jerrychen15487/-.-/fpga/docs/KEY2单一位流现场演示-2026-10-17.md

# KEY2 单一位流现场演示（2026-10-17）

> 此文保留首次已上板验证的“KEY2 短按四音测试”基线。新增长按回声的候选版
> 请参见 [KEY2 长按回声候选](KEY2长按回声候选-2026-10-17.md)；新候选
> 尚未上板，不能用本页的已验证结论代替其验收。

## 操作

- 上电／KEY0 复位后默认是正常演奏：电钢琴→ESP32→FPGA→音箱，KEY1 保持原来的画面切换与钢琴块暂停功能；SD 曲库、BLE 网站通信仍在工作。
- 短按 NEO Dock 板上的 KEY2 一次，进入四音频谱测试。无需弹琴，FPGA 内部约每 0.503 秒触发 G3、D4、A4、E5 四个音，沿用四声部 DDS、混音、FFT 和 HDMI 波形／频谱。即使此前停留在钢琴块页，测试时也强制显示频谱页。
- 再短按 KEY2 一次，返回正常演奏。切换时清除旧声部，避免演示和实琴残音叠加；正在按住的琴键要松开重按，才会重新发 Note On。
- KEY0 仍是复位，KEY1 原功能不变。摇杆三个按键目前接在 ESP32 一侧，本版不依赖它们，亦不要求改动 ESP32 固件或接线。

KEY2 是低有效的 Y12、1.5 V Bank 9 输入，约 10 ms 去抖；按住不会反复切换。SD 曲库控制器并不随模式切换复位，测试模式只切换音源及画面；测试时来自 ESP32 的 MIDI 仍可到达接收器，但不会进入音频声部分配器。曲库 UART 和 SD 访问仍继续。请不要在测试音播放时用钢琴弹奏判断 MIDI 是否正常，需先按 KEY2 返回演奏模式。

## 候选文件和验证范围

唯一合并候选位流：

`impl/pnr/midi_basic_synth_KEY2_INTEGRATED_CANDIDATE_2026-10-17.fs`

SHA-256：`00FD8D12518F0F753D42601936DCAAF342728666FEBC3F6AB9C898B4C1D00956`

隔离构建：`exp_timing/run_place2_key2_integrated_fix_20261017`，Gowin `gw_sh build.tcl` 退出码 0。50 MHz `sys_clk` 约束下 Fmax **54.310 MHz**，setup／hold 违例 **0／0**，CLS **24,168／29,952（81%）**；约束报告确认 KEY2 位于 **Y12/9、LVCMOS15、上拉**。按键去抖仿真通过。第一次合并构建出现 `timbre_select` 逻辑环路警告，已经将其改为固定异步上电复位、模式切换时同步设置；最终构建无该警告。

这是**静态时序和仿真通过、尚待实机验证的候选版**。先下载到 FPGA SRAM：确认上电可弹琴、KEY1 和网站仍正常；按 KEY2 自动响四音并看到多个分开的频谱峰；再按 KEY2 后重新弹琴正常。验证无误后，才考虑把同一位流写入 FPGA Flash 作为赛场上电版本。不要烧录旧的独立测试位流，也不要误选默认文件 `impl/pnr/midi_basic_synth.fs`。SD 卡不需清理或格式化。

已验证的回退位流为 `impl/pnr/midi_basic_synth_P2_SD_MOUNT_PREFETCH_52M_CANDIDATE_2026-10-17.fs`，SHA-256 `5730006B499B16DAFB9543A6A083903823B98C5666B3F99B16A9AB1B942EB75B`。
