jerrychen15487/-.-/fpga/docs/PCM5102A-I2S-接线与验收-2026-10-22.md

# PCM5102A 标准 I²S 链路：接线与验收

## 2026-10-24 实机状态

用户反馈：当前电钢琴输入下，PCM5102A 经 3.5 mm LINE OUT 接有源音箱已能**稳定发声**，原 PT8211 声路也正常。此前“只有向右掰音频插头才出声”的故障现象已消失；原因未通过拆检或通断测量单独确认，不能据此声称插座或焊点已被定位和修复。用户此前确认烧录的是 2026-10-22 19:41 的 `impl/pnr/midi_basic_synth.fs`；同内容副本封存为 `impl/pnr/midi_basic_synth_20261022_1941_PCM5102_USER_VERIFIED.fs`，SHA-256 `8479F2EDF73ECB4C0DDF4F70C60168FD5C2534DA671C8F4F285C80270A318534`。对应时序报告也同名前缀封存；报告显示系统域 Fmax 51.716 MHz、像素域 29.585 MHz、setup/hold 违例端点 0/0。这些是构建报告和用户实机反馈的组合，不是独立仪器测得的 I²S 波形。

当前 `src/top.v`、`src/pcm5102_i2s_tx.v`、`src/midi_basic_synth.cst` 的 SHA-256 分别为 `5D305ED6E8BA5A711EBAFFF07B18E54E436D2B3CCF998AC5E4E0AC74BE73136C`、`B3A379B4CA89F01CAD818B9F0D3DDC8315EBEF682045BB0C3BC609602A40AED7`、`8EB71322EA3CD0820E9834564D209BCA57A2E529738B128A4097FB30796688BB`；这些文件时间早于上述位流，但完整工程源清单未在此逐项封存。

因此“标准 I²S→外置 DAC→有源音箱发声”已有实机观察；**完整琴键输入→DAC 模拟输出 ≤10 ms** 及扩展 ≤5 ms/抖动仍未实测，不能由 FPGA 内部 GAO、ESP32 日志或本次听音推出。下一步优先保留接线照片、听音视频及同一版本的报告，具备合适仪器后再测完整链路延迟。

本改动保留 ESP32-S3、板载 PT8211 和扬声器原链路。FPGA 另外在 J8/PMOD1 输出标准 I²S，向外置 PCM5102A 提供与板载 DAC 相同的单声道样本（复制到 L/R）。不要将 PCM5102A 的 OUTL/OUTR 直接接到无源扬声器；它是线路电平输出，先接有源音箱或合适的耳机放大器，初次通电先调低音量。

## 实物接线

依据 `Tang_Mega_NEO_Dock-60K_31004_Schematics.pdf` 的 J8 与 PMOD1 管脚，结合用户模块照片上的丝印：

| FPGA NEO Dock J8 | FPGA 封装脚 | PCM5102A 模块 | 信号 |
|---|---|---|---|
| pin 11 | Y21 | BCK | 位时钟 3.125 MHz |
| pin 9 | AB21 | LCK（也称 LRCK/WS） | 左右声道时钟 48.828125 kHz |
| pin 7 | AA20 | DIN | 串行音频数据 |
| pin 3 或 4 | — | GND | 公共地 |

模块的 **VIN 接 5 V 电源**（照片所附模块资料标注 5 V），**不要接 J8 的 3.3 V 电源 pin 1/2**；同样绝不可把 5 V 接到 FPGA 的 BCK/LCK/DIN。用万用表确认供电极性与共地后再通电。若使用独立 5 V USB 电源，仍须把该电源地与 J8 GND 相连。ESP32 现有线路保持原样，J8 不与 ESP32 的 J9/PMOD0 线混接。

SCK 是 DAC 主时钟输入，本设计采用 PCM5102A 数据手册的 **BCK 内部 PLL 三线模式**，不从 FPGA 输出 SCK。该模式要求 SCK 保持在地电平。先断电用万用表核对模块 SCK 与 GND 是否已由板上电阻下拉；如果没有，需把模块 **SCK 接 GND**，不可让其悬空。若模块有 FMT/XSMT 引脚且未被板上电路固定，需使 FMT=低（标准 I²S）、XSMT=高（取消静音，必须是模块的 3.3 V 逻辑电源而非 5 V）。不要盲接照片中未焊出的配置焊盘，先检查模块实际电路与电压。

针对用户实际购买的 VIN/A3V3、H1L～H4L 版本，[芯路城模块资料](https://www.xinlucity.com/?s=resourcedetail/index/id/387.html)明确要求**四组焊桥各选一侧与中间焊盘短接**；未焊通可能无声或有杂音。以背面丝印正向观察，排障配置为：H1L（FLT）右＋中＝正常延迟、H2L（DEMP）右＋中＝关闭去加重、H3L（XSMT）左＋中＝取消静音、H4L（FMT）右＋中＝标准 I²S。每组不得把左、中、右三端全短接。网页所附简化原理图不是该模块原厂原理图，不能凭商品图认定实物焊桥已经导通；先断电目视检查，必要时用万用表测通断，不要盲目补焊。该版本的 A3V3 被厂家标为 3.3 V 输出，不接外部 5 V。详细来源与未确认事项见 [芯路城 387 资料核对](PCM5102A-芯路城387资料核对-2026-10-23.md)。

## 时序与软件配置

- 50 MHz 系统时钟，每 16 个系统时钟为一个 BCK 周期；64 个 BCK 为一个立体声帧。因此 BCK=3.125 MHz、LRCK=48.828125 kHz，与现有 1024 时钟/样本的合成速率一致，无需改 DDS 频率表。
- 每声道 32 位槽，前 16 位为有符号二补码样本，后 16 位为 0；LRCK 翻转后延迟 1 个 BCK 才发送 MSB，数据在 BCK 下降沿改变、上升沿被 DAC 采样。
- 数据手册规定 FMT 低选标准 I²S，XSMT 高为取消静音；三线模式需要 SCK 为低。`src/pcm5102_i2s_tx.v` 只负责数字串行化，模块引脚配置由硬件保证。
- `src/top.v` 同时驱动 `HP_*` 和 `PCM_*`；ESP32 固件、MIDI 消息和画面无需改变。

## 验收顺序

1. 未接 PCM5102A 时，先运行 `iverilog -g2012 -s tb_pcm5102_i2s_tx -o sim/tb_pcm5102_i2s_tx.vvp sim/tb_pcm5102_i2s_tx.v src/pcm5102_i2s_tx.v`，再运行 `vvp sim/tb_pcm5102_i2s_tx.vvp`。仿真应显示 `PASS`。
2. 在 Gowin GUI 中用当前工程重新综合、布局布线。只有 **系统域 Fmax ≥ 50 MHz、setup/hold 违例均为 0、无 unrouted nets** 时才烧录新位流；不能沿用旧 `.fs` 证明新接口已实现。构建前保留原已验证 `.fs` 的独立副本和 SHA-256。布局布线由用户在 GUI 执行。
3. 先只接地和 5 V，量模块 VIN 与 GND 电压。断电后接 BCK/LCK/DIN。不要热插拔排针。
4. 用逻辑分析仪在 J8 测 BCK、LCK、DIN：BCK 约 3.125 MHz、LCK 约 48.828 kHz；每个 LCK 半周 32 个 BCK；LCK 变化后一个 BCK 为 I²S 延迟位。先不接模拟输出也可以核对数字时序。
5. 把 OUTL/OUTR/GND 接有源音箱或线路输入，用电钢琴发 MIDI 60 持续音：应同时能从板载扬声器与外置 DAC 听到相同音高/音色；注意可能有不同的音量和 DAC 固有延迟。确认静音、音符释放、四复音、P/O/A 模式和效果器均未退化。
6. 留存 Gowin 时序报告、逻辑分析仪 I²S 波形、模块供电和接线照片、外置 DAC 实际发声视频。只有步骤 2–5 完成后才能把“标准 I²S→DAC 实机闭环”标为完成。完整“琴键至模拟输出 ≤10 ms”还需单独测量，不能由本仿真推出。
