jerrychen15487/-.-/fpga/docs/PCM5102A-芯路城387资料核对-2026-10-23.md

# PCM5102A 模块：芯路城 387 资料核对（2026-10-23）

范围：仅核对用户指定的[芯路城 PCM5102A 客户资料页](https://www.xinlucity.com/?s=resourcedetail/index/id/387.html)及其所附[TI PCM510xA 规格书](https://testxinlu.oss-cn-beijing.aliyuncs.com/static/upload/file/warehouse/2026/05/28/1779939874559971.pdf)。不把商品图当作用户实物焊接状态的证据，也不据此认定现有无声的根因。

## 经资料确认

| 项目 | 结论与本项目所需状态 | 来源 |
| --- | --- | --- |
| 模块电源 | 该客户资料所述模块供电为 **5 V**，`VIN` 是输入；`A3V3` 被标为模块 **3.3 V 输出**，不可当作 5 V 输入。`GND` 为数字公共地，`AGND` 为模拟输出参考地。 | [芯路城参数及引脚表](https://www.xinlucity.com/?s=resourcedetail/index/id/387.html) |
| 三线 I²S | 数字音频线为 `BCK`、`LRCK`、`DIN`，主控与 DAC 必须共地。TI 规格书第 9.3.5.3 节说明：无外部主时钟时，`SCK` 在 BCK/LRCK 正确运行期间保持接地，连续 16 个 LRCK 周期后内部 BCK PLL 才启动。因此本项目未提供 SCK 时，应**接 GND，而不是悬空**。 | [芯路城 FAQ](https://www.xinlucity.com/?s=resourcedetail/index/id/387.html)；[TI 规格书 §9.3.5.3](https://testxinlu.oss-cn-beijing.aliyuncs.com/static/upload/file/warehouse/2026/05/28/1779939874559971.pdf) |
| H1L～H4L 通则 | 此模块厂商资料明确说 **四组焊桥均须选一侧短接**，未短接可造成无声、杂音。资料定义为“左＋中＝高；右＋中＝低”。这里的左右应以背面丝印正向观察；每组三焊盘**不得全桥接**。 | [芯路城焊桥说明及 FAQ](https://www.xinlucity.com/?s=resourcedetail/index/id/387.html) |
| H1L = FLT | 左＋中：高、低延迟滤波；右＋中：低、正常延迟滤波。排障首选右＋中（正常），两者都不应悬空。 | [芯路城焊桥说明](https://www.xinlucity.com/?s=resourcedetail/index/id/387.html)；[TI 引脚定义](https://testxinlu.oss-cn-beijing.aliyuncs.com/static/upload/file/warehouse/2026/05/28/1779939874559971.pdf) |
| H2L = DEMP | 左＋中：高、44.1 kHz 去加重开启；右＋中：低、关闭。排障首选右＋中（关闭），两者都不应悬空。 | [芯路城焊桥说明](https://www.xinlucity.com/?s=resourcedetail/index/id/387.html)；[TI 引脚定义](https://testxinlu.oss-cn-beijing.aliyuncs.com/static/upload/file/warehouse/2026/05/28/1779939874559971.pdf) |
| H3L = XSMT | 左＋中：高、取消软静音；右＋中：低、软静音。**本项目须左＋中。** | [芯路城焊桥说明](https://www.xinlucity.com/?s=resourcedetail/index/id/387.html)；[TI 规格书 §9.3.3](https://testxinlu.oss-cn-beijing.aliyuncs.com/static/upload/file/warehouse/2026/05/28/1779939874559971.pdf) |
| H4L = FMT | 左＋中：高、左对齐；右＋中：低、标准 I²S。**本项目须右＋中。** | [芯路城焊桥说明](https://www.xinlucity.com/?s=resourcedetail/index/id/387.html)；[TI 规格书 §9.3.2.2](https://testxinlu.oss-cn-beijing.aliyuncs.com/static/upload/file/warehouse/2026/05/28/1779939874559971.pdf) |
| 模拟输出 | 板载 3.5 mm 插座为左右声道和模拟地，另引出 `LROUT` / `ROUT` / `AGND`。板卡资料声称额定输出约 2 VRMS。 | [芯路城参数与输出端说明](https://www.xinlucity.com/?s=resourcedetail/index/id/387.html) |

**对先前排障建议的修正：**此前“只核对 H3L/H4L，H1L/H2L 先不要动”不够完整。针对这份厂商资料，应在**断电状态**下检查 H1L、H2L 是否也各自可靠地选通一侧；若未焊通，它们是新增的可疑点。但不能凭网页断言用户手上四组焊桥已虚焊，是否导通需要实物近照或万用表通断测量。此次核对不要求盲目重焊。

## 仍未由资料确认

- 网页明确注明“**无厂家原厂原理图，图示仅为原理参考，和实物存在出入**”。因此不能把其简化原理图用于推断这块实物的每条 PCB 走线、3.5 mm 插座焊脚接触状态，或 H1L～H4L 的实际导通情况。[来源](https://www.xinlucity.com/?s=resourcedetail/index/id/387.html)
- 厂商所附 ESP32-S3 Arduino“小星星”例程只是可选的**独立模块隔离测试**：其 GPIO4/5/6 是例程自己的 I²S 引脚，**不是当前 FPGA→DAC 的接线定义**，也不证明目前 FPGA 排针有时钟输出。[来源](https://www.xinlucity.com/?s=resourcedetail/index/id/387.html)
- 厂商 FAQ 将“按压板才发声”归因于未共地，但用户当前已称共地、线缆正常。它是常见原因，不是对这块实物的诊断结果。[来源](https://www.xinlucity.com/?s=resourcedetail/index/id/387.html)
- 用户此前 H3L 左、H4L 右的描述与目标方向一致；**H1L/H2L 当前焊接状态、供电实际电压、SCK 电平、BCK/LRCK/DIN 实际波形、3.5 mm 插座连续性均未实测**。PT8211 正常仅说明原音频主链路工作，不能替代这些验证。

## 下一步无损检查顺序

1. 全部断电，目视核对 H1L～H4L 每组都有**仅一侧**与中心连接；目标可设为 H1L 右、H2L 右、H3L 左、H4L 右。先记录现状，切勿凭模糊照片改焊。
2. 检查 `VIN→5 V`、`GND→共地`、`SCK→GND`、`BCK/LRCK/DIN` 没有对调；不向 `A3V3` 输入电源。所有拔插均在断电下完成。
3. 若有万用表，断电测四组焊桥通断，上电测 VIN、XSMT、FMT、SCK 的直流电平；这些测量才能把“焊接方向正确”和“实际导通”区分开。
4. 若四组控制与供电均可靠仍无声，再查数字时钟与 3.5 mm 模拟支路；不因网页资料而修改已工作的 ESP32/PT8211 链路或重烧位流。
