jerrychen15487/-.-/fpga/docs/赛题二与团队联调要求原文核对-2026-10-17.md

# 赛题二与团队联调要求原文核对

核对日期：2026-10-17。本文只整理要求和出处，不根据文件存在推断功能已经通过实机验收。官方赛题、个人讲解 PPT、团队项目约定是三个不同层级。

## 资料优先级

1. 官方《全国大学生嵌入式芯片与系统设计竞赛'2026-高云半导体.pdf》，PDF 文件第 15–16 页（文内印刷页 13–14）：选题二原文；其中印刷页 14 还规定振荡器统计和现场验证。
2. `FPGA2026_pre2.pptx` 及同名 PDF，第 9–14 页：讲解者对选题二的转述、例子和建议，不是新的官方条款。第 14 页关于演奏维度的整理明确属于个人理解。若与官方原文冲突，按前者。
3. `团队资料/项目目标效果与实现方法(1).md`、`团队资料/FPGA开发与联调计划(1).md`、`esp32_local/PROTOCOL.md`：团队确定的产品目标、阶段验收和传输协议；不是官方评分细则。团队计划标注更新日 2026-10-11，部分目标已被后续资源取舍调整，应用当前工程与实测证据复核。

## 官方设计要求与基础指标

以下均来自官方 PDF 文件第 15 页（印刷页 13）；PPT PDF 第 9–11 页转述了这些内容。

| 编号 | 官方要求的可检验意思 | 需要注意的边界 |
|---|---|---|
| 设计总则 | FPGA 是核心并行计算平台，在 HDL 中逐样本、逐声部实时合成；允许波表采样、加法、FM、物理建模等算法；最终通过 **I²S 接口至 DAC** 发声 | 选用哪种算法不被固定，但音频生成不能搬到 ESP32/软核；I²S 是设计总则的明确输出路径，不应因其未列为基础条目的编号而忽略 |
| 基础 1 | 自主设计演奏交互形态，基于传感器精准采集动作，至少 **2 个独立可控维度**，逻辑稳定、适于演奏 | 原文举电容触摸、光电、压力、无接触手势等；未明确“现成 USB 电钢琴 + 自研摇杆”能否完全满足“自研交互”口径，需实物演示并向主办方确认，不能仅凭 PPT 的钢琴例子断言合规 |
| 基础 2 | FPGA HDL 完成完整音频生成通路，逐样本运算，控制信号到音频输出总延迟 **≤10 ms** | 必须测整条实际链路；仅 SPI 发送耗时或 FPGA 内部理论时延不等于总延迟 |
| 基础 3 | 基础复音 **≥4**，四路及以上独立声部同时发声；逐音逐样本生成，支持单音实时变调、ADSR、多声部混音 | 禁止直接播放预录 PCM、预置推流、整段录音触发；证明应包括同时可闻、变调/包络及 RTL 证据 |

“滑音/颤音”没有列在基础 1–3 的文字里，列在拓展 2 的表情效果中。基础 3 的“单音实时变调”仍需独立说明；它不能被误读为必须有专用弯音轮，但应能在音符发声过程中调整频率。

## 官方拓展指标与现场标准

均来自官方 PDF 文件第 15–16 页（印刷页 13–14），PPT PDF 第 12–13 页是转述。

| 编号 | 原文要求 | 验收解释 |
|---|---|---|
| 拓展 1 | **≥32 复音，或单音加法合成分量 ≥32 路，或多条并行物理建模运算单元** | 三种是“或”，不要求同时达成；不得把谐波表项自动都算成独立振荡器 |
| 拓展 2 | **≥3 维**演奏表情，力度动态、滑音、颤音等；**≥2 种乐器音色**自由切换；FPGA 内部实现混响、延迟、合唱等数字效果器 | 需要证明控制、两音色与真实 FPGA 效果处理，不能仅有静态标签；原文未规定每一种列举效果都必须同时实现 |
| 拓展 3 | 演奏延迟 **≤5 ms** 且确定性无抖动；FPGA 实时生成 LED 指引、李萨如、实时频谱、波形等可视化反馈 | 列举的画面是类型举例，不表示一个屏幕必须同时显示四类；≤5 ms 仍需整机实测和抖动数据 |
| 拓展 4 | 脱机演奏 LED 曲目指引；可搭蓝牙/手机 App，支持在线曲谱下载、键位自定义、录音回传等 | “可搭载”部分是可选增强。下载曲谱不等于已完成离线 LED 指引；谱面/钢琴块、练习判分是团队自加的较大产品目标 |
| 核心评分 1 | 完整独立振荡器须包含独立相位累加器、频率调控、包络；波表单次查表不按谐波计数；加法按运算分量、FM 按调制运算器、物理建模按并行弦/模态单元计 | 不能仅依据“4 声部 × 6 泛音 = 24”报官方独立振荡器数；需 RTL 对照具体结构及“同时活跃可闻”证据 |
| 核心评分 2 | 吞吐量按“**同时活跃可闻独立振荡器总数 × 实际音频输出采样率**” | 过采样不叠加加分；应记录实际采样率、实际可闻单元数 |
| 现场验证 | 测试模式输出多路不同频率，频谱显示对应数量独立谱峰，并用 RTL 证明纯硬件实时合成、无预录音频播放 | 单位流按键测试模式有助于此项，但最后仍应保存实测截图/视频和代码对应关系 |

官方 PDF 没有提供选题二逐项分值、100 分评分表或明确“做完基础即可得多少分”。不应凭 PPT 的经验性话语推定得分。

## 团队联调与产品约定，不能混作赛题基础

来源：`团队资料/FPGA开发与联调计划(1).md` 第 1–6 节、`团队资料/项目目标效果与实现方法(1).md` 第 1–2 节、`esp32_local/PROTOCOL.md` 第 2–3 节及附录 A。

| 阶段 | 团队验收目标 | 与赛题的关系 |
|---|---|---|
| F0 接口 | SPI/UART 接线、电平、存储容量/profile、无引脚冲突 | 工程集成前提 |
| F1 实时接收 | SPI Mode0、一次 CS 收 48 位、FIFO/READY 背压、本地时间戳；模拟/实琴数量和值一致，64 事件突发不丢 | 为 ≥4 复音、低延迟提供输入证据；不是独立官方指标 |
| F2 音源 | ≥4 声部、力度/ADSR/踏板、重复音和释放、混音、I²S/DAC、控制至音频 ≤10 ms | 与官方基础直接重叠；团队额外写明踏板和重复音细节 |
| F3 曲库传输 | UART v2 的 CAPS/STATUS/LIST/CRC/命令；非易失数据/进度、删除、断电续传、坏包不发布 | 拓展 4 和产品可靠性；团队原计划多首并存，后续单曲资源取舍要更新合同，不能以旧计划判当前版已经达到多首 |
| F4 阅读 | 本地选曲、五线谱/简谱 PAGE/BITMAP、HDMI；离线可阅读且弹琴 | 团队产品目标，不是官方基础 |
| F5 练习 | 三模式、BPM、钢琴块、谱面跟随、起音/保持释放/力度/踏板评分、暂停恢复 | 团队产品目标，不是官方评分指标 |
| F6 扩展 | ≥32 复音、≥2 音色、FPGA 音效和实时可视化；外部传感器滑音/颤音 | 对应官方拓展 1–3，但应逐项量化 |
| F7 终验 | 全模式、BLE 并发、长时、掉电/恢复、SPI 与整机时延、演示证据 | 系统性证明，尚须逐项目证据 |

协议另明确：ESP32 USB Host 将 USB-MIDI 变成 6 字节 SPI 事件；ESP32 SPI2 主机 GPIO12/11/10，READY GPIO13 高电平允许启动，双方 3.3 V 共地；曲库 UART1 为 1 Mbaud 全双工、BLE↔UART v2；PSC2 文件按 512 字节块传输。ESP32 只是代理，目录及持久进度应由 FPGA 负责。具体当前接线和固件构建配置仍以实物/工程核对，不用旧文档中的“未联调”历史状态覆盖新证据。

## 尚需澄清的口径

- 赛题设计要求和基础 1 都强调“自研交互”；团队文档把电钢琴输入列为已采用方案，但没有主办方书面确认此组合如何计创新/自研交互。后续摇杆/按键可加强自研部分。
- 官方“延迟 ≤5 ms 且确定性无抖动”未给测量起止点、测试负载、允许抖动绝对值；需记录自己的仪器、输入触发点、DAC/音箱测点、样本数、最大/最小，必要时咨询主办方。
- 官方对多条加法分量的计数口径需要 RTL 结构和同时可闻验证；不同于简单谐波数量。
- 团队 F3 多首/多未完成任务是原计划，而当前可能为单曲容量版。若以单曲版参赛，应更新团队 CAPS/演示预期并标明范围，不声称满足旧 F3 的多首矩阵。
