jerrychen15487/-.-/fpga/docs/四音频谱测试模式-2026-10-17.md

# 四音频谱测试模式（2026-10-17）

> 历史记录：下文描述的是早期“正常／测试两个位流”方案。现已整合为
> KEY2 切换的单一候选位流，赛场操作请以
> [KEY2 单位流演示说明](KEY2单一位流现场演示-2026-10-17.md)为准。

此模式专供赛题现场验证，不替代日常演奏位流。`top.v` 的
`SPECTRUM_TEST_MODE` 默认为 0；独立构建目录
`exp_timing/run_place2_spectrum_test_no_store` 仅把该参数设为 1。

测试模式让 FPGA 内部每约 0.503 秒向原有声部分配器发出四个
Note On：G3、D4、A4、E5（MIDI 55/62/69/76，力度 100）。四声部仍由
`basic_dds_synth` 逐样本实时生成和混音，使用现有风琴音色；并非播放
PCM 文件。频谱模块对音频做 16:1 降采样后的 64 点 FFT，理论频段间隔
约 47.68 Hz。这四个基频分别靠近第 4、6、9、14 号频段。

为了避免测试位流的时序被无关的 SD 曲库回复路径限制，测试模式关闭
曲库模块，SD-CS 保持高电平、时钟停止、网站串口 TX 保持空闲；所以
此模式下不能验证 MIDI 输入、网站 CAPS/LIST、曲谱预览。正常模式保留
上述功能，其构建源文件与主工程一致。

| 构建 | setup/hold 违例 | 50 MHz 系统时钟 Fmax | CLS |
| --- | ---: | ---: | ---: |
| 正常模式 | 0/0 | 52.671 MHz | 24087/29952 (81%) |
| 专用频谱测试模式 | 0/0 | 55.719 MHz | 13340/29952 (45%) |

`tb_spectrum_test_pattern` 检查两轮四音事件序列；
`tb_spectrum_test_audio` 连通真实四个 DDS、混音和 FFT，并在仿真的
第二帧确认 4/6/9/14 号频段均高于左右相邻频段。两项仿真通过。
这不等于已经完成实机屏幕和听感验收。

待实机烧录的唯一测试位流：
`impl/pnr/midi_basic_synth_SPECTRUM_4TONE_TEST_CANDIDATE_2026-10-17.fs`
（SHA-256 `5B8E6A5219FEC0429622FA1337551551C2FBE8D1757AD4F536AA0E932BB6F019`）。
下载到 SRAM 即可，不写 FPGA Flash，不清 SD 卡。预期无需弹琴也会
听到重复四音和弦，波形/频谱页出现四处独立基频峰。测试后烧回用户已
实机验证的正常位流
`impl/pnr/midi_basic_synth_P2_SD_MOUNT_PREFETCH_52M_CANDIDATE_2026-10-17.fs`
（SHA-256 `5730006B499B16DAFB9543A6A083903823B98C5666B3F99B16A9AB1B942EB75B`）。

本轮未修改 ESP32 固件、网站或 SD 卡内容，也未替用户烧录 FPGA。
