jerrychen15487/-.-/fpga/impl/pnr/midi_basic_synth_20261022_1941_PCM5102_USER_VERIFIED_tr_content.html

# Timing Messages

Report Title | Timing Analysis Report
Design File | C:\Users\ASUS\Desktop\FPGA_prpject\midi_basic_synth\impl\gwsynthesis\midi_basic_synth.vg
Physical Constraints File | C:\Users\ASUS\Desktop\FPGA_prpject\midi_basic_synth\src\midi_basic_synth.cst
Timing Constraint File | C:\Users\ASUS\Desktop\FPGA_prpject\midi_basic_synth\src\timing.sdc
Tool Version | V1.9.11.03 Education
Part Number | GW5AT-LV60PG484AC1/I0
Device | GW5AT-60
Device Version | B
Created Time | Thu Oct 22 19:41:09 2026
Legal Announcement | Copyright (C)2014-2025 Gowin Semiconductor Corporation. All rights reserved.

# Timing Summaries

## STA Tool Run Summary:

Setup Delay Model | Slow 0.855V 0C C1/I0
Hold Delay Model | Fast 0.945V 85C C1/I0
Numbers of Paths Analyzed | 82039
Numbers of Endpoints Analyzed | 58371
Numbers of Falling Endpoints | 0
Numbers of Setup Violated Endpoints | 0
Numbers of Hold Violated Endpoints | 0

## Clock Summary:

NO. | Clock Name | Type | Period | Frequency(MHz) | Rise | Fall | Source | Master | Objects
1 | sys_clk | Base | 20.000 | 50.000 | 0.000 | 10.000 | | | sys_clk
2 | pixel_clk | Generated | 40.000 | 25.000 | 0.000 | 20.000 | sys_clk | sys_clk | u_video_pll/u_plla/CLKOUT0
3 | serial_clk | Generated | 8.000 | 125.000 | 0.000 | 4.000 | sys_clk | sys_clk | u_video_pll/u_plla/CLKOUT1

## Max Frequency Summary:

NO. | Clock Name | Constraint | Actual Fmax | Logic Level | Entity
1 | sys_clk | 50.000(MHz) | 51.716(MHz) | 21 | TOP
2 | pixel_clk | 25.000(MHz) | 29.585(MHz) | 18 | TOP

#### No timing paths to get frequency of serial_clk!

## Total Negative Slack Summary:

Clock Name | Analysis Type | Endpoints TNS | Number of Endpoints
sys_clk | Setup | 0.000 | 0
sys_clk | Hold | 0.000 | 0
pixel_clk | Setup | 0.000 | 0
pixel_clk | Hold | 0.000 | 0
serial_clk | Setup | 0.000 | 0
serial_clk | Hold | 0.000 | 0

# Timing Details

## Path Slacks Table:

### Setup Paths Table

#### Report Command:report_timing -setup -max_paths 25 -max_common_paths 1

Path Number | Path Slack | From Node | To Node | From Clock | To Clock | Relation | Clock Skew | Data Delay
1 | 0.664 | u_score_store_sd/controller/page_reader/indexer/bitmap_offset_0_s1/Q | u_score_store_sd/controller/page_reader/sector_index_9_s1/D | sys_clk:[R] | sys_clk:[R] | 20.000 | 0.495 | 18.778
2 | 0.802 | u_score_store_sd/controller/page_reader/indexer/bitmap_offset_0_s1/Q | u_score_store_sd/controller/page_reader/stream_count_8_s1/CE | sys_clk:[R] | sys_clk:[R] | 20.000 | 0.495 | 18.391
3 | 0.802 | u_score_store_sd/controller/page_reader/indexer/bitmap_offset_0_s1/Q | u_score_store_sd/controller/page_reader/stream_count_9_s1/CE | sys_clk:[R] | sys_clk:[R] | 20.000 | 0.495 | 18.391
4 | 0.802 | u_score_store_sd/controller/page_reader/indexer/bitmap_offset_0_s1/Q | u_score_store_sd/controller/page_reader/stream_count_10_s1/CE | sys_clk:[R] | sys_clk:[R] | 20.000 | 0.495 | 18.391
5 | 0.802 | u_score_store_sd/controller/page_reader/indexer/bitmap_offset_0_s1/Q | u_score_store_sd/controller/page_reader/stream_count_13_s1/CE | sys_clk:[R] | sys_clk:[R] | 20.000 | 0.495 | 18.391
6 | 0.802 | u_score_store_sd/controller/page_reader/indexer/bitmap_offset_0_s1/Q | u_score_store_sd/controller/page_reader/stream_count_14_s1/CE | sys_clk:[R] | sys_clk:[R] | 20.000 | 0.495 | 18.391
7 | 0.812 | u_score_store_sd/controller/page_reader/indexer/bitmap_offset_0_s1/Q | u_score_store_sd/controller/page_reader/stream_count_4_s1/CE | sys_clk:[R] | sys_clk:[R] | 20.000 | 0.486 | 18.391
8 | 0.812 | u_score_store_sd/controller/page_reader/indexer/bitmap_offset_0_s1/Q | u_score_store_sd/controller/page_reader/stream_count_5_s1/CE | sys_clk:[R] | sys_clk:[R] | 20.000 | 0.486 | 18.391
9 | 0.812 | u_score_store_sd/controller/page_reader/indexer/bitmap_offset_0_s1/Q | u_score_store_sd/controller/page_reader/stream_count_6_s1/CE | sys_clk:[R] | sys_clk:[R] | 20.000 | 0.486 | 18.391
10 | 0.812 | u_score_store_sd/controller/page_reader/indexer/bitmap_offset_0_s1/Q | u_score_store_sd/controller/page_reader/stream_count_7_s1/CE | sys_clk:[R] | sys_clk:[R] | 20.000 | 0.486 | 18.391
11 | 0.855 | u_score_store_sd/controller/page_reader/indexer/bitmap_offset_0_s1/Q | u_score_store_sd/controller/page_reader/stream_count_1_s1/CE | sys_clk:[R] | sys_clk:[R] | 20.000 | 0.495 | 18.339
12 | 0.855 | u_score_store_sd/controller/page_reader/indexer/bitmap_offset_0_s1/Q | u_score_store_sd/controller/page_reader/stream_count_2_s1/CE | sys_clk:[R] | sys_clk:[R] | 20.000 | 0.495 | 18.339
13 | 0.855 | u_score_store_sd/controller/page_reader/indexer/bitmap_offset_0_s1/Q | u_score_store_sd/controller/page_reader/stream_count_3_s1/CE | sys_clk:[R] | sys_clk:[R] | 20.000 | 0.495 | 18.339
14 | 0.855 | u_score_store_sd/controller/page_reader/indexer/bitmap_offset_0_s1/Q | u_score_store_sd/controller/page_reader/stream_count_11_s1/CE | sys_clk:[R] | sys_clk:[R] | 20.000 | 0.495 | 18.339
15 | 0.855 | u_score_store_sd/controller/page_reader/indexer/bitmap_offset_0_s1/Q | u_score_store_sd/controller/page_reader/stream_count_12_s1/CE | sys_clk:[R] | sys_clk:[R] | 20.000 | 0.495 | 18.339
16 | 0.864 | u_score_store_sd/controller/page_reader/indexer/bitmap_offset_0_s1/Q | u_score_store_sd/controller/page_reader/stream_count_0_s1/CE | sys_clk:[R] | sys_clk:[R] | 20.000 | 0.486 | 18.339
17 | 0.864 | u_score_store_sd/controller/page_reader/indexer/bitmap_offset_0_s1/Q | u_score_store_sd/controller/page_reader/stream_count_15_s1/CE | sys_clk:[R] | sys_clk:[R] | 20.000 | 0.486 | 18.339
18 | 1.076 | u_score_store_sd/controller/page_reader/indexer/bitmap_offset_0_s1/Q | u_score_store_sd/controller/page_reader/sector_index_12_s1/D | sys_clk:[R] | sys_clk:[R] | 20.000 | 0.495 | 18.365
19 | 1.134 | u_score_store_sd/controller/page_reader/indexer/bitmap_offset_0_s1/Q | u_score_store_sd/controller/page_reader/byte_index_7_s1/CE | sys_clk:[R] | sys_clk:[R] | 20.000 | 0.495 | 18.060
20 | 1.134 | u_score_store_sd/controller/page_reader/indexer/bitmap_offset_0_s1/Q | u_score_store_sd/controller/page_reader/byte_index_8_s1/CE | sys_clk:[R] | sys_clk:[R] | 20.000 | 0.495 | 18.060
21 | 1.144 | u_score_store_sd/controller/page_reader/indexer/bitmap_offset_0_s1/Q | u_score_store_sd/controller/page_reader/byte_index_6_s1/CE | sys_clk:[R] | sys_clk:[R] | 20.000 | 0.504 | 18.040
22 | 1.174 | u_score_store_sd/controller/page_reader/indexer/bitmap_offset_0_s1/Q | u_score_store_sd/controller/page_reader/sector_index_3_s1/CE | sys_clk:[R] | sys_clk:[R] | 20.000 | 0.504 | 18.010
23 | 1.174 | u_score_store_sd/controller/page_reader/indexer/bitmap_offset_0_s1/Q | u_score_store_sd/controller/page_reader/sector_index_4_s1/CE | sys_clk:[R] | sys_clk:[R] | 20.000 | 0.504 | 18.010
24 | 1.174 | u_score_store_sd/controller/page_reader/indexer/bitmap_offset_0_s1/Q | u_score_store_sd/controller/page_reader/sector_index_5_s1/CE | sys_clk:[R] | sys_clk:[R] | 20.000 | 0.504 | 18.010
25 | 1.199 | u_score_store_sd/controller/page_reader/indexer/bitmap_offset_0_s1/Q | u_score_store_sd/controller/page_reader/streaming_s1/CE | sys_clk:[R] | sys_clk:[R] | 20.000 | 0.504 | 17.985

### Hold Paths Table

#### Report Command:report_timing -hold -max_paths 25 -max_common_paths 1

Path Number | Path Slack | From Node | To Node | From Clock | To Clock | Relation | Clock Skew | Data Delay
1 | 0.095 | u_score_page_cache/packed_index_9_s1/Q | u_score_page_cache/page_mem_page_mem_2_1_s/ADA[9] | sys_clk:[R] | sys_clk:[R] | 0.000 | -0.205 | 0.337
2 | 0.101 | u_score_page_cache/packed_index_1_s1/Q | u_score_page_cache/page_mem_page_mem_2_1_s/ADA[1] | sys_clk:[R] | sys_clk:[R] | 0.000 | -0.201 | 0.339
3 | 0.101 | u_score_page_cache/packed_index_9_s1/Q | u_score_page_cache/page_mem_page_mem_0_1_s/ADA[9] | sys_clk:[R] | sys_clk:[R] | 0.000 | -0.201 | 0.339
4 | 0.107 | u_score_page_cache/packed_index_1_s1/Q | u_score_page_cache/page_mem_page_mem_0_1_s/ADA[1] | sys_clk:[R] | sys_clk:[R] | 0.000 | -0.197 | 0.341
5 | 0.138 | u_score_page_cache/packed_index_13_s1/Q | u_score_page_cache/page_mem_page_mem_0_1_s/ADA[13] | sys_clk:[R] | sys_clk:[R] | 0.000 | -0.201 | 0.376
6 | 0.147 | u_score_page_cache/packed_index_12_s1/Q | u_score_page_cache/page_mem_page_mem_0_1_s/ADA[12] | sys_clk:[R] | sys_clk:[R] | 0.000 | -0.197 | 0.381
7 | 0.155 | u_score_page_cache/packed_index_5_s1/Q | u_score_page_cache/page_mem_page_mem_0_1_s/ADA[5] | sys_clk:[R] | sys_clk:[R] | 0.000 | -0.201 | 0.393
8 | 0.159 | u_score_page_cache/packed_index_3_s1/Q | u_score_page_cache/page_mem_page_mem_0_1_s/ADA[3] | sys_clk:[R] | sys_clk:[R] | 0.000 | -0.197 | 0.393
9 | 0.169 | u_score_page_cache/packed_index_7_s1/Q | u_score_page_cache/page_mem_page_mem_0_1_s/ADA[7] | sys_clk:[R] | sys_clk:[R] | 0.000 | -0.197 | 0.403
10 | 0.171 | u_score_page_cache/packed_index_11_s1/Q | u_score_page_cache/page_mem_page_mem_2_1_s/ADA[11] | sys_clk:[R] | sys_clk:[R] | 0.000 | -0.205 | 0.413
11 | 0.172 | u_score_page_cache/packed_index_7_s1/Q | u_score_page_cache/page_mem_page_mem_2_1_s/ADA[7] | sys_clk:[R] | sys_clk:[R] | 0.000 | -0.201 | 0.410
12 | 0.173 | u_score_page_cache/packed_index_11_s1/Q | u_score_page_cache/page_mem_page_mem_0_1_s/ADA[11] | sys_clk:[R] | sys_clk:[R] | 0.000 | -0.201 | 0.411
13 | 0.183 | u_score_page_cache/packed_index_2_s1/Q | u_score_page_cache/page_mem_page_mem_2_1_s/ADA[2] | sys_clk:[R] | sys_clk:[R] | 0.000 | -0.201 | 0.421
14 | 0.183 | pitch_bend_4_s0/Q | pitch_bend_q1_0_s10/DI[0] | sys_clk:[R] | sys_clk:[R] | 0.000 | -0.004 | 0.237
15 | 0.187 | pitch_bend_11_s0/Q | pitch_bend_q1_0_s12/DI[3] | sys_clk:[R] | sys_clk:[R] | 0.000 | 0.000 | 0.237
16 | 0.187 | pitch_bend_10_s0/Q | pitch_bend_q1_0_s12/DI[2] | sys_clk:[R] | sys_clk:[R] | 0.000 | 0.000 | 0.237
17 | 0.187 | pitch_bend_9_s0/Q | pitch_bend_q1_0_s12/DI[1] | sys_clk:[R] | sys_clk:[R] | 0.000 | 0.000 | 0.237
18 | 0.187 | pitch_bend_8_s0/Q | pitch_bend_q1_0_s12/DI[0] | sys_clk:[R] | sys_clk:[R] | 0.000 | 0.000 | 0.237
19 | 0.187 | pitch_bend_3_s0/Q | pitch_bend_q1_0_s8/DI[3] | sys_clk:[R] | sys_clk:[R] | 0.000 | 0.000 | 0.237
20 | 0.187 | pitch_bend_2_s0/Q | pitch_bend_q1_0_s8/DI[2] | sys_clk:[R] | sys_clk:[R] | 0.000 | 0.000 | 0.237
21 | 0.191 | pitch_bend_13_s0/Q | pitch_bend_q1_0_s14/DI[1] | sys_clk:[R] | sys_clk:[R] | 0.000 | 0.004 | 0.237
22 | 0.191 | pitch_bend_12_s0/Q | pitch_bend_q1_0_s14/DI[0] | sys_clk:[R] | sys_clk:[R] | 0.000 | 0.004 | 0.237
23 | 0.191 | pitch_bend_5_s0/Q | pitch_bend_q1_0_s10/DI[1] | sys_clk:[R] | sys_clk:[R] | 0.000 | 0.004 | 0.237
24 | 0.191 | pitch_bend_1_s0/Q | pitch_bend_q1_0_s8/DI[1] | sys_clk:[R] | sys_clk:[R] | 0.000 | 0.004 | 0.237
25 | 0.191 | pitch_bend_0_s0/Q | pitch_bend_q1_0_s8/DI[0] | sys_clk:[R] | sys_clk:[R] | 0.000 | 0.004 | 0.237

### Recovery Paths Table

#### Report Command:report_timing -recovery -max_paths 25 -max_common_paths 1

Path Number | Path Slack | From Node | To Node | From Clock | To Clock | Relation | Clock Skew | Data Delay
1 | 11.579 | por_count_5_s0/Q | u_pattern/sample_index_14_s0/CLEAR | sys_clk:[R] | sys_clk:[R] | 20.000 | 0.009 | 8.064
2 | 11.579 | por_count_5_s0/Q | u_pattern/sample_index_10_s0/CLEAR | sys_clk:[R] | sys_clk:[R] | 20.000 | 0.009 | 8.064
3 | 11.579 | por_count_5_s0/Q | u_pattern/sample_index_11_s0/CLEAR | sys_clk:[R] | sys_clk:[R] | 20.000 | 0.009 | 8.064
4 | 11.579 | por_count_5_s0/Q | u_pattern/sample_index_12_s0/CLEAR | sys_clk:[R] | sys_clk:[R] | 20.000 | 0.009 | 8.064
5 | 11.579 | por_count_5_s0/Q | u_pattern/sample_index_13_s0/CLEAR | sys_clk:[R] | sys_clk:[R] | 20.000 | 0.009 | 8.064
6 | 11.716 | por_count_5_s0/Q | u_pattern/sample_index_7_s0/CLEAR | sys_clk:[R] | sys_clk:[R] | 20.000 | 0.019 | 7.918
7 | 11.716 | por_count_5_s0/Q | u_pattern/sample_index_8_s0/CLEAR | sys_clk:[R] | sys_clk:[R] | 20.000 | 0.019 | 7.918
8 | 11.716 | por_count_5_s0/Q | u_pattern/sample_index_9_s0/CLEAR | sys_clk:[R] | sys_clk:[R] | 20.000 | 0.019 | 7.918
9 | 11.788 | por_count_5_s0/Q | u_pattern/sample_index_4_s0/CLEAR | sys_clk:[R] | sys_clk:[R] | 20.000 | 0.019 | 7.846
10 | 11.788 | por_count_5_s0/Q | u_pattern/sample_index_5_s0/CLEAR | sys_clk:[R] | sys_clk:[R] | 20.000 | 0.019 | 7.846
11 | 11.788 | por_count_5_s0/Q | u_pattern/sample_index_6_s0/CLEAR | sys_clk:[R] | sys_clk:[R] | 20.000 | 0.019 | 7.846
12 | 11.984 | por_count_5_s0/Q | u_pattern/sample_index_0_s0/CLEAR | sys_clk:[R] | sys_clk:[R] | 20.000 | 0.009 | 7.659
13 | 11.984 | por_count_5_s0/Q | u_pattern/sample_index_1_s0/CLEAR | sys_clk:[R] | sys_clk:[R] | 20.000 | 0.009 | 7.659
14 | 11.984 | por_count_5_s0/Q | u_pattern/sample_index_2_s0/CLEAR | sys_clk:[R] | sys_clk:[R] | 20.000 | 0.009 | 7.659
15 | 11.984 | por_count_5_s0/Q | u_pattern/sample_index_3_s0/CLEAR | sys_clk:[R] | sys_clk:[R] | 20.000 | 0.009 | 7.659
16 | 12.648 | por_count_5_s0/Q | u_voice0/n1091_s2/RESET[0] | sys_clk:[R] | sys_clk:[R] | 20.000 | 0.019 | 6.772
17 | 12.648 | por_count_5_s0/Q | u_piano32_poly_synth/harmonic_product_33_s1/RESET[0] | sys_clk:[R] | sys_clk:[R] | 20.000 | 0.019 | 6.772
18 | 12.658 | por_count_5_s0/Q | u_fft64_spectrum/mul_rc_39_s1/RESET[0] | sys_clk:[R] | sys_clk:[R] | 20.000 | 0.019 | 6.763
19 | 12.658 | por_count_5_s0/Q | u_voice3/piano_color_blend_product_26_s1/RESET[0] | sys_clk:[R] | sys_clk:[R] | 20.000 | 0.019 | 6.763
20 | 12.658 | por_count_5_s0/Q | u_voice2/n612_s2/RESET[0] | sys_clk:[R] | sys_clk:[R] | 20.000 | 0.019 | 6.763
21 | 12.658 | por_count_5_s0/Q | u_voice2/n338_s2/RESET[0] | sys_clk:[R] | sys_clk:[R] | 20.000 | 0.019 | 6.763
22 | 12.658 | por_count_5_s0/Q | u_voice1/n612_s2/RESET[0] | sys_clk:[R] | sys_clk:[R] | 20.000 | 0.019 | 6.763
23 | 12.658 | por_count_5_s0/Q | u_voice1/n338_s2/RESET[0] | sys_clk:[R] | sys_clk:[R] | 20.000 | 0.019 | 6.763
24 | 12.658 | por_count_5_s0/Q | u_voice0/velocity_product_24_s0/RESET[0] | sys_clk:[R] | sys_clk:[R] | 20.000 | 0.019 | 6.763
25 | 12.658 | por_count_5_s0/Q | u_piano32_poly_synth/step_product_53_s1/RESET[0] | sys_clk:[R] | sys_clk:[R] | 20.000 | 0.009 | 6.772

### Removal Paths Table

#### Report Command:report_timing -removal -max_paths 25 -max_common_paths 1

Path Number | Path Slack | From Node | To Node | From Clock | To Clock | Relation | Clock Skew | Data Delay
1 | 1.060 | u_spectrum_mode_key/test_mode_s0/Q | u_pattern/sample_index_0_s0/CLEAR | sys_clk:[R] | sys_clk:[R] | 0.000 | 0.004 | 1.003
2 | 1.060 | u_spectrum_mode_key/test_mode_s0/Q | u_pattern/sample_index_1_s0/CLEAR | sys_clk:[R] | sys_clk:[R] | 0.000 | 0.004 | 1.003
3 | 1.060 | u_spectrum_mode_key/test_mode_s0/Q | u_pattern/sample_index_2_s0/CLEAR | sys_clk:[R] | sys_clk:[R] | 0.000 | 0.004 | 1.003
4 | 1.060 | u_spectrum_mode_key/test_mode_s0/Q | u_pattern/sample_index_3_s0/CLEAR | sys_clk:[R] | sys_clk:[R] | 0.000 | 0.004 | 1.003
5 | 1.159 | u_spectrum_mode_key/test_mode_s0/Q | u_pattern/sample_index_4_s0/CLEAR | sys_clk:[R] | sys_clk:[R] | 0.000 | 0.008 | 1.098
6 | 1.159 | u_spectrum_mode_key/test_mode_s0/Q | u_pattern/sample_index_5_s0/CLEAR | sys_clk:[R] | sys_clk:[R] | 0.000 | 0.008 | 1.098
7 | 1.159 | u_spectrum_mode_key/test_mode_s0/Q | u_pattern/sample_index_6_s0/CLEAR | sys_clk:[R] | sys_clk:[R] | 0.000 | 0.008 | 1.098
8 | 1.177 | u_spectrum_mode_key/test_mode_s0/Q | u_pattern/sample_index_7_s0/CLEAR | sys_clk:[R] | sys_clk:[R] | 0.000 | 0.008 | 1.116
9 | 1.177 | u_spectrum_mode_key/test_mode_s0/Q | u_pattern/sample_index_8_s0/CLEAR | sys_clk:[R] | sys_clk:[R] | 0.000 | 0.008 | 1.116
10 | 1.177 | u_spectrum_mode_key/test_mode_s0/Q | u_pattern/sample_index_9_s0/CLEAR | sys_clk:[R] | sys_clk:[R] | 0.000 | 0.008 | 1.116
11 | 1.265 | u_spectrum_mode_key/test_mode_s0/Q | u_pattern/sample_index_14_s0/CLEAR | sys_clk:[R] | sys_clk:[R] | 0.000 | 0.004 | 1.208
12 | 1.265 | u_spectrum_mode_key/test_mode_s0/Q | u_pattern/sample_index_10_s0/CLEAR | sys_clk:[R] | sys_clk:[R] | 0.000 | 0.004 | 1.208
13 | 1.265 | u_spectrum_mode_key/test_mode_s0/Q | u_pattern/sample_index_11_s0/CLEAR | sys_clk:[R] | sys_clk:[R] | 0.000 | 0.004 | 1.208
14 | 1.265 | u_spectrum_mode_key/test_mode_s0/Q | u_pattern/sample_index_12_s0/CLEAR | sys_clk:[R] | sys_clk:[R] | 0.000 | 0.004 | 1.208
15 | 1.265 | u_spectrum_mode_key/test_mode_s0/Q | u_pattern/sample_index_13_s0/CLEAR | sys_clk:[R] | sys_clk:[R] | 0.000 | 0.004 | 1.208
16 | 1.652 | spectrum_test_previous_s0/Q | u_piano32_poly_synth/phase_h_q_0_s0/CLEAR | sys_clk:[R] | sys_clk:[R] | 0.000 | -0.193 | 1.792
17 | 1.652 | spectrum_test_previous_s0/Q | u_piano32_poly_synth/phase_h_q_18_s0/CLEAR | sys_clk:[R] | sys_clk:[R] | 0.000 | -0.197 | 1.796
18 | 1.652 | spectrum_test_previous_s0/Q | u_piano32_poly_synth/phase_h_q_30_s0/CLEAR | sys_clk:[R] | sys_clk:[R] | 0.000 | -0.193 | 1.792
19 | 1.652 | spectrum_test_previous_s0/Q | u_piano32_poly_synth/partial_limit_0_s0/CLEAR | sys_clk:[R] | sys_clk:[R] | 0.000 | -0.197 | 1.796
20 | 1.657 | spectrum_test_previous_s0/Q | u_piano32_poly_synth/phase_h_q_11_s0/CLEAR | sys_clk:[R] | sys_clk:[R] | 0.000 | -0.197 | 1.801
21 | 1.657 | spectrum_test_previous_s0/Q | u_piano32_poly_synth/phase_h_q_21_s0/CLEAR | sys_clk:[R] | sys_clk:[R] | 0.000 | -0.197 | 1.801
22 | 1.657 | spectrum_test_previous_s0/Q | u_piano32_poly_synth/phase_h_q_6_s0/CLEAR | sys_clk:[R] | sys_clk:[R] | 0.000 | -0.193 | 1.797
23 | 1.657 | spectrum_test_previous_s0/Q | u_piano32_poly_synth/phase_h_q_16_s0/CLEAR | sys_clk:[R] | sys_clk:[R] | 0.000 | -0.193 | 1.797
24 | 1.657 | spectrum_test_previous_s0/Q | u_piano32_poly_synth/phase_h_q_31_s0/CLEAR | sys_clk:[R] | sys_clk:[R] | 0.000 | -0.193 | 1.797
25 | 1.658 | spectrum_test_previous_s0/Q | u_piano32_poly_synth/partial_limit_1_s0/CLEAR | sys_clk:[R] | sys_clk:[R] | 0.000 | -0.201 | 1.805

## Minimum Pulse Width Table:

Number | Slack | Actual Width | Required Width | Type | Clock | Objects

#### Report Command:report_min_pulse_width -nworst 10 -detail

1 | 6.914 | 7.914 | 1.000 | Low Pulse Width | sys_clk | u_score_page_cache/page_mem_page_mem_0_5_s
2 | 6.914 | 7.914 | 1.000 | Low Pulse Width | sys_clk | u_score_page_cache/page_mem_page_mem_2_1_s
3 | 6.914 | 7.914 | 1.000 | Low Pulse Width | sys_clk | u_score_page_cache/page_mem_page_mem_2_3_s
4 | 6.914 | 7.914 | 1.000 | Low Pulse Width | sys_clk | u_score_page_cache/page_mem_page_mem_2_7_s
5 | 6.919 | 7.919 | 1.000 | Low Pulse Width | sys_clk | u_piano32_poly_synth/gowin_add_SDPB_phase_mem_phase_mem_0_0_s
6 | 6.919 | 7.919 | 1.000 | Low Pulse Width | sys_clk | u_piano32_poly_synth/phase_mem_phase_mem_0_0_s
7 | 6.919 | 7.919 | 1.000 | Low Pulse Width | sys_clk | u_score_page_cache/page_mem_page_mem_0_1_s
8 | 6.919 | 7.919 | 1.000 | Low Pulse Width | sys_clk | u_score_page_cache/page_mem_page_mem_0_7_s
9 | 6.919 | 7.919 | 1.000 | Low Pulse Width | sys_clk | u_score_page_cache/page_mem_page_mem_1_1_s
10 | 6.919 | 7.919 | 1.000 | Low Pulse Width | sys_clk | u_score_page_cache/page_mem_page_mem_1_3_s

## Timing Report By Analysis Type:

### Setup Analysis Report

#### Report Command:report_timing -setup -max_paths 25 -max_common_paths 1

### Path1

Path Summary:

Slack | 0.664
Data Arrival Time | 23.126
Data Required Time | 23.789
From | u_score_store_sd/controller/page_reader/indexer/bitmap_offset_0_s1
To | u_score_store_sd/controller/page_reader/sector_index_9_s1
Launch Clk | sys_clk:[R]
Latch Clk | sys_clk:[R]

Data Arrival Path:

AT | DELAY | TYPE | RF | FANOUT | LOC | NODE
0.000 | 0.000 | | | | | active clock edge time
0.000 | 0.000 | | | | | sys_clk
0.000 | 0.000 | tCL | RR | 1 | IOB117[B] | sys_clk_ibuf/I
0.683 | 0.683 | tINS | RR | 13930 | IOB117[B] | sys_clk_ibuf/O
4.348 | 3.666 | tNET | RR | 1 | R35C55[0][A] | u_score_store_sd/controller/page_reader/indexer/bitmap_offset_0_s1/CLK
4.731 | 0.382 | tC2Q | RR | 4 | R35C55[0][A] | u_score_store_sd/controller/page_reader/indexer/bitmap_offset_0_s1/Q
8.989 | 4.259 | tNET | RR | 2 | R51C54[0][A] | u_score_store_sd/controller/page_reader/n552_s64/CIN
9.039 | 0.050 | tINS | RR | 1 | R51C54[0][A] | u_score_store_sd/controller/page_reader/n552_s64/COUT
9.039 | 0.000 | tNET | RR | 2 | R51C54[0][B] | u_score_store_sd/controller/page_reader/n552_s65/CIN
9.089 | 0.050 | tINS | RR | 1 | R51C54[0][B] | u_score_store_sd/controller/page_reader/n552_s65/COUT
9.089 | 0.000 | tNET | RR | 2 | R51C54[1][A] | u_score_store_sd/controller/page_reader/n552_s66/CIN
9.139 | 0.050 | tINS | RR | 1 | R51C54[1][A] | u_score_store_sd/controller/page_reader/n552_s66/COUT
9.139 | 0.000 | tNET | RR | 2 | R51C54[1][B] | u_score_store_sd/controller/page_reader/n552_s67/CIN
9.189 | 0.050 | tINS | RR | 1 | R51C54[1][B] | u_score_store_sd/controller/page_reader/n552_s67/COUT
9.189 | 0.000 | tNET | RR | 2 | R51C54[2][A] | u_score_store_sd/controller/page_reader/n552_s68/CIN
9.239 | 0.050 | tINS | RR | 1 | R51C54[2][A] | u_score_store_sd/controller/page_reader/n552_s68/COUT
9.239 | 0.000 | tNET | RR | 2 | R51C54[2][B] | u_score_store_sd/controller/page_reader/n552_s69/CIN
9.289 | 0.050 | tINS | RR | 1 | R51C54[2][B] | u_score_store_sd/controller/page_reader/n552_s69/COUT
9.289 | 0.000 | tNET | RR | 2 | R51C55[0][A] | u_score_store_sd/controller/page_reader/n552_s70/CIN
9.339 | 0.050 | tINS | RR | 1 | R51C55[0][A] | u_score_store_sd/controller/page_reader/n552_s70/COUT
9.339 | 0.000 | tNET | RR | 2 | R51C55[0][B] | u_score_store_sd/controller/page_reader/n552_s71/CIN
9.389 | 0.050 | tINS | RR | 1 | R51C55[0][B] | u_score_store_sd/controller/page_reader/n552_s71/COUT
9.826 | 0.436 | tNET | RR | 1 | R49C55[2][A] | u_score_store_sd/controller/page_reader/n1468_s121/I1
10.287 | 0.461 | tINS | RR | 1 | R49C55[2][A] | u_score_store_sd/controller/page_reader/n1468_s121/F
10.444 | 0.157 | tNET | RR | 1 | R48C55[3][B] | u_score_store_sd/controller/page_reader/n1468_s119/I1
10.942 | 0.498 | tINS | RR | 1 | R48C55[3][B] | u_score_store_sd/controller/page_reader/n1468_s119/F
10.944 | 0.003 | tNET | RR | 1 | R48C55[1][B] | u_score_store_sd/controller/page_reader/n1468_s115/I0
11.471 | 0.526 | tINS | RR | 1 | R48C55[1][B] | u_score_store_sd/controller/page_reader/n1468_s115/F
11.774 | 0.304 | tNET | RR | 1 | R46C55[3][A] | u_score_store_sd/controller/page_reader/n1468_s104/I1
12.296 | 0.521 | tINS | RR | 6 | R46C55[3][A] | u_score_store_sd/controller/page_reader/n1468_s104/F
12.952 | 0.656 | tNET | RR | 1 | R50C55[0][B] | u_score_store_sd/controller/page_reader/n1468_s95/I1
13.478 | 0.526 | tINS | RR | 1 | R50C55[0][B] | u_score_store_sd/controller/page_reader/n1468_s95/F
13.481 | 0.003 | tNET | RR | 1 | R50C55[2][A] | u_score_store_sd/controller/page_reader/n1468_s85/I2
13.997 | 0.516 | tINS | RR | 3 | R50C55[2][A] | u_score_store_sd/controller/page_reader/n1468_s85/F
14.484 | 0.487 | tNET | RR | 1 | R49C54[1][B] | u_score_store_sd/controller/page_reader/n1468_s81/I0
15.001 | 0.516 | tINS | RR | 1 | R49C54[1][B] | u_score_store_sd/controller/page_reader/n1468_s81/F
15.158 | 0.157 | tNET | RR | 1 | R50C54[1][A] | u_score_store_sd/controller/page_reader/n1468_s79/I0
15.674 | 0.516 | tINS | RR | 1 | R50C54[1][A] | u_score_store_sd/controller/page_reader/n1468_s79/F
15.677 | 0.003 | tNET | RR | 1 | R50C54[1][B] | u_score_store_sd/controller/page_reader/n1468_s74/I1
15.939 | 0.262 | tINS | RR | 2 | R50C54[1][B] | u_score_store_sd/controller/page_reader/n1468_s74/F
16.099 | 0.160 | tNET | RR | 1 | R49C54[2][B] | u_score_store_sd/controller/page_reader/n1468_s72/I2
16.626 | 0.526 | tINS | RR | 1 | R49C54[2][B] | u_score_store_sd/controller/page_reader/n1468_s72/F
16.628 | 0.003 | tNET | RR | 1 | R49C54[3][A] | u_score_store_sd/controller/page_reader/n1468_s64/I2
17.126 | 0.498 | tINS | RR | 2 | R49C54[3][A] | u_score_store_sd/controller/page_reader/n1468_s64/F
17.666 | 0.540 | tNET | RR | 1 | R52C54[1][A] | u_score_store_sd/controller/page_reader/n1468_s51/I1
17.928 | 0.262 | tINS | RR | 3 | R52C54[1][A] | u_score_store_sd/controller/page_reader/n1468_s51/F
18.416 | 0.487 | tNET | RR | 1 | R50C53[3][B] | u_score_store_sd/controller/page_reader/n1468_s42/I0
18.913 | 0.498 | tINS | RR | 1 | R50C53[3][B] | u_score_store_sd/controller/page_reader/n1468_s42/F
19.071 | 0.157 | tNET | RR | 1 | R50C52[3][B] | u_score_store_sd/controller/page_reader/n1468_s36/I0
19.592 | 0.521 | tINS | RR | 3 | R50C52[3][B] | u_score_store_sd/controller/page_reader/n1468_s36/F
19.944 | 0.352 | tNET | RR | 1 | R48C52[2][B] | u_score_store_sd/controller/page_reader/n1482_s38/I0
20.471 | 0.526 | tINS | RR | 11 | R48C52[2][B] | u_score_store_sd/controller/page_reader/n1482_s38/F
21.713 | 1.243 | tNET | RR | 1 | R51C55[2][B] | u_score_store_sd/controller/page_reader/n1485_s29/I1
22.239 | 0.526 | tINS | RR | 1 | R51C55[2][B] | u_score_store_sd/controller/page_reader/n1485_s29/F
22.604 | 0.365 | tNET | RR | 1 | R51C57[3][A] | u_score_store_sd/controller/page_reader/n1485_s27/I1
23.126 | 0.521 | tINS | RR | 1 | R51C57[3][A] | u_score_store_sd/controller/page_reader/n1485_s27/F
23.126 | 0.000 | tNET | RR | 1 | R51C57[3][A] | u_score_store_sd/controller/page_reader/sector_index_9_s1/D

Data Required Path:

AT | DELAY | TYPE | RF | FANOUT | LOC | NODE
20.000 | 20.000 | | | | | active clock edge time
20.000 | 0.000 | | | | | sys_clk
20.000 | 0.000 | tCL | RR | 1 | IOB117[B] | sys_clk_ibuf/I
20.683 | 0.683 | tINS | RR | 13930 | IOB117[B] | sys_clk_ibuf/O
23.853 | 3.171 | tNET | RR | 1 | R51C57[3][A] | u_score_store_sd/controller/page_reader/sector_index_9_s1/CLK
23.789 | -0.064 | tSu | | 1 | R51C57[3][A] | u_score_store_sd/controller/page_reader/sector_index_9_s1

Path Statistics:

Clock Skew | -0.495
Setup Relationship | 20.000
Logic Level | 21
Arrival Clock Path Delay | cell: 0.683, 15.696%; route: 3.666, 84.304%
Arrival Data Path Delay | cell: 8.622, 45.919%; route: 9.773, 52.044%; tC2Q: 0.382, 2.037%
Required Clock Path Delay | cell: 0.683, 17.713%; route: 3.171, 82.287%

### Path2

Path Summary:

Slack | 0.802
Data Arrival Time | 22.739
Data Required Time | 23.542
From | u_score_store_sd/controller/page_reader/indexer/bitmap_offset_0_s1
To | u_score_store_sd/controller/page_reader/stream_count_8_s1
Launch Clk | sys_clk:[R]
Latch Clk | sys_clk:[R]

Data Arrival Path:

AT | DELAY | TYPE | RF | FANOUT | LOC | NODE
0.000 | 0.000 | | | | | active clock edge time
0.000 | 0.000 | | | | | sys_clk
0.000 | 0.000 | tCL | RR | 1 | IOB117[B] | sys_clk_ibuf/I
0.683 | 0.683 | tINS | RR | 13930 | IOB117[B] | sys_clk_ibuf/O
4.348 | 3.666 | tNET | RR | 1 | R35C55[0][A] | u_score_store_sd/controller/page_reader/indexer/bitmap_offset_0_s1/CLK
4.731 | 0.382 | tC2Q | RR | 4 | R35C55[0][A] | u_score_store_sd/controller/page_reader/indexer/bitmap_offset_0_s1/Q
8.989 | 4.259 | tNET | RR | 2 | R51C54[0][A] | u_score_store_sd/controller/page_reader/n552_s64/CIN
9.039 | 0.050 | tINS | RR | 1 | R51C54[0][A] | u_score_store_sd/controller/page_reader/n552_s64/COUT
9.039 | 0.000 | tNET | RR | 2 | R51C54[0][B] | u_score_store_sd/controller/page_reader/n552_s65/CIN
9.089 | 0.050 | tINS | RR | 1 | R51C54[0][B] | u_score_store_sd/controller/page_reader/n552_s65/COUT
9.089 | 0.000 | tNET | RR | 2 | R51C54[1][A] | u_score_store_sd/controller/page_reader/n552_s66/CIN
9.139 | 0.050 | tINS | RR | 1 | R51C54[1][A] | u_score_store_sd/controller/page_reader/n552_s66/COUT
9.139 | 0.000 | tNET | RR | 2 | R51C54[1][B] | u_score_store_sd/controller/page_reader/n552_s67/CIN
9.189 | 0.050 | tINS | RR | 1 | R51C54[1][B] | u_score_store_sd/controller/page_reader/n552_s67/COUT
9.189 | 0.000 | tNET | RR | 2 | R51C54[2][A] | u_score_store_sd/controller/page_reader/n552_s68/CIN
9.239 | 0.050 | tINS | RR | 1 | R51C54[2][A] | u_score_store_sd/controller/page_reader/n552_s68/COUT
9.239 | 0.000 | tNET | RR | 2 | R51C54[2][B] | u_score_store_sd/controller/page_reader/n552_s69/CIN
9.289 | 0.050 | tINS | RR | 1 | R51C54[2][B] | u_score_store_sd/controller/page_reader/n552_s69/COUT
9.289 | 0.000 | tNET | RR | 2 | R51C55[0][A] | u_score_store_sd/controller/page_reader/n552_s70/CIN
9.339 | 0.050 | tINS | RR | 1 | R51C55[0][A] | u_score_store_sd/controller/page_reader/n552_s70/COUT
9.339 | 0.000 | tNET | RR | 2 | R51C55[0][B] | u_score_store_sd/controller/page_reader/n552_s71/CIN
9.389 | 0.050 | tINS | RR | 1 | R51C55[0][B] | u_score_store_sd/controller/page_reader/n552_s71/COUT
9.826 | 0.436 | tNET | RR | 1 | R49C55[2][A] | u_score_store_sd/controller/page_reader/n1468_s121/I1
10.287 | 0.461 | tINS | RR | 1 | R49C55[2][A] | u_score_store_sd/controller/page_reader/n1468_s121/F
10.444 | 0.157 | tNET | RR | 1 | R48C55[3][B] | u_score_store_sd/controller/page_reader/n1468_s119/I1
10.942 | 0.498 | tINS | RR | 1 | R48C55[3][B] | u_score_store_sd/controller/page_reader/n1468_s119/F
10.944 | 0.003 | tNET | RR | 1 | R48C55[1][B] | u_score_store_sd/controller/page_reader/n1468_s115/I0
11.471 | 0.526 | tINS | RR | 1 | R48C55[1][B] | u_score_store_sd/controller/page_reader/n1468_s115/F
11.774 | 0.304 | tNET | RR | 1 | R46C55[3][A] | u_score_store_sd/controller/page_reader/n1468_s104/I1
12.296 | 0.521 | tINS | RR | 6 | R46C55[3][A] | u_score_store_sd/controller/page_reader/n1468_s104/F
12.952 | 0.656 | tNET | RR | 1 | R50C55[0][B] | u_score_store_sd/controller/page_reader/n1468_s95/I1
13.478 | 0.526 | tINS | RR | 1 | R50C55[0][B] | u_score_store_sd/controller/page_reader/n1468_s95/F
13.481 | 0.003 | tNET | RR | 1 | R50C55[2][A] | u_score_store_sd/controller/page_reader/n1468_s85/I2
13.997 | 0.516 | tINS | RR | 3 | R50C55[2][A] | u_score_store_sd/controller/page_reader/n1468_s85/F
14.484 | 0.487 | tNET | RR | 1 | R49C54[1][B] | u_score_store_sd/controller/page_reader/n1468_s81/I0
15.001 | 0.516 | tINS | RR | 1 | R49C54[1][B] | u_score_store_sd/controller/page_reader/n1468_s81/F
15.158 | 0.157 | tNET | RR | 1 | R50C54[1][A] | u_score_store_sd/controller/page_reader/n1468_s79/I0
15.674 | 0.516 | tINS | RR | 1 | R50C54[1][A] | u_score_store_sd/controller/page_reader/n1468_s79/F
15.677 | 0.003 | tNET | RR | 1 | R50C54[1][B] | u_score_store_sd/controller/page_reader/n1468_s74/I1
15.939 | 0.262 | tINS | RR | 2 | R50C54[1][B] | u_score_store_sd/controller/page_reader/n1468_s74/F
16.099 | 0.160 | tNET | RR | 1 | R49C54[2][B] | u_score_store_sd/controller/page_reader/n1468_s72/I2
16.626 | 0.526 | tINS | RR | 1 | R49C54[2][B] | u_score_store_sd/controller/page_reader/n1468_s72/F
16.628 | 0.003 | tNET | RR | 1 | R49C54[3][A] | u_score_store_sd/controller/page_reader/n1468_s64/I2
17.126 | 0.498 | tINS | RR | 2 | R49C54[3][A] | u_score_store_sd/controller/page_reader/n1468_s64/F
17.666 | 0.540 | tNET | RR | 1 | R52C54[1][A] | u_score_store_sd/controller/page_reader/n1468_s51/I1
17.928 | 0.262 | tINS | RR | 3 | R52C54[1][A] | u_score_store_sd/controller/page_reader/n1468_s51/F
18.416 | 0.487 | tNET | RR | 1 | R50C53[3][B] | u_score_store_sd/controller/page_reader/n1468_s42/I0
18.913 | 0.498 | tINS | RR | 1 | R50C53[3][B] | u_score_store_sd/controller/page_reader/n1468_s42/F
19.071 | 0.157 | tNET | RR | 1 | R50C52[3][B] | u_score_store_sd/controller/page_reader/n1468_s36/I0
19.592 | 0.521 | tINS | RR | 3 | R50C52[3][B] | u_score_store_sd/controller/page_reader/n1468_s36/F
19.944 | 0.352 | tNET | RR | 1 | R48C52[3][B] | u_score_store_sd/controller/page_reader/n1468_s33/I0
20.442 | 0.498 | tINS | RR | 23 | R48C52[3][B] | u_score_store_sd/controller/page_reader/n1468_s33/F
21.382 | 0.940 | tNET | RR | 1 | R51C51[3][A] | u_score_store_sd/controller/page_reader/stream_count_15_s3/I1
21.879 | 0.498 | tINS | RR | 16 | R51C51[3][A] | u_score_store_sd/controller/page_reader/stream_count_15_s3/F
22.739 | 0.860 | tNET | RR | 1 | R52C59[2][B] | u_score_store_sd/controller/page_reader/stream_count_8_s1/CE

Data Required Path:

AT | DELAY | TYPE | RF | FANOUT | LOC | NODE
20.000 | 20.000 | | | | | active clock edge time
20.000 | 0.000 | | | | | sys_clk
20.000 | 0.000 | tCL | RR | 1 | IOB117[B] | sys_clk_ibuf/I
20.683 | 0.683 | tINS | RR | 13930 | IOB117[B] | sys_clk_ibuf/O
23.853 | 3.171 | tNET | RR | 1 | R52C59[2][B] | u_score_store_sd/controller/page_reader/stream_count_8_s1/CLK
23.542 | -0.311 | tSu | | 1 | R52C59[2][B] | u_score_store_sd/controller/page_reader/stream_count_8_s1

Path Statistics:

Clock Skew | -0.495
Setup Relationship | 20.000
Logic Level | 20
Arrival Clock Path Delay | cell: 0.683, 15.696%; route: 3.666, 84.304%
Arrival Data Path Delay | cell: 8.044, 43.737%; route: 9.965, 54.183%; tC2Q: 0.382, 2.080%
Required Clock Path Delay | cell: 0.683, 17.713%; route: 3.171, 82.287%

### Path3

Path Summary:

Slack | 0.802
Data Arrival Time | 22.739
Data Required Time | 23.542
From | u_score_store_sd/controller/page_reader/indexer/bitmap_offset_0_s1
To | u_score_store_sd/controller/page_reader/stream_count_9_s1
Launch Clk | sys_clk:[R]
Latch Clk | sys_clk:[R]

Data Arrival Path:

AT | DELAY | TYPE | RF | FANOUT | LOC | NODE
0.000 | 0.000 | | | | | active clock edge time
0.000 | 0.000 | | | | | sys_clk
0.000 | 0.000 | tCL | RR | 1 | IOB117[B] | sys_clk_ibuf/I
0.683 | 0.683 | tINS | RR | 13930 | IOB117[B] | sys_clk_ibuf/O
4.348 | 3.666 | tNET | RR | 1 | R35C55[0][A] | u_score_store_sd/controller/page_reader/indexer/bitmap_offset_0_s1/CLK
4.731 | 0.382 | tC2Q | RR | 4 | R35C55[0][A] | u_score_store_sd/controller/page_reader/indexer/bitmap_offset_0_s1/Q
8.989 | 4.259 | tNET | RR | 2 | R51C54[0][A] | u_score_store_sd/controller/page_reader/n552_s64/CIN
9.039 | 0.050 | tINS | RR | 1 | R51C54[0][A] | u_score_store_sd/controller/page_reader/n552_s64/COUT
9.039 | 0.000 | tNET | RR | 2 | R51C54[0][B] | u_score_store_sd/controller/page_reader/n552_s65/CIN
9.089 | 0.050 | tINS | RR | 1 | R51C54[0][B] | u_score_store_sd/controller/page_reader/n552_s65/COUT
9.089 | 0.000 | tNET | RR | 2 | R51C54[1][A] | u_score_store_sd/controller/page_reader/n552_s66/CIN
9.139 | 0.050 | tINS | RR | 1 | R51C54[1][A] | u_score_store_sd/controller/page_reader/n552_s66/COUT
9.139 | 0.000 | tNET | RR | 2 | R51C54[1][B] | u_score_store_sd/controller/page_reader/n552_s67/CIN
9.189 | 0.050 | tINS | RR | 1 | R51C54[1][B] | u_score_store_sd/controller/page_reader/n552_s67/COUT
9.189 | 0.000 | tNET | RR | 2 | R51C54[2][A] | u_score_store_sd/controller/page_reader/n552_s68/CIN
9.239 | 0.050 | tINS | RR | 1 | R51C54[2][A] | u_score_store_sd/controller/page_reader/n552_s68/COUT
9.239 | 0.000 | tNET | RR | 2 | R51C54[2][B] | u_score_store_sd/controller/page_reader/n552_s69/CIN
9.289 | 0.050 | tINS | RR | 1 | R51C54[2][B] | u_score_store_sd/controller/page_reader/n552_s69/COUT
9.289 | 0.000 | tNET | RR | 2 | R51C55[0][A] | u_score_store_sd/controller/page_reader/n552_s70/CIN
9.339 | 0.050 | tINS | RR | 1 | R51C55[0][A] | u_score_store_sd/controller/page_reader/n552_s70/COUT
9.339 | 0.000 | tNET | RR | 2 | R51C55[0][B] | u_score_store_sd/controller/page_reader/n552_s71/CIN
9.389 | 0.050 | tINS | RR | 1 | R51C55[0][B] | u_score_store_sd/controller/page_reader/n552_s71/COUT
9.826 | 0.436 | tNET | RR | 1 | R49C55[2][A] | u_score_store_sd/controller/page_reader/n1468_s121/I1
10.287 | 0.461 | tINS | RR | 1 | R49C55[2][A] | u_score_store_sd/controller/page_reader/n1468_s121/F
10.444 | 0.157 | tNET | RR | 1 | R48C55[3][B] | u_score_store_sd/controller/page_reader/n1468_s119/I1
10.942 | 0.498 | tINS | RR | 1 | R48C55[3][B] | u_score_store_sd/controller/page_reader/n1468_s119/F
10.944 | 0.003 | tNET | RR | 1 | R48C55[1][B] | u_score_store_sd/controller/page_reader/n1468_s115/I0
11.471 | 0.526 | tINS | RR | 1 | R48C55[1][B] | u_score_store_sd/controller/page_reader/n1468_s115/F
11.774 | 0.304 | tNET | RR | 1 | R46C55[3][A] | u_score_store_sd/controller/page_reader/n1468_s104/I1
12.296 | 0.521 | tINS | RR | 6 | R46C55[3][A] | u_score_store_sd/controller/page_reader/n1468_s104/F
12.952 | 0.656 | tNET | RR | 1 | R50C55[0][B] | u_score_store_sd/controller/page_reader/n1468_s95/I1
13.478 | 0.526 | tINS | RR | 1 | R50C55[0][B] | u_score_store_sd/controller/page_reader/n1468_s95/F
13.481 | 0.003 | tNET | RR | 1 | R50C55[2][A] | u_score_store_sd/controller/page_reader/n1468_s85/I2
13.997 | 0.516 | tINS | RR | 3 | R50C55[2][A] | u_score_store_sd/controller/page_reader/n1468_s85/F
14.484 | 0.487 | tNET | RR | 1 | R49C54[1][B] | u_score_store_sd/controller/page_reader/n1468_s81/I0
15.001 | 0.516 | tINS | RR | 1 | R49C54[1][B] | u_score_store_sd/controller/page_reader/n1468_s81/F
15.158 | 0.157 | tNET | RR | 1 | R50C54[1][A] | u_score_store_sd/controller/page_reader/n1468_s79/I0
15.674 | 0.516 | tINS | RR | 1 | R50C54[1][A] | u_score_store_sd/controller/page_reader/n1468_s79/F
15.677 | 0.003 | tNET | RR | 1 | R50C54[1][B] | u_score_store_sd/controller/page_reader/n1468_s74/I1
15.939 | 0.262 | tINS | RR | 2 | R50C54[1][B] | u_score_store_sd/controller/page_reader/n1468_s74/F
16.099 | 0.160 | tNET | RR | 1 | R49C54[2][B] | u_score_store_sd/controller/page_reader/n1468_s72/I2
16.626 | 0.526 | tINS | RR | 1 | R49C54[2][B] | u_score_store_sd/controller/page_reader/n1468_s72/F
16.628 | 0.003 | tNET | RR | 1 | R49C54[3][A] | u_score_store_sd/controller/page_reader/n1468_s64/I2
17.126 | 0.498 | tINS | RR | 2 | R49C54[3][A] | u_score_store_sd/controller/page_reader/n1468_s64/F
17.666 | 0.540 | tNET | RR | 1 | R52C54[1][A] | u_score_store_sd/controller/page_reader/n1468_s51/I1
17.928 | 0.262 | tINS | RR | 3 | R52C54[1][A] | u_score_store_sd/controller/page_reader/n1468_s51/F
18.416 | 0.487 | tNET | RR | 1 | R50C53[3][B] | u_score_store_sd/controller/page_reader/n1468_s42/I0
18.913 | 0.498 | tINS | RR | 1 | R50C53[3][B] | u_score_store_sd/controller/page_reader/n1468_s42/F
19.071 | 0.157 | tNET | RR | 1 | R50C52[3][B] | u_score_store_sd/controller/page_reader/n1468_s36/I0
19.592 | 0.521 | tINS | RR | 3 | R50C52[3][B] | u_score_store_sd/controller/page_reader/n1468_s36/F
19.944 | 0.352 | tNET | RR | 1 | R48C52[3][B] | u_score_store_sd/controller/page_reader/n1468_s33/I0
20.442 | 0.498 | tINS | RR | 23 | R48C52[3][B] | u_score_store_sd/controller/page_reader/n1468_s33/F
21.382 | 0.940 | tNET | RR | 1 | R51C51[3][A] | u_score_store_sd/controller/page_reader/stream_count_15_s3/I1
21.879 | 0.498 | tINS | RR | 16 | R51C51[3][A] | u_score_store_sd/controller/page_reader/stream_count_15_s3/F
22.739 | 0.860 | tNET | RR | 1 | R52C59[0][A] | u_score_store_sd/controller/page_reader/stream_count_9_s1/CE

Data Required Path:

AT | DELAY | TYPE | RF | FANOUT | LOC | NODE
20.000 | 20.000 | | | | | active clock edge time
20.000 | 0.000 | | | | | sys_clk
20.000 | 0.000 | tCL | RR | 1 | IOB117[B] | sys_clk_ibuf/I
20.683 | 0.683 | tINS | RR | 13930 | IOB117[B] | sys_clk_ibuf/O
23.853 | 3.171 | tNET | RR | 1 | R52C59[0][A] | u_score_store_sd/controller/page_reader/stream_count_9_s1/CLK
23.542 | -0.311 | tSu | | 1 | R52C59[0][A] | u_score_store_sd/controller/page_reader/stream_count_9_s1

Path Statistics:

Clock Skew | -0.495
Setup Relationship | 20.000
Logic Level | 20
Arrival Clock Path Delay | cell: 0.683, 15.696%; route: 3.666, 84.304%
Arrival Data Path Delay | cell: 8.044, 43.737%; route: 9.965, 54.183%; tC2Q: 0.382, 2.080%
Required Clock Path Delay | cell: 0.683, 17.713%; route: 3.171, 82.287%

### Path4

Path Summary:

Slack | 0.802
Data Arrival Time | 22.739
Data Required Time | 23.542
From | u_score_store_sd/controller/page_reader/indexer/bitmap_offset_0_s1
To | u_score_store_sd/controller/page_reader/stream_count_10_s1
Launch Clk | sys_clk:[R]
Latch Clk | sys_clk:[R]

Data Arrival Path:

AT | DELAY | TYPE | RF | FANOUT | LOC | NODE
0.000 | 0.000 | | | | | active clock edge time
0.000 | 0.000 | | | | | sys_clk
0.000 | 0.000 | tCL | RR | 1 | IOB117[B] | sys_clk_ibuf/I
0.683 | 0.683 | tINS | RR | 13930 | IOB117[B] | sys_clk_ibuf/O
4.348 | 3.666 | tNET | RR | 1 | R35C55[0][A] | u_score_store_sd/controller/page_reader/indexer/bitmap_offset_0_s1/CLK
4.731 | 0.382 | tC2Q | RR | 4 | R35C55[0][A] | u_score_store_sd/controller/page_reader/indexer/bitmap_offset_0_s1/Q
8.989 | 4.259 | tNET | RR | 2 | R51C54[0][A] | u_score_store_sd/controller/page_reader/n552_s64/CIN
9.039 | 0.050 | tINS | RR | 1 | R51C54[0][A] | u_score_store_sd/controller/page_reader/n552_s64/COUT
9.039 | 0.000 | tNET | RR | 2 | R51C54[0][B] | u_score_store_sd/controller/page_reader/n552_s65/CIN
9.089 | 0.050 | tINS | RR | 1 | R51C54[0][B] | u_score_store_sd/controller/page_reader/n552_s65/COUT
9.089 | 0.000 | tNET | RR | 2 | R51C54[1][A] | u_score_store_sd/controller/page_reader/n552_s66/CIN
9.139 | 0.050 | tINS | RR | 1 | R51C54[1][A] | u_score_store_sd/controller/page_reader/n552_s66/COUT
9.139 | 0.000 | tNET | RR | 2 | R51C54[1][B] | u_score_store_sd/controller/page_reader/n552_s67/CIN
9.189 | 0.050 | tINS | RR | 1 | R51C54[1][B] | u_score_store_sd/controller/page_reader/n552_s67/COUT
9.189 | 0.000 | tNET | RR | 2 | R51C54[2][A] | u_score_store_sd/controller/page_reader/n552_s68/CIN
9.239 | 0.050 | tINS | RR | 1 | R51C54[2][A] | u_score_store_sd/controller/page_reader/n552_s68/COUT
9.239 | 0.000 | tNET | RR | 2 | R51C54[2][B] | u_score_store_sd/controller/page_reader/n552_s69/CIN
9.289 | 0.050 | tINS | RR | 1 | R51C54[2][B] | u_score_store_sd/controller/page_reader/n552_s69/COUT
9.289 | 0.000 | tNET | RR | 2 | R51C55[0][A] | u_score_store_sd/controller/page_reader/n552_s70/CIN
9.339 | 0.050 | tINS | RR | 1 | R51C55[0][A] | u_score_store_sd/controller/page_reader/n552_s70/COUT
9.339 | 0.000 | tNET | RR | 2 | R51C55[0][B] | u_score_store_sd/controller/page_reader/n552_s71/CIN
9.389 | 0.050 | tINS | RR | 1 | R51C55[0][B] | u_score_store_sd/controller/page_reader/n552_s71/COUT
9.826 | 0.436 | tNET | RR | 1 | R49C55[2][A] | u_score_store_sd/controller/page_reader/n1468_s121/I1
10.287 | 0.461 | tINS | RR | 1 | R49C55[2][A] | u_score_store_sd/controller/page_reader/n1468_s121/F
10.444 | 0.157 | tNET | RR | 1 | R48C55[3][B] | u_score_store_sd/controller/page_reader/n1468_s119/I1
10.942 | 0.498 | tINS | RR | 1 | R48C55[3][B] | u_score_store_sd/controller/page_reader/n1468_s119/F
10.944 | 0.003 | tNET | RR | 1 | R48C55[1][B] | u_score_store_sd/controller/page_reader/n1468_s115/I0
11.471 | 0.526 | tINS | RR | 1 | R48C55[1][B] | u_score_store_sd/controller/page_reader/n1468_s115/F
11.774 | 0.304 | tNET | RR | 1 | R46C55[3][A] | u_score_store_sd/controller/page_reader/n1468_s104/I1
12.296 | 0.521 | tINS | RR | 6 | R46C55[3][A] | u_score_store_sd/controller/page_reader/n1468_s104/F
12.952 | 0.656 | tNET | RR | 1 | R50C55[0][B] | u_score_store_sd/controller/page_reader/n1468_s95/I1
13.478 | 0.526 | tINS | RR | 1 | R50C55[0][B] | u_score_store_sd/controller/page_reader/n1468_s95/F
13.481 | 0.003 | tNET | RR | 1 | R50C55[2][A] | u_score_store_sd/controller/page_reader/n1468_s85/I2
13.997 | 0.516 | tINS | RR | 3 | R50C55[2][A] | u_score_store_sd/controller/page_reader/n1468_s85/F
14.484 | 0.487 | tNET | RR | 1 | R49C54[1][B] | u_score_store_sd/controller/page_reader/n1468_s81/I0
15.001 | 0.516 | tINS | RR | 1 | R49C54[1][B] | u_score_store_sd/controller/page_reader/n1468_s81/F
15.158 | 0.157 | tNET | RR | 1 | R50C54[1][A] | u_score_store_sd/controller/page_reader/n1468_s79/I0
15.674 | 0.516 | tINS | RR | 1 | R50C54[1][A] | u_score_store_sd/controller/page_reader/n1468_s79/F
15.677 | 0.003 | tNET | RR | 1 | R50C54[1][B] | u_score_store_sd/controller/page_reader/n1468_s74/I1
15.939 | 0.262 | tINS | RR | 2 | R50C54[1][B] | u_score_store_sd/controller/page_reader/n1468_s74/F
16.099 | 0.160 | tNET | RR | 1 | R49C54[2][B] | u_score_store_sd/controller/page_reader/n1468_s72/I2
16.626 | 0.526 | tINS | RR | 1 | R49C54[2][B] | u_score_store_sd/controller/page_reader/n1468_s72/F
16.628 | 0.003 | tNET | RR | 1 | R49C54[3][A] | u_score_store_sd/controller/page_reader/n1468_s64/I2
17.126 | 0.498 | tINS | RR | 2 | R49C54[3][A] | u_score_store_sd/controller/page_reader/n1468_s64/F
17.666 | 0.540 | tNET | RR | 1 | R52C54[1][A] | u_score_store_sd/controller/page_reader/n1468_s51/I1
17.928 | 0.262 | tINS | RR | 3 | R52C54[1][A] | u_score_store_sd/controller/page_reader/n1468_s51/F
18.416 | 0.487 | tNET | RR | 1 | R50C53[3][B] | u_score_store_sd/controller/page_reader/n1468_s42/I0
18.913 | 0.498 | tINS | RR | 1 | R50C53[3][B] | u_score_store_sd/controller/page_reader/n1468_s42/F
19.071 | 0.157 | tNET | RR | 1 | R50C52[3][B] | u_score_store_sd/controller/page_reader/n1468_s36/I0
19.592 | 0.521 | tINS | RR | 3 | R50C52[3][B] | u_score_store_sd/controller/page_reader/n1468_s36/F
19.944 | 0.352 | tNET | RR | 1 | R48C52[3][B] | u_score_store_sd/controller/page_reader/n1468_s33/I0
20.442 | 0.498 | tINS | RR | 23 | R48C52[3][B] | u_score_store_sd/controller/page_reader/n1468_s33/F
21.382 | 0.940 | tNET | RR | 1 | R51C51[3][A] | u_score_store_sd/controller/page_reader/stream_count_15_s3/I1
21.879 | 0.498 | tINS | RR | 16 | R51C51[3][A] | u_score_store_sd/controller/page_reader/stream_count_15_s3/F
22.739 | 0.860 | tNET | RR | 1 | R52C59[2][A] | u_score_store_sd/controller/page_reader/stream_count_10_s1/CE

Data Required Path:

AT | DELAY | TYPE | RF | FANOUT | LOC | NODE
20.000 | 20.000 | | | | | active clock edge time
20.000 | 0.000 | | | | | sys_clk
20.000 | 0.000 | tCL | RR | 1 | IOB117[B] | sys_clk_ibuf/I
20.683 | 0.683 | tINS | RR | 13930 | IOB117[B] | sys_clk_ibuf/O
23.853 | 3.171 | tNET | RR | 1 | R52C59[2][A] | u_score_store_sd/controller/page_reader/stream_count_10_s1/CLK
23.542 | -0.311 | tSu | | 1 | R52C59[2][A] | u_score_store_sd/controller/page_reader/stream_count_10_s1

Path Statistics:

Clock Skew | -0.495
Setup Relationship | 20.000
Logic Level | 20
Arrival Clock Path Delay | cell: 0.683, 15.696%; route: 3.666, 84.304%
Arrival Data Path Delay | cell: 8.044, 43.737%; route: 9.965, 54.183%; tC2Q: 0.382, 2.080%
Required Clock Path Delay | cell: 0.683, 17.713%; route: 3.171, 82.287%

### Path5

Path Summary:

Slack | 0.802
Data Arrival Time | 22.739
Data Required Time | 23.542
From | u_score_store_sd/controller/page_reader/indexer/bitmap_offset_0_s1
To | u_score_store_sd/controller/page_reader/stream_count_13_s1
Launch Clk | sys_clk:[R]
Latch Clk | sys_clk:[R]

Data Arrival Path:

AT | DELAY | TYPE | RF | FANOUT | LOC | NODE
0.000 | 0.000 | | | | | active clock edge time
0.000 | 0.000 | | | | | sys_clk
0.000 | 0.000 | tCL | RR | 1 | IOB117[B] | sys_clk_ibuf/I
0.683 | 0.683 | tINS | RR | 13930 | IOB117[B] | sys_clk_ibuf/O
4.348 | 3.666 | tNET | RR | 1 | R35C55[0][A] | u_score_store_sd/controller/page_reader/indexer/bitmap_offset_0_s1/CLK
4.731 | 0.382 | tC2Q | RR | 4 | R35C55[0][A] | u_score_store_sd/controller/page_reader/indexer/bitmap_offset_0_s1/Q
8.989 | 4.259 | tNET | RR | 2 | R51C54[0][A] | u_score_store_sd/controller/page_reader/n552_s64/CIN
9.039 | 0.050 | tINS | RR | 1 | R51C54[0][A] | u_score_store_sd/controller/page_reader/n552_s64/COUT
9.039 | 0.000 | tNET | RR | 2 | R51C54[0][B] | u_score_store_sd/controller/page_reader/n552_s65/CIN
9.089 | 0.050 | tINS | RR | 1 | R51C54[0][B] | u_score_store_sd/controller/page_reader/n552_s65/COUT
9.089 | 0.000 | tNET | RR | 2 | R51C54[1][A] | u_score_store_sd/controller/page_reader/n552_s66/CIN
9.139 | 0.050 | tINS | RR | 1 | R51C54[1][A] | u_score_store_sd/controller/page_reader/n552_s66/COUT
9.139 | 0.000 | tNET | RR | 2 | R51C54[1][B] | u_score_store_sd/controller/page_reader/n552_s67/CIN
9.189 | 0.050 | tINS | RR | 1 | R51C54[1][B] | u_score_store_sd/controller/page_reader/n552_s67/COUT
9.189 | 0.000 | tNET | RR | 2 | R51C54[2][A] | u_score_store_sd/controller/page_reader/n552_s68/CIN
9.239 | 0.050 | tINS | RR | 1 | R51C54[2][A] | u_score_store_sd/controller/page_reader/n552_s68/COUT
9.239 | 0.000 | tNET | RR | 2 | R51C54[2][B] | u_score_store_sd/controller/page_reader/n552_s69/CIN
9.289 | 0.050 | tINS | RR | 1 | R51C54[2][B] | u_score_store_sd/controller/page_reader/n552_s69/COUT
9.289 | 0.000 | tNET | RR | 2 | R51C55[0][A] | u_score_store_sd/controller/page_reader/n552_s70/CIN
9.339 | 0.050 | tINS | RR | 1 | R51C55[0][A] | u_score_store_sd/controller/page_reader/n552_s70/COUT
9.339 | 0.000 | tNET | RR | 2 | R51C55[0][B] | u_score_store_sd/controller/page_reader/n552_s71/CIN
9.389 | 0.050 | tINS | RR | 1 | R51C55[0][B] | u_score_store_sd/controller/page_reader/n552_s71/COUT
9.826 | 0.436 | tNET | RR | 1 | R49C55[2][A] | u_score_store_sd/controller/page_reader/n1468_s121/I1
10.287 | 0.461 | tINS | RR | 1 | R49C55[2][A] | u_score_store_sd/controller/page_reader/n1468_s121/F
10.444 | 0.157 | tNET | RR | 1 | R48C55[3][B] | u_score_store_sd/controller/page_reader/n1468_s119/I1
10.942 | 0.498 | tINS | RR | 1 | R48C55[3][B] | u_score_store_sd/controller/page_reader/n1468_s119/F
10.944 | 0.003 | tNET | RR | 1 | R48C55[1][B] | u_score_store_sd/controller/page_reader/n1468_s115/I0
11.471 | 0.526 | tINS | RR | 1 | R48C55[1][B] | u_score_store_sd/controller/page_reader/n1468_s115/F
11.774 | 0.304 | tNET | RR | 1 | R46C55[3][A] | u_score_store_sd/controller/page_reader/n1468_s104/I1
12.296 | 0.521 | tINS | RR | 6 | R46C55[3][A] | u_score_store_sd/controller/page_reader/n1468_s104/F
12.952 | 0.656 | tNET | RR | 1 | R50C55[0][B] | u_score_store_sd/controller/page_reader/n1468_s95/I1
13.478 | 0.526 | tINS | RR | 1 | R50C55[0][B] | u_score_store_sd/controller/page_reader/n1468_s95/F
13.481 | 0.003 | tNET | RR | 1 | R50C55[2][A] | u_score_store_sd/controller/page_reader/n1468_s85/I2
13.997 | 0.516 | tINS | RR | 3 | R50C55[2][A] | u_score_store_sd/controller/page_reader/n1468_s85/F
14.484 | 0.487 | tNET | RR | 1 | R49C54[1][B] | u_score_store_sd/controller/page_reader/n1468_s81/I0
15.001 | 0.516 | tINS | RR | 1 | R49C54[1][B] | u_score_store_sd/controller/page_reader/n1468_s81/F
15.158 | 0.157 | tNET | RR | 1 | R50C54[1][A] | u_score_store_sd/controller/page_reader/n1468_s79/I0
15.674 | 0.516 | tINS | RR | 1 | R50C54[1][A] | u_score_store_sd/controller/page_reader/n1468_s79/F
15.677 | 0.003 | tNET | RR | 1 | R50C54[1][B] | u_score_store_sd/controller/page_reader/n1468_s74/I1
15.939 | 0.262 | tINS | RR | 2 | R50C54[1][B] | u_score_store_sd/controller/page_reader/n1468_s74/F
16.099 | 0.160 | tNET | RR | 1 | R49C54[2][B] | u_score_store_sd/controller/page_reader/n1468_s72/I2
16.626 | 0.526 | tINS | RR | 1 | R49C54[2][B] | u_score_store_sd/controller/page_reader/n1468_s72/F
16.628 | 0.003 | tNET | RR | 1 | R49C54[3][A] | u_score_store_sd/controller/page_reader/n1468_s64/I2
17.126 | 0.498 | tINS | RR | 2 | R49C54[3][A] | u_score_store_sd/controller/page_reader/n1468_s64/F
17.666 | 0.540 | tNET | RR | 1 | R52C54[1][A] | u_score_store_sd/controller/page_reader/n1468_s51/I1
17.928 | 0.262 | tINS | RR | 3 | R52C54[1][A] | u_score_store_sd/controller/page_reader/n1468_s51/F
18.416 | 0.487 | tNET | RR | 1 | R50C53[3][B] | u_score_store_sd/controller/page_reader/n1468_s42/I0
18.913 | 0.498 | tINS | RR | 1 | R50C53[3][B] | u_score_store_sd/controller/page_reader/n1468_s42/F
19.071 | 0.157 | tNET | RR | 1 | R50C52[3][B] | u_score_store_sd/controller/page_reader/n1468_s36/I0
19.592 | 0.521 | tINS | RR | 3 | R50C52[3][B] | u_score_store_sd/controller/page_reader/n1468_s36/F
19.944 | 0.352 | tNET | RR | 1 | R48C52[3][B] | u_score_store_sd/controller/page_reader/n1468_s33/I0
20.442 | 0.498 | tINS | RR | 23 | R48C52[3][B] | u_score_store_sd/controller/page_reader/n1468_s33/F
21.382 | 0.940 | tNET | RR | 1 | R51C51[3][A] | u_score_store_sd/controller/page_reader/stream_count_15_s3/I1
21.879 | 0.498 | tINS | RR | 16 | R51C51[3][A] | u_score_store_sd/controller/page_reader/stream_count_15_s3/F
22.739 | 0.860 | tNET | RR | 1 | R52C59[1][A] | u_score_store_sd/controller/page_reader/stream_count_13_s1/CE

Data Required Path:

AT | DELAY | TYPE | RF | FANOUT | LOC | NODE
20.000 | 20.000 | | | | | active clock edge time
20.000 | 0.000 | | | | | sys_clk
20.000 | 0.000 | tCL | RR | 1 | IOB117[B] | sys_clk_ibuf/I
20.683 | 0.683 | tINS | RR | 13930 | IOB117[B] | sys_clk_ibuf/O
23.853 | 3.171 | tNET | RR | 1 | R52C59[1][A] | u_score_store_sd/controller/page_reader/stream_count_13_s1/CLK
23.542 | -0.311 | tSu | | 1 | R52C59[1][A] | u_score_store_sd/controller/page_reader/stream_count_13_s1

Path Statistics:

Clock Skew | -0.495
Setup Relationship | 20.000
Logic Level | 20
Arrival Clock Path Delay | cell: 0.683, 15.696%; route: 3.666, 84.304%
Arrival Data Path Delay | cell: 8.044, 43.737%; route: 9.965, 54.183%; tC2Q: 0.382, 2.080%
Required Clock Path Delay | cell: 0.683, 17.713%; route: 3.171, 82.287%

### Path6

Path Summary:

Slack | 0.802
Data Arrival Time | 22.739
Data Required Time | 23.542
From | u_score_store_sd/controller/page_reader/indexer/bitmap_offset_0_s1
To | u_score_store_sd/controller/page_reader/stream_count_14_s1
Launch Clk | sys_clk:[R]
Latch Clk | sys_clk:[R]

Data Arrival Path:

AT | DELAY | TYPE | RF | FANOUT | LOC | NODE
0.000 | 0.000 | | | | | active clock edge time
0.000 | 0.000 | | | | | sys_clk
0.000 | 0.000 | tCL | RR | 1 | IOB117[B] | sys_clk_ibuf/I
0.683 | 0.683 | tINS | RR | 13930 | IOB117[B] | sys_clk_ibuf/O
4.348 | 3.666 | tNET | RR | 1 | R35C55[0][A] | u_score_store_sd/controller/page_reader/indexer/bitmap_offset_0_s1/CLK
4.731 | 0.382 | tC2Q | RR | 4 | R35C55[0][A] | u_score_store_sd/controller/page_reader/indexer/bitmap_offset_0_s1/Q
8.989 | 4.259 | tNET | RR | 2 | R51C54[0][A] | u_score_store_sd/controller/page_reader/n552_s64/CIN
9.039 | 0.050 | tINS | RR | 1 | R51C54[0][A] | u_score_store_sd/controller/page_reader/n552_s64/COUT
9.039 | 0.000 | tNET | RR | 2 | R51C54[0][B] | u_score_store_sd/controller/page_reader/n552_s65/CIN
9.089 | 0.050 | tINS | RR | 1 | R51C54[0][B] | u_score_store_sd/controller/page_reader/n552_s65/COUT
9.089 | 0.000 | tNET | RR | 2 | R51C54[1][A] | u_score_store_sd/controller/page_reader/n552_s66/CIN
9.139 | 0.050 | tINS | RR | 1 | R51C54[1][A] | u_score_store_sd/controller/page_reader/n552_s66/COUT
9.139 | 0.000 | tNET | RR | 2 | R51C54[1][B] | u_score_store_sd/controller/page_reader/n552_s67/CIN
9.189 | 0.050 | tINS | RR | 1 | R51C54[1][B] | u_score_store_sd/controller/page_reader/n552_s67/COUT
9.189 | 0.000 | tNET | RR | 2 | R51C54[2][A] | u_score_store_sd/controller/page_reader/n552_s68/CIN
9.239 | 0.050 | tINS | RR | 1 | R51C54[2][A] | u_score_store_sd/controller/page_reader/n552_s68/COUT
9.239 | 0.000 | tNET | RR | 2 | R51C54[2][B] | u_score_store_sd/controller/page_reader/n552_s69/CIN
9.289 | 0.050 | tINS | RR | 1 | R51C54[2][B] | u_score_store_sd/controller/page_reader/n552_s69/COUT
9.289 | 0.000 | tNET | RR | 2 | R51C55[0][A] | u_score_store_sd/controller/page_reader/n552_s70/CIN
9.339 | 0.050 | tINS | RR | 1 | R51C55[0][A] | u_score_store_sd/controller/page_reader/n552_s70/COUT
9.339 | 0.000 | tNET | RR | 2 | R51C55[0][B] | u_score_store_sd/controller/page_reader/n552_s71/CIN
9.389 | 0.050 | tINS | RR | 1 | R51C55[0][B] | u_score_store_sd/controller/page_reader/n552_s71/COUT
9.826 | 0.436 | tNET | RR | 1 | R49C55[2][A] | u_score_store_sd/controller/page_reader/n1468_s121/I1
10.287 | 0.461 | tINS | RR | 1 | R49C55[2][A] | u_score_store_sd/controller/page_reader/n1468_s121/F
10.444 | 0.157 | tNET | RR | 1 | R48C55[3][B] | u_score_store_sd/controller/page_reader/n1468_s119/I1
10.942 | 0.498 | tINS | RR | 1 | R48C55[3][B] | u_score_store_sd/controller/page_reader/n1468_s119/F
10.944 | 0.003 | tNET | RR | 1 | R48C55[1][B] | u_score_store_sd/controller/page_reader/n1468_s115/I0
11.471 | 0.526 | tINS | RR | 1 | R48C55[1][B] | u_score_store_sd/controller/page_reader/n1468_s115/F
11.774 | 0.304 | tNET | RR | 1 | R46C55[3][A] | u_score_store_sd/controller/page_reader/n1468_s104/I1
12.296 | 0.521 | tINS | RR | 6 | R46C55[3][A] | u_score_store_sd/controller/page_reader/n1468_s104/F
12.952 | 0.656 | tNET | RR | 1 | R50C55[0][B] | u_score_store_sd/controller/page_reader/n1468_s95/I1
13.478 | 0.526 | tINS | RR | 1 | R50C55[0][B] | u_score_store_sd/controller/page_reader/n1468_s95/F
13.481 | 0.003 | tNET | RR | 1 | R50C55[2][A] | u_score_store_sd/controller/page_reader/n1468_s85/I2
13.997 | 0.516 | tINS | RR | 3 | R50C55[2][A] | u_score_store_sd/controller/page_reader/n1468_s85/F
14.484 | 0.487 | tNET | RR | 1 | R49C54[1][B] | u_score_store_sd/controller/page_reader/n1468_s81/I0
15.001 | 0.516 | tINS | RR | 1 | R49C54[1][B] | u_score_store_sd/controller/page_reader/n1468_s81/F
15.158 | 0.157 | tNET | RR | 1 | R50C54[1][A] | u_score_store_sd/controller/page_reader/n1468_s79/I0
15.674 | 0.516 | tINS | RR | 1 | R50C54[1][A] | u_score_store_sd/controller/page_reader/n1468_s79/F
15.677 | 0.003 | tNET | RR | 1 | R50C54[1][B] | u_score_store_sd/controller/page_reader/n1468_s74/I1
15.939 | 0.262 | tINS | RR | 2 | R50C54[1][B] | u_score_store_sd/controller/page_reader/n1468_s74/F
16.099 | 0.160 | tNET | RR | 1 | R49C54[2][B] | u_score_store_sd/controller/page_reader/n1468_s72/I2
16.626 | 0.526 | tINS | RR | 1 | R49C54[2][B] | u_score_store_sd/controller/page_reader/n1468_s72/F
16.628 | 0.003 | tNET | RR | 1 | R49C54[3][A] | u_score_store_sd/controller/page_reader/n1468_s64/I2
17.126 | 0.498 | tINS | RR | 2 | R49C54[3][A] | u_score_store_sd/controller/page_reader/n1468_s64/F
17.666 | 0.540 | tNET | RR | 1 | R52C54[1][A] | u_score_store_sd/controller/page_reader/n1468_s51/I1
17.928 | 0.262 | tINS | RR | 3 | R52C54[1][A] | u_score_store_sd/controller/page_reader/n1468_s51/F
18.416 | 0.487 | tNET | RR | 1 | R50C53[3][B] | u_score_store_sd/controller/page_reader/n1468_s42/I0
18.913 | 0.498 | tINS | RR | 1 | R50C53[3][B] | u_score_store_sd/controller/page_reader/n1468_s42/F
19.071 | 0.157 | tNET | RR | 1 | R50C52[3][B] | u_score_store_sd/controller/page_reader/n1468_s36/I0
19.592 | 0.521 | tINS | RR | 3 | R50C52[3][B] | u_score_store_sd/controller/page_reader/n1468_s36/F
19.944 | 0.352 | tNET | RR | 1 | R48C52[3][B] | u_score_store_sd/controller/page_reader/n1468_s33/I0
20.442 | 0.498 | tINS | RR | 23 | R48C52[3][B] | u_score_store_sd/controller/page_reader/n1468_s33/F
21.382 | 0.940 | tNET | RR | 1 | R51C51[3][A] | u_score_store_sd/controller/page_reader/stream_count_15_s3/I1
21.879 | 0.498 | tINS | RR | 16 | R51C51[3][A] | u_score_store_sd/controller/page_reader/stream_count_15_s3/F
22.739 | 0.860 | tNET | RR | 1 | R52C59[3][A] | u_score_store_sd/controller/page_reader/stream_count_14_s1/CE

Data Required Path:

AT | DELAY | TYPE | RF | FANOUT | LOC | NODE
20.000 | 20.000 | | | | | active clock edge time
20.000 | 0.000 | | | | | sys_clk
20.000 | 0.000 | tCL | RR | 1 | IOB117[B] | sys_clk_ibuf/I
20.683 | 0.683 | tINS | RR | 13930 | IOB117[B] | sys_clk_ibuf/O
23.853 | 3.171 | tNET | RR | 1 | R52C59[3][A] | u_score_store_sd/controller/page_reader/stream_count_14_s1/CLK
23.542 | -0.311 | tSu | | 1 | R52C59[3][A] | u_score_store_sd/controller/page_reader/stream_count_14_s1

Path Statistics:

Clock Skew | -0.495
Setup Relationship | 20.000
Logic Level | 20
Arrival Clock Path Delay | cell: 0.683, 15.696%; route: 3.666, 84.304%
Arrival Data Path Delay | cell: 8.044, 43.737%; route: 9.965, 54.183%; tC2Q: 0.382, 2.080%
Required Clock Path Delay | cell: 0.683, 17.713%; route: 3.171, 82.287%

### Path7

Path Summary:

Slack | 0.812
Data Arrival Time | 22.739
Data Required Time | 23.551
From | u_score_store_sd/controller/page_reader/indexer/bitmap_offset_0_s1
To | u_score_store_sd/controller/page_reader/stream_count_4_s1
Launch Clk | sys_clk:[R]
Latch Clk | sys_clk:[R]

Data Arrival Path:

AT | DELAY | TYPE | RF | FANOUT | LOC | NODE
0.000 | 0.000 | | | | | active clock edge time
0.000 | 0.000 | | | | | sys_clk
0.000 | 0.000 | tCL | RR | 1 | IOB117[B] | sys_clk_ibuf/I
0.683 | 0.683 | tINS | RR | 13930 | IOB117[B] | sys_clk_ibuf/O
4.348 | 3.666 | tNET | RR | 1 | R35C55[0][A] | u_score_store_sd/controller/page_reader/indexer/bitmap_offset_0_s1/CLK
4.731 | 0.382 | tC2Q | RR | 4 | R35C55[0][A] | u_score_store_sd/controller/page_reader/indexer/bitmap_offset_0_s1/Q
8.989 | 4.259 | tNET | RR | 2 | R51C54[0][A] | u_score_store_sd/controller/page_reader/n552_s64/CIN
9.039 | 0.050 | tINS | RR | 1 | R51C54[0][A] | u_score_store_sd/controller/page_reader/n552_s64/COUT
9.039 | 0.000 | tNET | RR | 2 | R51C54[0][B] | u_score_store_sd/controller/page_reader/n552_s65/CIN
9.089 | 0.050 | tINS | RR | 1 | R51C54[0][B] | u_score_store_sd/controller/page_reader/n552_s65/COUT
9.089 | 0.000 | tNET | RR | 2 | R51C54[1][A] | u_score_store_sd/controller/page_reader/n552_s66/CIN
9.139 | 0.050 | tINS | RR | 1 | R51C54[1][A] | u_score_store_sd/controller/page_reader/n552_s66/COUT
9.139 | 0.000 | tNET | RR | 2 | R51C54[1][B] | u_score_store_sd/controller/page_reader/n552_s67/CIN
9.189 | 0.050 | tINS | RR | 1 | R51C54[1][B] | u_score_store_sd/controller/page_reader/n552_s67/COUT
9.189 | 0.000 | tNET | RR | 2 | R51C54[2][A] | u_score_store_sd/controller/page_reader/n552_s68/CIN
9.239 | 0.050 | tINS | RR | 1 | R51C54[2][A] | u_score_store_sd/controller/page_reader/n552_s68/COUT
9.239 | 0.000 | tNET | RR | 2 | R51C54[2][B] | u_score_store_sd/controller/page_reader/n552_s69/CIN
9.289 | 0.050 | tINS | RR | 1 | R51C54[2][B] | u_score_store_sd/controller/page_reader/n552_s69/COUT
9.289 | 0.000 | tNET | RR | 2 | R51C55[0][A] | u_score_store_sd/controller/page_reader/n552_s70/CIN
9.339 | 0.050 | tINS | RR | 1 | R51C55[0][A] | u_score_store_sd/controller/page_reader/n552_s70/COUT
9.339 | 0.000 | tNET | RR | 2 | R51C55[0][B] | u_score_store_sd/controller/page_reader/n552_s71/CIN
9.389 | 0.050 | tINS | RR | 1 | R51C55[0][B] | u_score_store_sd/controller/page_reader/n552_s71/COUT
9.826 | 0.436 | tNET | RR | 1 | R49C55[2][A] | u_score_store_sd/controller/page_reader/n1468_s121/I1
10.287 | 0.461 | tINS | RR | 1 | R49C55[2][A] | u_score_store_sd/controller/page_reader/n1468_s121/F
10.444 | 0.157 | tNET | RR | 1 | R48C55[3][B] | u_score_store_sd/controller/page_reader/n1468_s119/I1
10.942 | 0.498 | tINS | RR | 1 | R48C55[3][B] | u_score_store_sd/controller/page_reader/n1468_s119/F
10.944 | 0.003 | tNET | RR | 1 | R48C55[1][B] | u_score_store_sd/controller/page_reader/n1468_s115/I0
11.471 | 0.526 | tINS | RR | 1 | R48C55[1][B] | u_score_store_sd/controller/page_reader/n1468_s115/F
11.774 | 0.304 | tNET | RR | 1 | R46C55[3][A] | u_score_store_sd/controller/page_reader/n1468_s104/I1
12.296 | 0.521 | tINS | RR | 6 | R46C55[3][A] | u_score_store_sd/controller/page_reader/n1468_s104/F
12.952 | 0.656 | tNET | RR | 1 | R50C55[0][B] | u_score_store_sd/controller/page_reader/n1468_s95/I1
13.478 | 0.526 | tINS | RR | 1 | R50C55[0][B] | u_score_store_sd/controller/page_reader/n1468_s95/F
13.481 | 0.003 | tNET | RR | 1 | R50C55[2][A] | u_score_store_sd/controller/page_reader/n1468_s85/I2
13.997 | 0.516 | tINS | RR | 3 | R50C55[2][A] | u_score_store_sd/controller/page_reader/n1468_s85/F
14.484 | 0.487 | tNET | RR | 1 | R49C54[1][B] | u_score_store_sd/controller/page_reader/n1468_s81/I0
15.001 | 0.516 | tINS | RR | 1 | R49C54[1][B] | u_score_store_sd/controller/page_reader/n1468_s81/F
15.158 | 0.157 | tNET | RR | 1 | R50C54[1][A] | u_score_store_sd/controller/page_reader/n1468_s79/I0
15.674 | 0.516 | tINS | RR | 1 | R50C54[1][A] | u_score_store_sd/controller/page_reader/n1468_s79/F
15.677 | 0.003 | tNET | RR | 1 | R50C54[1][B] | u_score_store_sd/controller/page_reader/n1468_s74/I1
15.939 | 0.262 | tINS | RR | 2 | R50C54[1][B] | u_score_store_sd/controller/page_reader/n1468_s74/F
16.099 | 0.160 | tNET | RR | 1 | R49C54[2][B] | u_score_store_sd/controller/page_reader/n1468_s72/I2
16.626 | 0.526 | tINS | RR | 1 | R49C54[2][B] | u_score_store_sd/controller/page_reader/n1468_s72/F
16.628 | 0.003 | tNET | RR | 1 | R49C54[3][A] | u_score_store_sd/controller/page_reader/n1468_s64/I2
17.126 | 0.498 | tINS | RR | 2 | R49C54[3][A] | u_score_store_sd/controller/page_reader/n1468_s64/F
17.666 | 0.540 | tNET | RR | 1 | R52C54[1][A] | u_score_store_sd/controller/page_reader/n1468_s51/I1
17.928 | 0.262 | tINS | RR | 3 | R52C54[1][A] | u_score_store_sd/controller/page_reader/n1468_s51/F
18.416 | 0.487 | tNET | RR | 1 | R50C53[3][B] | u_score_store_sd/controller/page_reader/n1468_s42/I0
18.913 | 0.498 | tINS | RR | 1 | R50C53[3][B] | u_score_store_sd/controller/page_reader/n1468_s42/F
19.071 | 0.157 | tNET | RR | 1 | R50C52[3][B] | u_score_store_sd/controller/page_reader/n1468_s36/I0
19.592 | 0.521 | tINS | RR | 3 | R50C52[3][B] | u_score_store_sd/controller/page_reader/n1468_s36/F
19.944 | 0.352 | tNET | RR | 1 | R48C52[3][B] | u_score_store_sd/controller/page_reader/n1468_s33/I0
20.442 | 0.498 | tINS | RR | 23 | R48C52[3][B] | u_score_store_sd/controller/page_reader/n1468_s33/F
21.382 | 0.940 | tNET | RR | 1 | R51C51[3][A] | u_score_store_sd/controller/page_reader/stream_count_15_s3/I1
21.879 | 0.498 | tINS | RR | 16 | R51C51[3][A] | u_score_store_sd/controller/page_reader/stream_count_15_s3/F
22.739 | 0.860 | tNET | RR | 1 | R52C60[2][B] | u_score_store_sd/controller/page_reader/stream_count_4_s1/CE

Data Required Path:

AT | DELAY | TYPE | RF | FANOUT | LOC | NODE
20.000 | 20.000 | | | | | active clock edge time
20.000 | 0.000 | | | | | sys_clk
20.000 | 0.000 | tCL | RR | 1 | IOB117[B] | sys_clk_ibuf/I
20.683 | 0.683 | tINS | RR | 13930 | IOB117[B] | sys_clk_ibuf/O
23.862 | 3.180 | tNET | RR | 1 | R52C60[2][B] | u_score_store_sd/controller/page_reader/stream_count_4_s1/CLK
23.551 | -0.311 | tSu | | 1 | R52C60[2][B] | u_score_store_sd/controller/page_reader/stream_count_4_s1

Path Statistics:

Clock Skew | -0.486
Setup Relationship | 20.000
Logic Level | 20
Arrival Clock Path Delay | cell: 0.683, 15.696%; route: 3.666, 84.304%
Arrival Data Path Delay | cell: 8.044, 43.737%; route: 9.965, 54.183%; tC2Q: 0.382, 2.080%
Required Clock Path Delay | cell: 0.683, 17.670%; route: 3.180, 82.330%

### Path8

Path Summary:

Slack | 0.812
Data Arrival Time | 22.739
Data Required Time | 23.551
From | u_score_store_sd/controller/page_reader/indexer/bitmap_offset_0_s1
To | u_score_store_sd/controller/page_reader/stream_count_5_s1
Launch Clk | sys_clk:[R]
Latch Clk | sys_clk:[R]

Data Arrival Path:

AT | DELAY | TYPE | RF | FANOUT | LOC | NODE
0.000 | 0.000 | | | | | active clock edge time
0.000 | 0.000 | | | | | sys_clk
0.000 | 0.000 | tCL | RR | 1 | IOB117[B] | sys_clk_ibuf/I
0.683 | 0.683 | tINS | RR | 13930 | IOB117[B] | sys_clk_ibuf/O
4.348 | 3.666 | tNET | RR | 1 | R35C55[0][A] | u_score_store_sd/controller/page_reader/indexer/bitmap_offset_0_s1/CLK
4.731 | 0.382 | tC2Q | RR | 4 | R35C55[0][A] | u_score_store_sd/controller/page_reader/indexer/bitmap_offset_0_s1/Q
8.989 | 4.259 | tNET | RR | 2 | R51C54[0][A] | u_score_store_sd/controller/page_reader/n552_s64/CIN
9.039 | 0.050 | tINS | RR | 1 | R51C54[0][A] | u_score_store_sd/controller/page_reader/n552_s64/COUT
9.039 | 0.000 | tNET | RR | 2 | R51C54[0][B] | u_score_store_sd/controller/page_reader/n552_s65/CIN
9.089 | 0.050 | tINS | RR | 1 | R51C54[0][B] | u_score_store_sd/controller/page_reader/n552_s65/COUT
9.089 | 0.000 | tNET | RR | 2 | R51C54[1][A] | u_score_store_sd/controller/page_reader/n552_s66/CIN
9.139 | 0.050 | tINS | RR | 1 | R51C54[1][A] | u_score_store_sd/controller/page_reader/n552_s66/COUT
9.139 | 0.000 | tNET | RR | 2 | R51C54[1][B] | u_score_store_sd/controller/page_reader/n552_s67/CIN
9.189 | 0.050 | tINS | RR | 1 | R51C54[1][B] | u_score_store_sd/controller/page_reader/n552_s67/COUT
9.189 | 0.000 | tNET | RR | 2 | R51C54[2][A] | u_score_store_sd/controller/page_reader/n552_s68/CIN
9.239 | 0.050 | tINS | RR | 1 | R51C54[2][A] | u_score_store_sd/controller/page_reader/n552_s68/COUT
9.239 | 0.000 | tNET | RR | 2 | R51C54[2][B] | u_score_store_sd/controller/page_reader/n552_s69/CIN
9.289 | 0.050 | tINS | RR | 1 | R51C54[2][B] | u_score_store_sd/controller/page_reader/n552_s69/COUT
9.289 | 0.000 | tNET | RR | 2 | R51C55[0][A] | u_score_store_sd/controller/page_reader/n552_s70/CIN
9.339 | 0.050 | tINS | RR | 1 | R51C55[0][A] | u_score_store_sd/controller/page_reader/n552_s70/COUT
9.339 | 0.000 | tNET | RR | 2 | R51C55[0][B] | u_score_store_sd/controller/page_reader/n552_s71/CIN
9.389 | 0.050 | tINS | RR | 1 | R51C55[0][B] | u_score_store_sd/controller/page_reader/n552_s71/COUT
9.826 | 0.436 | tNET | RR | 1 | R49C55[2][A] | u_score_store_sd/controller/page_reader/n1468_s121/I1
10.287 | 0.461 | tINS | RR | 1 | R49C55[2][A] | u_score_store_sd/controller/page_reader/n1468_s121/F
10.444 | 0.157 | tNET | RR | 1 | R48C55[3][B] | u_score_store_sd/controller/page_reader/n1468_s119/I1
10.942 | 0.498 | tINS | RR | 1 | R48C55[3][B] | u_score_store_sd/controller/page_reader/n1468_s119/F
10.944 | 0.003 | tNET | RR | 1 | R48C55[1][B] | u_score_store_sd/controller/page_reader/n1468_s115/I0
11.471 | 0.526 | tINS | RR | 1 | R48C55[1][B] | u_score_store_sd/controller/page_reader/n1468_s115/F
11.774 | 0.304 | tNET | RR | 1 | R46C55[3][A] | u_score_store_sd/controller/page_reader/n1468_s104/I1
12.296 | 0.521 | tINS | RR | 6 | R46C55[3][A] | u_score_store_sd/controller/page_reader/n1468_s104/F
12.952 | 0.656 | tNET | RR | 1 | R50C55[0][B] | u_score_store_sd/controller/page_reader/n1468_s95/I1
13.478 | 0.526 | tINS | RR | 1 | R50C55[0][B] | u_score_store_sd/controller/page_reader/n1468_s95/F
13.481 | 0.003 | tNET | RR | 1 | R50C55[2][A] | u_score_store_sd/controller/page_reader/n1468_s85/I2
13.997 | 0.516 | tINS | RR | 3 | R50C55[2][A] | u_score_store_sd/controller/page_reader/n1468_s85/F
14.484 | 0.487 | tNET | RR | 1 | R49C54[1][B] | u_score_store_sd/controller/page_reader/n1468_s81/I0
15.001 | 0.516 | tINS | RR | 1 | R49C54[1][B] | u_score_store_sd/controller/page_reader/n1468_s81/F
15.158 | 0.157 | tNET | RR | 1 | R50C54[1][A] | u_score_store_sd/controller/page_reader/n1468_s79/I0
15.674 | 0.516 | tINS | RR | 1 | R50C54[1][A] | u_score_store_sd/controller/page_reader/n1468_s79/F
15.677 | 0.003 | tNET | RR | 1 | R50C54[1][B] | u_score_store_sd/controller/page_reader/n1468_s74/I1
15.939 | 0.262 | tINS | RR | 2 | R50C54[1][B] | u_score_store_sd/controller/page_reader/n1468_s74/F
16.099 | 0.160 | tNET | RR | 1 | R49C54[2][B] | u_score_store_sd/controller/page_reader/n1468_s72/I2
16.626 | 0.526 | tINS | RR | 1 | R49C54[2][B] | u_score_store_sd/controller/page_reader/n1468_s72/F
16.628 | 0.003 | tNET | RR | 1 | R49C54[3][A] | u_score_store_sd/controller/page_reader/n1468_s64/I2
17.126 | 0.498 | tINS | RR | 2 | R49C54[3][A] | u_score_store_sd/controller/page_reader/n1468_s64/F
17.666 | 0.540 | tNET | RR | 1 | R52C54[1][A] | u_score_store_sd/controller/page_reader/n1468_s51/I1
17.928 | 0.262 | tINS | RR | 3 | R52C54[1][A] | u_score_store_sd/controller/page_reader/n1468_s51/F
18.416 | 0.487 | tNET | RR | 1 | R50C53[3][B] | u_score_store_sd/controller/page_reader/n1468_s42/I0
18.913 | 0.498 | tINS | RR | 1 | R50C53[3][B] | u_score_store_sd/controller/page_reader/n1468_s42/F
19.071 | 0.157 | tNET | RR | 1 | R50C52[3][B] | u_score_store_sd/controller/page_reader/n1468_s36/I0
19.592 | 0.521 | tINS | RR | 3 | R50C52[3][B] | u_score_store_sd/controller/page_reader/n1468_s36/F
19.944 | 0.352 | tNET | RR | 1 | R48C52[3][B] | u_score_store_sd/controller/page_reader/n1468_s33/I0
20.442 | 0.498 | tINS | RR | 23 | R48C52[3][B] | u_score_store_sd/controller/page_reader/n1468_s33/F
21.382 | 0.940 | tNET | RR | 1 | R51C51[3][A] | u_score_store_sd/controller/page_reader/stream_count_15_s3/I1
21.879 | 0.498 | tINS | RR | 16 | R51C51[3][A] | u_score_store_sd/controller/page_reader/stream_count_15_s3/F
22.739 | 0.860 | tNET | RR | 1 | R52C60[1][A] | u_score_store_sd/controller/page_reader/stream_count_5_s1/CE

Data Required Path:

AT | DELAY | TYPE | RF | FANOUT | LOC | NODE
20.000 | 20.000 | | | | | active clock edge time
20.000 | 0.000 | | | | | sys_clk
20.000 | 0.000 | tCL | RR | 1 | IOB117[B] | sys_clk_ibuf/I
20.683 | 0.683 | tINS | RR | 13930 | IOB117[B] | sys_clk_ibuf/O
23.862 | 3.180 | tNET | RR | 1 | R52C60[1][A] | u_score_store_sd/controller/page_reader/stream_count_5_s1/CLK
23.551 | -0.311 | tSu | | 1 | R52C60[1][A] | u_score_store_sd/controller/page_reader/stream_count_5_s1

Path Statistics:

Clock Skew | -0.486
Setup Relationship | 20.000
Logic Level | 20
Arrival Clock Path Delay | cell: 0.683, 15.696%; route: 3.666, 84.304%
Arrival Data Path Delay | cell: 8.044, 43.737%; route: 9.965, 54.183%; tC2Q: 0.382, 2.080%
Required Clock Path Delay | cell: 0.683, 17.670%; route: 3.180, 82.330%

### Path9

Path Summary:

Slack | 0.812
Data Arrival Time | 22.739
Data Required Time | 23.551
From | u_score_store_sd/controller/page_reader/indexer/bitmap_offset_0_s1
To | u_score_store_sd/controller/page_reader/stream_count_6_s1
Launch Clk | sys_clk:[R]
Latch Clk | sys_clk:[R]

Data Arrival Path:

AT | DELAY | TYPE | RF | FANOUT | LOC | NODE
0.000 | 0.000 | | | | | active clock edge time
0.000 | 0.000 | | | | | sys_clk
0.000 | 0.000 | tCL | RR | 1 | IOB117[B] | sys_clk_ibuf/I
0.683 | 0.683 | tINS | RR | 13930 | IOB117[B] | sys_clk_ibuf/O
4.348 | 3.666 | tNET | RR | 1 | R35C55[0][A] | u_score_store_sd/controller/page_reader/indexer/bitmap_offset_0_s1/CLK
4.731 | 0.382 | tC2Q | RR | 4 | R35C55[0][A] | u_score_store_sd/controller/page_reader/indexer/bitmap_offset_0_s1/Q
8.989 | 4.259 | tNET | RR | 2 | R51C54[0][A] | u_score_store_sd/controller/page_reader/n552_s64/CIN
9.039 | 0.050 | tINS | RR | 1 | R51C54[0][A] | u_score_store_sd/controller/page_reader/n552_s64/COUT
9.039 | 0.000 | tNET | RR | 2 | R51C54[0][B] | u_score_store_sd/controller/page_reader/n552_s65/CIN
9.089 | 0.050 | tINS | RR | 1 | R51C54[0][B] | u_score_store_sd/controller/page_reader/n552_s65/COUT
9.089 | 0.000 | tNET | RR | 2 | R51C54[1][A] | u_score_store_sd/controller/page_reader/n552_s66/CIN
9.139 | 0.050 | tINS | RR | 1 | R51C54[1][A] | u_score_store_sd/controller/page_reader/n552_s66/COUT
9.139 | 0.000 | tNET | RR | 2 | R51C54[1][B] | u_score_store_sd/controller/page_reader/n552_s67/CIN
9.189 | 0.050 | tINS | RR | 1 | R51C54[1][B] | u_score_store_sd/controller/page_reader/n552_s67/COUT
9.189 | 0.000 | tNET | RR | 2 | R51C54[2][A] | u_score_store_sd/controller/page_reader/n552_s68/CIN
9.239 | 0.050 | tINS | RR | 1 | R51C54[2][A] | u_score_store_sd/controller/page_reader/n552_s68/COUT
9.239 | 0.000 | tNET | RR | 2 | R51C54[2][B] | u_score_store_sd/controller/page_reader/n552_s69/CIN
9.289 | 0.050 | tINS | RR | 1 | R51C54[2][B] | u_score_store_sd/controller/page_reader/n552_s69/COUT
9.289 | 0.000 | tNET | RR | 2 | R51C55[0][A] | u_score_store_sd/controller/page_reader/n552_s70/CIN
9.339 | 0.050 | tINS | RR | 1 | R51C55[0][A] | u_score_store_sd/controller/page_reader/n552_s70/COUT
9.339 | 0.000 | tNET | RR | 2 | R51C55[0][B] | u_score_store_sd/controller/page_reader/n552_s71/CIN
9.389 | 0.050 | tINS | RR | 1 | R51C55[0][B] | u_score_store_sd/controller/page_reader/n552_s71/COUT
9.826 | 0.436 | tNET | RR | 1 | R49C55[2][A] | u_score_store_sd/controller/page_reader/n1468_s121/I1
10.287 | 0.461 | tINS | RR | 1 | R49C55[2][A] | u_score_store_sd/controller/page_reader/n1468_s121/F
10.444 | 0.157 | tNET | RR | 1 | R48C55[3][B] | u_score_store_sd/controller/page_reader/n1468_s119/I1
10.942 | 0.498 | tINS | RR | 1 | R48C55[3][B] | u_score_store_sd/controller/page_reader/n1468_s119/F
10.944 | 0.003 | tNET | RR | 1 | R48C55[1][B] | u_score_store_sd/controller/page_reader/n1468_s115/I0
11.471 | 0.526 | tINS | RR | 1 | R48C55[1][B] | u_score_store_sd/controller/page_reader/n1468_s115/F
11.774 | 0.304 | tNET | RR | 1 | R46C55[3][A] | u_score_store_sd/controller/page_reader/n1468_s104/I1
12.296 | 0.521 | tINS | RR | 6 | R46C55[3][A] | u_score_store_sd/controller/page_reader/n1468_s104/F
12.952 | 0.656 | tNET | RR | 1 | R50C55[0][B] | u_score_store_sd/controller/page_reader/n1468_s95/I1
13.478 | 0.526 | tINS | RR | 1 | R50C55[0][B] | u_score_store_sd/controller/page_reader/n1468_s95/F
13.481 | 0.003 | tNET | RR | 1 | R50C55[2][A] | u_score_store_sd/controller/page_reader/n1468_s85/I2
13.997 | 0.516 | tINS | RR | 3 | R50C55[2][A] | u_score_store_sd/controller/page_reader/n1468_s85/F
14.484 | 0.487 | tNET | RR | 1 | R49C54[1][B] | u_score_store_sd/controller/page_reader/n1468_s81/I0
15.001 | 0.516 | tINS | RR | 1 | R49C54[1][B] | u_score_store_sd/controller/page_reader/n1468_s81/F
15.158 | 0.157 | tNET | RR | 1 | R50C54[1][A] | u_score_store_sd/controller/page_reader/n1468_s79/I0
15.674 | 0.516 | tINS | RR | 1 | R50C54[1][A] | u_score_store_sd/controller/page_reader/n1468_s79/F
15.677 | 0.003 | tNET | RR | 1 | R50C54[1][B] | u_score_store_sd/controller/page_reader/n1468_s74/I1
15.939 | 0.262 | tINS | RR | 2 | R50C54[1][B] | u_score_store_sd/controller/page_reader/n1468_s74/F
16.099 | 0.160 | tNET | RR | 1 | R49C54[2][B] | u_score_store_sd/controller/page_reader/n1468_s72/I2
16.626 | 0.526 | tINS | RR | 1 | R49C54[2][B] | u_score_store_sd/controller/page_reader/n1468_s72/F
16.628 | 0.003 | tNET | RR | 1 | R49C54[3][A] | u_score_store_sd/controller/page_reader/n1468_s64/I2
17.126 | 0.498 | tINS | RR | 2 | R49C54[3][A] | u_score_store_sd/controller/page_reader/n1468_s64/F
17.666 | 0.540 | tNET | RR | 1 | R52C54[1][A] | u_score_store_sd/controller/page_reader/n1468_s51/I1
17.928 | 0.262 | tINS | RR | 3 | R52C54[1][A] | u_score_store_sd/controller/page_reader/n1468_s51/F
18.416 | 0.487 | tNET | RR | 1 | R50C53[3][B] | u_score_store_sd/controller/page_reader/n1468_s42/I0
18.913 | 0.498 | tINS | RR | 1 | R50C53[3][B] | u_score_store_sd/controller/page_reader/n1468_s42/F
19.071 | 0.157 | tNET | RR | 1 | R50C52[3][B] | u_score_store_sd/controller/page_reader/n1468_s36/I0
19.592 | 0.521 | tINS | RR | 3 | R50C52[3][B] | u_score_store_sd/controller/page_reader/n1468_s36/F
19.944 | 0.352 | tNET | RR | 1 | R48C52[3][B] | u_score_store_sd/controller/page_reader/n1468_s33/I0
20.442 | 0.498 | tINS | RR | 23 | R48C52[3][B] | u_score_store_sd/controller/page_reader/n1468_s33/F
21.382 | 0.940 | tNET | RR | 1 | R51C51[3][A] | u_score_store_sd/controller/page_reader/stream_count_15_s3/I1
21.879 | 0.498 | tINS | RR | 16 | R51C51[3][A] | u_score_store_sd/controller/page_reader/stream_count_15_s3/F
22.739 | 0.860 | tNET | RR | 1 | R52C60[1][B] | u_score_store_sd/controller/page_reader/stream_count_6_s1/CE

Data Required Path:

AT | DELAY | TYPE | RF | FANOUT | LOC | NODE
20.000 | 20.000 | | | | | active clock edge time
20.000 | 0.000 | | | | | sys_clk
20.000 | 0.000 | tCL | RR | 1 | IOB117[B] | sys_clk_ibuf/I
20.683 | 0.683 | tINS | RR | 13930 | IOB117[B] | sys_clk_ibuf/O
23.862 | 3.180 | tNET | RR | 1 | R52C60[1][B] | u_score_store_sd/controller/page_reader/stream_count_6_s1/CLK
23.551 | -0.311 | tSu | | 1 | R52C60[1][B] | u_score_store_sd/controller/page_reader/stream_count_6_s1

Path Statistics:

Clock Skew | -0.486
Setup Relationship | 20.000
Logic Level | 20
Arrival Clock Path Delay | cell: 0.683, 15.696%; route: 3.666, 84.304%
Arrival Data Path Delay | cell: 8.044, 43.737%; route: 9.965, 54.183%; tC2Q: 0.382, 2.080%
Required Clock Path Delay | cell: 0.683, 17.670%; route: 3.180, 82.330%

### Path10

Path Summary:

Slack | 0.812
Data Arrival Time | 22.739
Data Required Time | 23.551
From | u_score_store_sd/controller/page_reader/indexer/bitmap_offset_0_s1
To | u_score_store_sd/controller/page_reader/stream_count_7_s1
Launch Clk | sys_clk:[R]
Latch Clk | sys_clk:[R]

Data Arrival Path:

AT | DELAY | TYPE | RF | FANOUT | LOC | NODE
0.000 | 0.000 | | | | | active clock edge time
0.000 | 0.000 | | | | | sys_clk
0.000 | 0.000 | tCL | RR | 1 | IOB117[B] | sys_clk_ibuf/I
0.683 | 0.683 | tINS | RR | 13930 | IOB117[B] | sys_clk_ibuf/O
4.348 | 3.666 | tNET | RR | 1 | R35C55[0][A] | u_score_store_sd/controller/page_reader/indexer/bitmap_offset_0_s1/CLK
4.731 | 0.382 | tC2Q | RR | 4 | R35C55[0][A] | u_score_store_sd/controller/page_reader/indexer/bitmap_offset_0_s1/Q
8.989 | 4.259 | tNET | RR | 2 | R51C54[0][A] | u_score_store_sd/controller/page_reader/n552_s64/CIN
9.039 | 0.050 | tINS | RR | 1 | R51C54[0][A] | u_score_store_sd/controller/page_reader/n552_s64/COUT
9.039 | 0.000 | tNET | RR | 2 | R51C54[0][B] | u_score_store_sd/controller/page_reader/n552_s65/CIN
9.089 | 0.050 | tINS | RR | 1 | R51C54[0][B] | u_score_store_sd/controller/page_reader/n552_s65/COUT
9.089 | 0.000 | tNET | RR | 2 | R51C54[1][A] | u_score_store_sd/controller/page_reader/n552_s66/CIN
9.139 | 0.050 | tINS | RR | 1 | R51C54[1][A] | u_score_store_sd/controller/page_reader/n552_s66/COUT
9.139 | 0.000 | tNET | RR | 2 | R51C54[1][B] | u_score_store_sd/controller/page_reader/n552_s67/CIN
9.189 | 0.050 | tINS | RR | 1 | R51C54[1][B] | u_score_store_sd/controller/page_reader/n552_s67/COUT
9.189 | 0.000 | tNET | RR | 2 | R51C54[2][A] | u_score_store_sd/controller/page_reader/n552_s68/CIN
9.239 | 0.050 | tINS | RR | 1 | R51C54[2][A] | u_score_store_sd/controller/page_reader/n552_s68/COUT
9.239 | 0.000 | tNET | RR | 2 | R51C54[2][B] | u_score_store_sd/controller/page_reader/n552_s69/CIN
9.289 | 0.050 | tINS | RR | 1 | R51C54[2][B] | u_score_store_sd/controller/page_reader/n552_s69/COUT
9.289 | 0.000 | tNET | RR | 2 | R51C55[0][A] | u_score_store_sd/controller/page_reader/n552_s70/CIN
9.339 | 0.050 | tINS | RR | 1 | R51C55[0][A] | u_score_store_sd/controller/page_reader/n552_s70/COUT
9.339 | 0.000 | tNET | RR | 2 | R51C55[0][B] | u_score_store_sd/controller/page_reader/n552_s71/CIN
9.389 | 0.050 | tINS | RR | 1 | R51C55[0][B] | u_score_store_sd/controller/page_reader/n552_s71/COUT
9.826 | 0.436 | tNET | RR | 1 | R49C55[2][A] | u_score_store_sd/controller/page_reader/n1468_s121/I1
10.287 | 0.461 | tINS | RR | 1 | R49C55[2][A] | u_score_store_sd/controller/page_reader/n1468_s121/F
10.444 | 0.157 | tNET | RR | 1 | R48C55[3][B] | u_score_store_sd/controller/page_reader/n1468_s119/I1
10.942 | 0.498 | tINS | RR | 1 | R48C55[3][B] | u_score_store_sd/controller/page_reader/n1468_s119/F
10.944 | 0.003 | tNET | RR | 1 | R48C55[1][B] | u_score_store_sd/controller/page_reader/n1468_s115/I0
11.471 | 0.526 | tINS | RR | 1 | R48C55[1][B] | u_score_store_sd/controller/page_reader/n1468_s115/F
11.774 | 0.304 | tNET | RR | 1 | R46C55[3][A] | u_score_store_sd/controller/page_reader/n1468_s104/I1
12.296 | 0.521 | tINS | RR | 6 | R46C55[3][A] | u_score_store_sd/controller/page_reader/n1468_s104/F
12.952 | 0.656 | tNET | RR | 1 | R50C55[0][B] | u_score_store_sd/controller/page_reader/n1468_s95/I1
13.478 | 0.526 | tINS | RR | 1 | R50C55[0][B] | u_score_store_sd/controller/page_reader/n1468_s95/F
13.481 | 0.003 | tNET | RR | 1 | R50C55[2][A] | u_score_store_sd/controller/page_reader/n1468_s85/I2
13.997 | 0.516 | tINS | RR | 3 | R50C55[2][A] | u_score_store_sd/controller/page_reader/n1468_s85/F
14.484 | 0.487 | tNET | RR | 1 | R49C54[1][B] | u_score_store_sd/controller/page_reader/n1468_s81/I0
15.001 | 0.516 | tINS | RR | 1 | R49C54[1][B] | u_score_store_sd/controller/page_reader/n1468_s81/F
15.158 | 0.157 | tNET | RR | 1 | R50C54[1][A] | u_score_store_sd/controller/page_reader/n1468_s79/I0
15.674 | 0.516 | tINS | RR | 1 | R50C54[1][A] | u_score_store_sd/controller/page_reader/n1468_s79/F
15.677 | 0.003 | tNET | RR | 1 | R50C54[1][B] | u_score_store_sd/controller/page_reader/n1468_s74/I1
15.939 | 0.262 | tINS | RR | 2 | R50C54[1][B] | u_score_store_sd/controller/page_reader/n1468_s74/F
16.099 | 0.160 | tNET | RR | 1 | R49C54[2][B] | u_score_store_sd/controller/page_reader/n1468_s72/I2
16.626 | 0.526 | tINS | RR | 1 | R49C54[2][B] | u_score_store_sd/controller/page_reader/n1468_s72/F
16.628 | 0.003 | tNET | RR | 1 | R49C54[3][A] | u_score_store_sd/controller/page_reader/n1468_s64/I2
17.126 | 0.498 | tINS | RR | 2 | R49C54[3][A] | u_score_store_sd/controller/page_reader/n1468_s64/F
17.666 | 0.540 | tNET | RR | 1 | R52C54[1][A] | u_score_store_sd/controller/page_reader/n1468_s51/I1
17.928 | 0.262 | tINS | RR | 3 | R52C54[1][A] | u_score_store_sd/controller/page_reader/n1468_s51/F
18.416 | 0.487 | tNET | RR | 1 | R50C53[3][B] | u_score_store_sd/controller/page_reader/n1468_s42/I0
18.913 | 0.498 | tINS | RR | 1 | R50C53[3][B] | u_score_store_sd/controller/page_reader/n1468_s42/F
19.071 | 0.157 | tNET | RR | 1 | R50C52[3][B] | u_score_store_sd/controller/page_reader/n1468_s36/I0
19.592 | 0.521 | tINS | RR | 3 | R50C52[3][B] | u_score_store_sd/controller/page_reader/n1468_s36/F
19.944 | 0.352 | tNET | RR | 1 | R48C52[3][B] | u_score_store_sd/controller/page_reader/n1468_s33/I0
20.442 | 0.498 | tINS | RR | 23 | R48C52[3][B] | u_score_store_sd/controller/page_reader/n1468_s33/F
21.382 | 0.940 | tNET | RR | 1 | R51C51[3][A] | u_score_store_sd/controller/page_reader/stream_count_15_s3/I1
21.879 | 0.498 | tINS | RR | 16 | R51C51[3][A] | u_score_store_sd/controller/page_reader/stream_count_15_s3/F
22.739 | 0.860 | tNET | RR | 1 | R52C60[2][A] | u_score_store_sd/controller/page_reader/stream_count_7_s1/CE

Data Required Path:

AT | DELAY | TYPE | RF | FANOUT | LOC | NODE
20.000 | 20.000 | | | | | active clock edge time
20.000 | 0.000 | | | | | sys_clk
20.000 | 0.000 | tCL | RR | 1 | IOB117[B] | sys_clk_ibuf/I
20.683 | 0.683 | tINS | RR | 13930 | IOB117[B] | sys_clk_ibuf/O
23.862 | 3.180 | tNET | RR | 1 | R52C60[2][A] | u_score_store_sd/controller/page_reader/stream_count_7_s1/CLK
23.551 | -0.311 | tSu | | 1 | R52C60[2][A] | u_score_store_sd/controller/page_reader/stream_count_7_s1

Path Statistics:

Clock Skew | -0.486
Setup Relationship | 20.000
Logic Level | 20
Arrival Clock Path Delay | cell: 0.683, 15.696%; route: 3.666, 84.304%
Arrival Data Path Delay | cell: 8.044, 43.737%; route: 9.965, 54.183%; tC2Q: 0.382, 2.080%
Required Clock Path Delay | cell: 0.683, 17.670%; route: 3.180, 82.330%

### Path11

Path Summary:

Slack | 0.855
Data Arrival Time | 22.687
Data Required Time | 23.542
From | u_score_store_sd/controller/page_reader/indexer/bitmap_offset_0_s1
To | u_score_store_sd/controller/page_reader/stream_count_1_s1
Launch Clk | sys_clk:[R]
Latch Clk | sys_clk:[R]

Data Arrival Path:

AT | DELAY | TYPE | RF | FANOUT | LOC | NODE
0.000 | 0.000 | | | | | active clock edge time
0.000 | 0.000 | | | | | sys_clk
0.000 | 0.000 | tCL | RR | 1 | IOB117[B] | sys_clk_ibuf/I
0.683 | 0.683 | tINS | RR | 13930 | IOB117[B] | sys_clk_ibuf/O
4.348 | 3.666 | tNET | RR | 1 | R35C55[0][A] | u_score_store_sd/controller/page_reader/indexer/bitmap_offset_0_s1/CLK
4.731 | 0.382 | tC2Q | RR | 4 | R35C55[0][A] | u_score_store_sd/controller/page_reader/indexer/bitmap_offset_0_s1/Q
8.989 | 4.259 | tNET | RR | 2 | R51C54[0][A] | u_score_store_sd/controller/page_reader/n552_s64/CIN
9.039 | 0.050 | tINS | RR | 1 | R51C54[0][A] | u_score_store_sd/controller/page_reader/n552_s64/COUT
9.039 | 0.000 | tNET | RR | 2 | R51C54[0][B] | u_score_store_sd/controller/page_reader/n552_s65/CIN
9.089 | 0.050 | tINS | RR | 1 | R51C54[0][B] | u_score_store_sd/controller/page_reader/n552_s65/COUT
9.089 | 0.000 | tNET | RR | 2 | R51C54[1][A] | u_score_store_sd/controller/page_reader/n552_s66/CIN
9.139 | 0.050 | tINS | RR | 1 | R51C54[1][A] | u_score_store_sd/controller/page_reader/n552_s66/COUT
9.139 | 0.000 | tNET | RR | 2 | R51C54[1][B] | u_score_store_sd/controller/page_reader/n552_s67/CIN
9.189 | 0.050 | tINS | RR | 1 | R51C54[1][B] | u_score_store_sd/controller/page_reader/n552_s67/COUT
9.189 | 0.000 | tNET | RR | 2 | R51C54[2][A] | u_score_store_sd/controller/page_reader/n552_s68/CIN
9.239 | 0.050 | tINS | RR | 1 | R51C54[2][A] | u_score_store_sd/controller/page_reader/n552_s68/COUT
9.239 | 0.000 | tNET | RR | 2 | R51C54[2][B] | u_score_store_sd/controller/page_reader/n552_s69/CIN
9.289 | 0.050 | tINS | RR | 1 | R51C54[2][B] | u_score_store_sd/controller/page_reader/n552_s69/COUT
9.289 | 0.000 | tNET | RR | 2 | R51C55[0][A] | u_score_store_sd/controller/page_reader/n552_s70/CIN
9.339 | 0.050 | tINS | RR | 1 | R51C55[0][A] | u_score_store_sd/controller/page_reader/n552_s70/COUT
9.339 | 0.000 | tNET | RR | 2 | R51C55[0][B] | u_score_store_sd/controller/page_reader/n552_s71/CIN
9.389 | 0.050 | tINS | RR | 1 | R51C55[0][B] | u_score_store_sd/controller/page_reader/n552_s71/COUT
9.826 | 0.436 | tNET | RR | 1 | R49C55[2][A] | u_score_store_sd/controller/page_reader/n1468_s121/I1
10.287 | 0.461 | tINS | RR | 1 | R49C55[2][A] | u_score_store_sd/controller/page_reader/n1468_s121/F
10.444 | 0.157 | tNET | RR | 1 | R48C55[3][B] | u_score_store_sd/controller/page_reader/n1468_s119/I1
10.942 | 0.498 | tINS | RR | 1 | R48C55[3][B] | u_score_store_sd/controller/page_reader/n1468_s119/F
10.944 | 0.003 | tNET | RR | 1 | R48C55[1][B] | u_score_store_sd/controller/page_reader/n1468_s115/I0
11.471 | 0.526 | tINS | RR | 1 | R48C55[1][B] | u_score_store_sd/controller/page_reader/n1468_s115/F
11.774 | 0.304 | tNET | RR | 1 | R46C55[3][A] | u_score_store_sd/controller/page_reader/n1468_s104/I1
12.296 | 0.521 | tINS | RR | 6 | R46C55[3][A] | u_score_store_sd/controller/page_reader/n1468_s104/F
12.952 | 0.656 | tNET | RR | 1 | R50C55[0][B] | u_score_store_sd/controller/page_reader/n1468_s95/I1
13.478 | 0.526 | tINS | RR | 1 | R50C55[0][B] | u_score_store_sd/controller/page_reader/n1468_s95/F
13.481 | 0.003 | tNET | RR | 1 | R50C55[2][A] | u_score_store_sd/controller/page_reader/n1468_s85/I2
13.997 | 0.516 | tINS | RR | 3 | R50C55[2][A] | u_score_store_sd/controller/page_reader/n1468_s85/F
14.484 | 0.487 | tNET | RR | 1 | R49C54[1][B] | u_score_store_sd/controller/page_reader/n1468_s81/I0
15.001 | 0.516 | tINS | RR | 1 | R49C54[1][B] | u_score_store_sd/controller/page_reader/n1468_s81/F
15.158 | 0.157 | tNET | RR | 1 | R50C54[1][A] | u_score_store_sd/controller/page_reader/n1468_s79/I0
15.674 | 0.516 | tINS | RR | 1 | R50C54[1][A] | u_score_store_sd/controller/page_reader/n1468_s79/F
15.677 | 0.003 | tNET | RR | 1 | R50C54[1][B] | u_score_store_sd/controller/page_reader/n1468_s74/I1
15.939 | 0.262 | tINS | RR | 2 | R50C54[1][B] | u_score_store_sd/controller/page_reader/n1468_s74/F
16.099 | 0.160 | tNET | RR | 1 | R49C54[2][B] | u_score_store_sd/controller/page_reader/n1468_s72/I2
16.626 | 0.526 | tINS | RR | 1 | R49C54[2][B] | u_score_store_sd/controller/page_reader/n1468_s72/F
16.628 | 0.003 | tNET | RR | 1 | R49C54[3][A] | u_score_store_sd/controller/page_reader/n1468_s64/I2
17.126 | 0.498 | tINS | RR | 2 | R49C54[3][A] | u_score_store_sd/controller/page_reader/n1468_s64/F
17.666 | 0.540 | tNET | RR | 1 | R52C54[1][A] | u_score_store_sd/controller/page_reader/n1468_s51/I1
17.928 | 0.262 | tINS | RR | 3 | R52C54[1][A] | u_score_store_sd/controller/page_reader/n1468_s51/F
18.416 | 0.487 | tNET | RR | 1 | R50C53[3][B] | u_score_store_sd/controller/page_reader/n1468_s42/I0
18.913 | 0.498 | tINS | RR | 1 | R50C53[3][B] | u_score_store_sd/controller/page_reader/n1468_s42/F
19.071 | 0.157 | tNET | RR | 1 | R50C52[3][B] | u_score_store_sd/controller/page_reader/n1468_s36/I0
19.592 | 0.521 | tINS | RR | 3 | R50C52[3][B] | u_score_store_sd/controller/page_reader/n1468_s36/F
19.944 | 0.352 | tNET | RR | 1 | R48C52[3][B] | u_score_store_sd/controller/page_reader/n1468_s33/I0
20.442 | 0.498 | tINS | RR | 23 | R48C52[3][B] | u_score_store_sd/controller/page_reader/n1468_s33/F
21.382 | 0.940 | tNET | RR | 1 | R51C51[3][A] | u_score_store_sd/controller/page_reader/stream_count_15_s3/I1
21.879 | 0.498 | tINS | RR | 16 | R51C51[3][A] | u_score_store_sd/controller/page_reader/stream_count_15_s3/F
22.687 | 0.807 | tNET | RR | 1 | R52C57[2][B] | u_score_store_sd/controller/page_reader/stream_count_1_s1/CE

Data Required Path:

AT | DELAY | TYPE | RF | FANOUT | LOC | NODE
20.000 | 20.000 | | | | | active clock edge time
20.000 | 0.000 | | | | | sys_clk
20.000 | 0.000 | tCL | RR | 1 | IOB117[B] | sys_clk_ibuf/I
20.683 | 0.683 | tINS | RR | 13930 | IOB117[B] | sys_clk_ibuf/O
23.853 | 3.171 | tNET | RR | 1 | R52C57[2][B] | u_score_store_sd/controller/page_reader/stream_count_1_s1/CLK
23.542 | -0.311 | tSu | | 1 | R52C57[2][B] | u_score_store_sd/controller/page_reader/stream_count_1_s1

Path Statistics:

Clock Skew | -0.495
Setup Relationship | 20.000
Logic Level | 20
Arrival Clock Path Delay | cell: 0.683, 15.696%; route: 3.666, 84.304%
Arrival Data Path Delay | cell: 8.044, 43.862%; route: 9.913, 54.052%; tC2Q: 0.382, 2.086%
Required Clock Path Delay | cell: 0.683, 17.713%; route: 3.171, 82.287%

### Path12

Path Summary:

Slack | 0.855
Data Arrival Time | 22.687
Data Required Time | 23.542
From | u_score_store_sd/controller/page_reader/indexer/bitmap_offset_0_s1
To | u_score_store_sd/controller/page_reader/stream_count_2_s1
Launch Clk | sys_clk:[R]
Latch Clk | sys_clk:[R]

Data Arrival Path:

AT | DELAY | TYPE | RF | FANOUT | LOC | NODE
0.000 | 0.000 | | | | | active clock edge time
0.000 | 0.000 | | | | | sys_clk
0.000 | 0.000 | tCL | RR | 1 | IOB117[B] | sys_clk_ibuf/I
0.683 | 0.683 | tINS | RR | 13930 | IOB117[B] | sys_clk_ibuf/O
4.348 | 3.666 | tNET | RR | 1 | R35C55[0][A] | u_score_store_sd/controller/page_reader/indexer/bitmap_offset_0_s1/CLK
4.731 | 0.382 | tC2Q | RR | 4 | R35C55[0][A] | u_score_store_sd/controller/page_reader/indexer/bitmap_offset_0_s1/Q
8.989 | 4.259 | tNET | RR | 2 | R51C54[0][A] | u_score_store_sd/controller/page_reader/n552_s64/CIN
9.039 | 0.050 | tINS | RR | 1 | R51C54[0][A] | u_score_store_sd/controller/page_reader/n552_s64/COUT
9.039 | 0.000 | tNET | RR | 2 | R51C54[0][B] | u_score_store_sd/controller/page_reader/n552_s65/CIN
9.089 | 0.050 | tINS | RR | 1 | R51C54[0][B] | u_score_store_sd/controller/page_reader/n552_s65/COUT
9.089 | 0.000 | tNET | RR | 2 | R51C54[1][A] | u_score_store_sd/controller/page_reader/n552_s66/CIN
9.139 | 0.050 | tINS | RR | 1 | R51C54[1][A] | u_score_store_sd/controller/page_reader/n552_s66/COUT
9.139 | 0.000 | tNET | RR | 2 | R51C54[1][B] | u_score_store_sd/controller/page_reader/n552_s67/CIN
9.189 | 0.050 | tINS | RR | 1 | R51C54[1][B] | u_score_store_sd/controller/page_reader/n552_s67/COUT
9.189 | 0.000 | tNET | RR | 2 | R51C54[2][A] | u_score_store_sd/controller/page_reader/n552_s68/CIN
9.239 | 0.050 | tINS | RR | 1 | R51C54[2][A] | u_score_store_sd/controller/page_reader/n552_s68/COUT
9.239 | 0.000 | tNET | RR | 2 | R51C54[2][B] | u_score_store_sd/controller/page_reader/n552_s69/CIN
9.289 | 0.050 | tINS | RR | 1 | R51C54[2][B] | u_score_store_sd/controller/page_reader/n552_s69/COUT
9.289 | 0.000 | tNET | RR | 2 | R51C55[0][A] | u_score_store_sd/controller/page_reader/n552_s70/CIN
9.339 | 0.050 | tINS | RR | 1 | R51C55[0][A] | u_score_store_sd/controller/page_reader/n552_s70/COUT
9.339 | 0.000 | tNET | RR | 2 | R51C55[0][B] | u_score_store_sd/controller/page_reader/n552_s71/CIN
9.389 | 0.050 | tINS | RR | 1 | R51C55[0][B] | u_score_store_sd/controller/page_reader/n552_s71/COUT
9.826 | 0.436 | tNET | RR | 1 | R49C55[2][A] | u_score_store_sd/controller/page_reader/n1468_s121/I1
10.287 | 0.461 | tINS | RR | 1 | R49C55[2][A] | u_score_store_sd/controller/page_reader/n1468_s121/F
10.444 | 0.157 | tNET | RR | 1 | R48C55[3][B] | u_score_store_sd/controller/page_reader/n1468_s119/I1
10.942 | 0.498 | tINS | RR | 1 | R48C55[3][B] | u_score_store_sd/controller/page_reader/n1468_s119/F
10.944 | 0.003 | tNET | RR | 1 | R48C55[1][B] | u_score_store_sd/controller/page_reader/n1468_s115/I0
11.471 | 0.526 | tINS | RR | 1 | R48C55[1][B] | u_score_store_sd/controller/page_reader/n1468_s115/F
11.774 | 0.304 | tNET | RR | 1 | R46C55[3][A] | u_score_store_sd/controller/page_reader/n1468_s104/I1
12.296 | 0.521 | tINS | RR | 6 | R46C55[3][A] | u_score_store_sd/controller/page_reader/n1468_s104/F
12.952 | 0.656 | tNET | RR | 1 | R50C55[0][B] | u_score_store_sd/controller/page_reader/n1468_s95/I1
13.478 | 0.526 | tINS | RR | 1 | R50C55[0][B] | u_score_store_sd/controller/page_reader/n1468_s95/F
13.481 | 0.003 | tNET | RR | 1 | R50C55[2][A] | u_score_store_sd/controller/page_reader/n1468_s85/I2
13.997 | 0.516 | tINS | RR | 3 | R50C55[2][A] | u_score_store_sd/controller/page_reader/n1468_s85/F
14.484 | 0.487 | tNET | RR | 1 | R49C54[1][B] | u_score_store_sd/controller/page_reader/n1468_s81/I0
15.001 | 0.516 | tINS | RR | 1 | R49C54[1][B] | u_score_store_sd/controller/page_reader/n1468_s81/F
15.158 | 0.157 | tNET | RR | 1 | R50C54[1][A] | u_score_store_sd/controller/page_reader/n1468_s79/I0
15.674 | 0.516 | tINS | RR | 1 | R50C54[1][A] | u_score_store_sd/controller/page_reader/n1468_s79/F
15.677 | 0.003 | tNET | RR | 1 | R50C54[1][B] | u_score_store_sd/controller/page_reader/n1468_s74/I1
15.939 | 0.262 | tINS | RR | 2 | R50C54[1][B] | u_score_store_sd/controller/page_reader/n1468_s74/F
16.099 | 0.160 | tNET | RR | 1 | R49C54[2][B] | u_score_store_sd/controller/page_reader/n1468_s72/I2
16.626 | 0.526 | tINS | RR | 1 | R49C54[2][B] | u_score_store_sd/controller/page_reader/n1468_s72/F
16.628 | 0.003 | tNET | RR | 1 | R49C54[3][A] | u_score_store_sd/controller/page_reader/n1468_s64/I2
17.126 | 0.498 | tINS | RR | 2 | R49C54[3][A] | u_score_store_sd/controller/page_reader/n1468_s64/F
17.666 | 0.540 | tNET | RR | 1 | R52C54[1][A] | u_score_store_sd/controller/page_reader/n1468_s51/I1
17.928 | 0.262 | tINS | RR | 3 | R52C54[1][A] | u_score_store_sd/controller/page_reader/n1468_s51/F
18.416 | 0.487 | tNET | RR | 1 | R50C53[3][B] | u_score_store_sd/controller/page_reader/n1468_s42/I0
18.913 | 0.498 | tINS | RR | 1 | R50C53[3][B] | u_score_store_sd/controller/page_reader/n1468_s42/F
19.071 | 0.157 | tNET | RR | 1 | R50C52[3][B] | u_score_store_sd/controller/page_reader/n1468_s36/I0
19.592 | 0.521 | tINS | RR | 3 | R50C52[3][B] | u_score_store_sd/controller/page_reader/n1468_s36/F
19.944 | 0.352 | tNET | RR | 1 | R48C52[3][B] | u_score_store_sd/controller/page_reader/n1468_s33/I0
20.442 | 0.498 | tINS | RR | 23 | R48C52[3][B] | u_score_store_sd/controller/page_reader/n1468_s33/F
21.382 | 0.940 | tNET | RR | 1 | R51C51[3][A] | u_score_store_sd/controller/page_reader/stream_count_15_s3/I1
21.879 | 0.498 | tINS | RR | 16 | R51C51[3][A] | u_score_store_sd/controller/page_reader/stream_count_15_s3/F
22.687 | 0.807 | tNET | RR | 1 | R52C57[3][A] | u_score_store_sd/controller/page_reader/stream_count_2_s1/CE

Data Required Path:

AT | DELAY | TYPE | RF | FANOUT | LOC | NODE
20.000 | 20.000 | | | | | active clock edge time
20.000 | 0.000 | | | | | sys_clk
20.000 | 0.000 | tCL | RR | 1 | IOB117[B] | sys_clk_ibuf/I
20.683 | 0.683 | tINS | RR | 13930 | IOB117[B] | sys_clk_ibuf/O
23.853 | 3.171 | tNET | RR | 1 | R52C57[3][A] | u_score_store_sd/controller/page_reader/stream_count_2_s1/CLK
23.542 | -0.311 | tSu | | 1 | R52C57[3][A] | u_score_store_sd/controller/page_reader/stream_count_2_s1

Path Statistics:

Clock Skew | -0.495
Setup Relationship | 20.000
Logic Level | 20
Arrival Clock Path Delay | cell: 0.683, 15.696%; route: 3.666, 84.304%
Arrival Data Path Delay | cell: 8.044, 43.862%; route: 9.913, 54.052%; tC2Q: 0.382, 2.086%
Required Clock Path Delay | cell: 0.683, 17.713%; route: 3.171, 82.287%

### Path13

Path Summary:

Slack | 0.855
Data Arrival Time | 22.687
Data Required Time | 23.542
From | u_score_store_sd/controller/page_reader/indexer/bitmap_offset_0_s1
To | u_score_store_sd/controller/page_reader/stream_count_3_s1
Launch Clk | sys_clk:[R]
Latch Clk | sys_clk:[R]

Data Arrival Path:

AT | DELAY | TYPE | RF | FANOUT | LOC | NODE
0.000 | 0.000 | | | | | active clock edge time
0.000 | 0.000 | | | | | sys_clk
0.000 | 0.000 | tCL | RR | 1 | IOB117[B] | sys_clk_ibuf/I
0.683 | 0.683 | tINS | RR | 13930 | IOB117[B] | sys_clk_ibuf/O
4.348 | 3.666 | tNET | RR | 1 | R35C55[0][A] | u_score_store_sd/controller/page_reader/indexer/bitmap_offset_0_s1/CLK
4.731 | 0.382 | tC2Q | RR | 4 | R35C55[0][A] | u_score_store_sd/controller/page_reader/indexer/bitmap_offset_0_s1/Q
8.989 | 4.259 | tNET | RR | 2 | R51C54[0][A] | u_score_store_sd/controller/page_reader/n552_s64/CIN
9.039 | 0.050 | tINS | RR | 1 | R51C54[0][A] | u_score_store_sd/controller/page_reader/n552_s64/COUT
9.039 | 0.000 | tNET | RR | 2 | R51C54[0][B] | u_score_store_sd/controller/page_reader/n552_s65/CIN
9.089 | 0.050 | tINS | RR | 1 | R51C54[0][B] | u_score_store_sd/controller/page_reader/n552_s65/COUT
9.089 | 0.000 | tNET | RR | 2 | R51C54[1][A] | u_score_store_sd/controller/page_reader/n552_s66/CIN
9.139 | 0.050 | tINS | RR | 1 | R51C54[1][A] | u_score_store_sd/controller/page_reader/n552_s66/COUT
9.139 | 0.000 | tNET | RR | 2 | R51C54[1][B] | u_score_store_sd/controller/page_reader/n552_s67/CIN
9.189 | 0.050 | tINS | RR | 1 | R51C54[1][B] | u_score_store_sd/controller/page_reader/n552_s67/COUT
9.189 | 0.000 | tNET | RR | 2 | R51C54[2][A] | u_score_store_sd/controller/page_reader/n552_s68/CIN
9.239 | 0.050 | tINS | RR | 1 | R51C54[2][A] | u_score_store_sd/controller/page_reader/n552_s68/COUT
9.239 | 0.000 | tNET | RR | 2 | R51C54[2][B] | u_score_store_sd/controller/page_reader/n552_s69/CIN
9.289 | 0.050 | tINS | RR | 1 | R51C54[2][B] | u_score_store_sd/controller/page_reader/n552_s69/COUT
9.289 | 0.000 | tNET | RR | 2 | R51C55[0][A] | u_score_store_sd/controller/page_reader/n552_s70/CIN
9.339 | 0.050 | tINS | RR | 1 | R51C55[0][A] | u_score_store_sd/controller/page_reader/n552_s70/COUT
9.339 | 0.000 | tNET | RR | 2 | R51C55[0][B] | u_score_store_sd/controller/page_reader/n552_s71/CIN
9.389 | 0.050 | tINS | RR | 1 | R51C55[0][B] | u_score_store_sd/controller/page_reader/n552_s71/COUT
9.826 | 0.436 | tNET | RR | 1 | R49C55[2][A] | u_score_store_sd/controller/page_reader/n1468_s121/I1
10.287 | 0.461 | tINS | RR | 1 | R49C55[2][A] | u_score_store_sd/controller/page_reader/n1468_s121/F
10.444 | 0.157 | tNET | RR | 1 | R48C55[3][B] | u_score_store_sd/controller/page_reader/n1468_s119/I1
10.942 | 0.498 | tINS | RR | 1 | R48C55[3][B] | u_score_store_sd/controller/page_reader/n1468_s119/F
10.944 | 0.003 | tNET | RR | 1 | R48C55[1][B] | u_score_store_sd/controller/page_reader/n1468_s115/I0
11.471 | 0.526 | tINS | RR | 1 | R48C55[1][B] | u_score_store_sd/controller/page_reader/n1468_s115/F
11.774 | 0.304 | tNET | RR | 1 | R46C55[3][A] | u_score_store_sd/controller/page_reader/n1468_s104/I1
12.296 | 0.521 | tINS | RR | 6 | R46C55[3][A] | u_score_store_sd/controller/page_reader/n1468_s104/F
12.952 | 0.656 | tNET | RR | 1 | R50C55[0][B] | u_score_store_sd/controller/page_reader/n1468_s95/I1
13.478 | 0.526 | tINS | RR | 1 | R50C55[0][B] | u_score_store_sd/controller/page_reader/n1468_s95/F
13.481 | 0.003 | tNET | RR | 1 | R50C55[2][A] | u_score_store_sd/controller/page_reader/n1468_s85/I2
13.997 | 0.516 | tINS | RR | 3 | R50C55[2][A] | u_score_store_sd/controller/page_reader/n1468_s85/F
14.484 | 0.487 | tNET | RR | 1 | R49C54[1][B] | u_score_store_sd/controller/page_reader/n1468_s81/I0
15.001 | 0.516 | tINS | RR | 1 | R49C54[1][B] | u_score_store_sd/controller/page_reader/n1468_s81/F
15.158 | 0.157 | tNET | RR | 1 | R50C54[1][A] | u_score_store_sd/controller/page_reader/n1468_s79/I0
15.674 | 0.516 | tINS | RR | 1 | R50C54[1][A] | u_score_store_sd/controller/page_reader/n1468_s79/F
15.677 | 0.003 | tNET | RR | 1 | R50C54[1][B] | u_score_store_sd/controller/page_reader/n1468_s74/I1
15.939 | 0.262 | tINS | RR | 2 | R50C54[1][B] | u_score_store_sd/controller/page_reader/n1468_s74/F
16.099 | 0.160 | tNET | RR | 1 | R49C54[2][B] | u_score_store_sd/controller/page_reader/n1468_s72/I2
16.626 | 0.526 | tINS | RR | 1 | R49C54[2][B] | u_score_store_sd/controller/page_reader/n1468_s72/F
16.628 | 0.003 | tNET | RR | 1 | R49C54[3][A] | u_score_store_sd/controller/page_reader/n1468_s64/I2
17.126 | 0.498 | tINS | RR | 2 | R49C54[3][A] | u_score_store_sd/controller/page_reader/n1468_s64/F
17.666 | 0.540 | tNET | RR | 1 | R52C54[1][A] | u_score_store_sd/controller/page_reader/n1468_s51/I1
17.928 | 0.262 | tINS | RR | 3 | R52C54[1][A] | u_score_store_sd/controller/page_reader/n1468_s51/F
18.416 | 0.487 | tNET | RR | 1 | R50C53[3][B] | u_score_store_sd/controller/page_reader/n1468_s42/I0
18.913 | 0.498 | tINS | RR | 1 | R50C53[3][B] | u_score_store_sd/controller/page_reader/n1468_s42/F
19.071 | 0.157 | tNET | RR | 1 | R50C52[3][B] | u_score_store_sd/controller/page_reader/n1468_s36/I0
19.592 | 0.521 | tINS | RR | 3 | R50C52[3][B] | u_score_store_sd/controller/page_reader/n1468_s36/F
19.944 | 0.352 | tNET | RR | 1 | R48C52[3][B] | u_score_store_sd/controller/page_reader/n1468_s33/I0
20.442 | 0.498 | tINS | RR | 23 | R48C52[3][B] | u_score_store_sd/controller/page_reader/n1468_s33/F
21.382 | 0.940 | tNET | RR | 1 | R51C51[3][A] | u_score_store_sd/controller/page_reader/stream_count_15_s3/I1
21.879 | 0.498 | tINS | RR | 16 | R51C51[3][A] | u_score_store_sd/controller/page_reader/stream_count_15_s3/F
22.687 | 0.807 | tNET | RR | 1 | R52C57[3][B] | u_score_store_sd/controller/page_reader/stream_count_3_s1/CE

Data Required Path:

AT | DELAY | TYPE | RF | FANOUT | LOC | NODE
20.000 | 20.000 | | | | | active clock edge time
20.000 | 0.000 | | | | | sys_clk
20.000 | 0.000 | tCL | RR | 1 | IOB117[B] | sys_clk_ibuf/I
20.683 | 0.683 | tINS | RR | 13930 | IOB117[B] | sys_clk_ibuf/O
23.853 | 3.171 | tNET | RR | 1 | R52C57[3][B] | u_score_store_sd/controller/page_reader/stream_count_3_s1/CLK
23.542 | -0.311 | tSu | | 1 | R52C57[3][B] | u_score_store_sd/controller/page_reader/stream_count_3_s1

Path Statistics:

Clock Skew | -0.495
Setup Relationship | 20.000
Logic Level | 20
Arrival Clock Path Delay | cell: 0.683, 15.696%; route: 3.666, 84.304%
Arrival Data Path Delay | cell: 8.044, 43.862%; route: 9.913, 54.052%; tC2Q: 0.382, 2.086%
Required Clock Path Delay | cell: 0.683, 17.713%; route: 3.171, 82.287%

### Path14

Path Summary:

Slack | 0.855
Data Arrival Time | 22.687
Data Required Time | 23.542
From | u_score_store_sd/controller/page_reader/indexer/bitmap_offset_0_s1
To | u_score_store_sd/controller/page_reader/stream_count_11_s1
Launch Clk | sys_clk:[R]
Latch Clk | sys_clk:[R]

Data Arrival Path:

AT | DELAY | TYPE | RF | FANOUT | LOC | NODE
0.000 | 0.000 | | | | | active clock edge time
0.000 | 0.000 | | | | | sys_clk
0.000 | 0.000 | tCL | RR | 1 | IOB117[B] | sys_clk_ibuf/I
0.683 | 0.683 | tINS | RR | 13930 | IOB117[B] | sys_clk_ibuf/O
4.348 | 3.666 | tNET | RR | 1 | R35C55[0][A] | u_score_store_sd/controller/page_reader/indexer/bitmap_offset_0_s1/CLK
4.731 | 0.382 | tC2Q | RR | 4 | R35C55[0][A] | u_score_store_sd/controller/page_reader/indexer/bitmap_offset_0_s1/Q
8.989 | 4.259 | tNET | RR | 2 | R51C54[0][A] | u_score_store_sd/controller/page_reader/n552_s64/CIN
9.039 | 0.050 | tINS | RR | 1 | R51C54[0][A] | u_score_store_sd/controller/page_reader/n552_s64/COUT
9.039 | 0.000 | tNET | RR | 2 | R51C54[0][B] | u_score_store_sd/controller/page_reader/n552_s65/CIN
9.089 | 0.050 | tINS | RR | 1 | R51C54[0][B] | u_score_store_sd/controller/page_reader/n552_s65/COUT
9.089 | 0.000 | tNET | RR | 2 | R51C54[1][A] | u_score_store_sd/controller/page_reader/n552_s66/CIN
9.139 | 0.050 | tINS | RR | 1 | R51C54[1][A] | u_score_store_sd/controller/page_reader/n552_s66/COUT
9.139 | 0.000 | tNET | RR | 2 | R51C54[1][B] | u_score_store_sd/controller/page_reader/n552_s67/CIN
9.189 | 0.050 | tINS | RR | 1 | R51C54[1][B] | u_score_store_sd/controller/page_reader/n552_s67/COUT
9.189 | 0.000 | tNET | RR | 2 | R51C54[2][A] | u_score_store_sd/controller/page_reader/n552_s68/CIN
9.239 | 0.050 | tINS | RR | 1 | R51C54[2][A] | u_score_store_sd/controller/page_reader/n552_s68/COUT
9.239 | 0.000 | tNET | RR | 2 | R51C54[2][B] | u_score_store_sd/controller/page_reader/n552_s69/CIN
9.289 | 0.050 | tINS | RR | 1 | R51C54[2][B] | u_score_store_sd/controller/page_reader/n552_s69/COUT
9.289 | 0.000 | tNET | RR | 2 | R51C55[0][A] | u_score_store_sd/controller/page_reader/n552_s70/CIN
9.339 | 0.050 | tINS | RR | 1 | R51C55[0][A] | u_score_store_sd/controller/page_reader/n552_s70/COUT
9.339 | 0.000 | tNET | RR | 2 | R51C55[0][B] | u_score_store_sd/controller/page_reader/n552_s71/CIN
9.389 | 0.050 | tINS | RR | 1 | R51C55[0][B] | u_score_store_sd/controller/page_reader/n552_s71/COUT
9.826 | 0.436 | tNET | RR | 1 | R49C55[2][A] | u_score_store_sd/controller/page_reader/n1468_s121/I1
10.287 | 0.461 | tINS | RR | 1 | R49C55[2][A] | u_score_store_sd/controller/page_reader/n1468_s121/F
10.444 | 0.157 | tNET | RR | 1 | R48C55[3][B] | u_score_store_sd/controller/page_reader/n1468_s119/I1
10.942 | 0.498 | tINS | RR | 1 | R48C55[3][B] | u_score_store_sd/controller/page_reader/n1468_s119/F
10.944 | 0.003 | tNET | RR | 1 | R48C55[1][B] | u_score_store_sd/controller/page_reader/n1468_s115/I0
11.471 | 0.526 | tINS | RR | 1 | R48C55[1][B] | u_score_store_sd/controller/page_reader/n1468_s115/F
11.774 | 0.304 | tNET | RR | 1 | R46C55[3][A] | u_score_store_sd/controller/page_reader/n1468_s104/I1
12.296 | 0.521 | tINS | RR | 6 | R46C55[3][A] | u_score_store_sd/controller/page_reader/n1468_s104/F
12.952 | 0.656 | tNET | RR | 1 | R50C55[0][B] | u_score_store_sd/controller/page_reader/n1468_s95/I1
13.478 | 0.526 | tINS | RR | 1 | R50C55[0][B] | u_score_store_sd/controller/page_reader/n1468_s95/F
13.481 | 0.003 | tNET | RR | 1 | R50C55[2][A] | u_score_store_sd/controller/page_reader/n1468_s85/I2
13.997 | 0.516 | tINS | RR | 3 | R50C55[2][A] | u_score_store_sd/controller/page_reader/n1468_s85/F
14.484 | 0.487 | tNET | RR | 1 | R49C54[1][B] | u_score_store_sd/controller/page_reader/n1468_s81/I0
15.001 | 0.516 | tINS | RR | 1 | R49C54[1][B] | u_score_store_sd/controller/page_reader/n1468_s81/F
15.158 | 0.157 | tNET | RR | 1 | R50C54[1][A] | u_score_store_sd/controller/page_reader/n1468_s79/I0
15.674 | 0.516 | tINS | RR | 1 | R50C54[1][A] | u_score_store_sd/controller/page_reader/n1468_s79/F
15.677 | 0.003 | tNET | RR | 1 | R50C54[1][B] | u_score_store_sd/controller/page_reader/n1468_s74/I1
15.939 | 0.262 | tINS | RR | 2 | R50C54[1][B] | u_score_store_sd/controller/page_reader/n1468_s74/F
16.099 | 0.160 | tNET | RR | 1 | R49C54[2][B] | u_score_store_sd/controller/page_reader/n1468_s72/I2
16.626 | 0.526 | tINS | RR | 1 | R49C54[2][B] | u_score_store_sd/controller/page_reader/n1468_s72/F
16.628 | 0.003 | tNET | RR | 1 | R49C54[3][A] | u_score_store_sd/controller/page_reader/n1468_s64/I2
17.126 | 0.498 | tINS | RR | 2 | R49C54[3][A] | u_score_store_sd/controller/page_reader/n1468_s64/F
17.666 | 0.540 | tNET | RR | 1 | R52C54[1][A] | u_score_store_sd/controller/page_reader/n1468_s51/I1
17.928 | 0.262 | tINS | RR | 3 | R52C54[1][A] | u_score_store_sd/controller/page_reader/n1468_s51/F
18.416 | 0.487 | tNET | RR | 1 | R50C53[3][B] | u_score_store_sd/controller/page_reader/n1468_s42/I0
18.913 | 0.498 | tINS | RR | 1 | R50C53[3][B] | u_score_store_sd/controller/page_reader/n1468_s42/F
19.071 | 0.157 | tNET | RR | 1 | R50C52[3][B] | u_score_store_sd/controller/page_reader/n1468_s36/I0
19.592 | 0.521 | tINS | RR | 3 | R50C52[3][B] | u_score_store_sd/controller/page_reader/n1468_s36/F
19.944 | 0.352 | tNET | RR | 1 | R48C52[3][B] | u_score_store_sd/controller/page_reader/n1468_s33/I0
20.442 | 0.498 | tINS | RR | 23 | R48C52[3][B] | u_score_store_sd/controller/page_reader/n1468_s33/F
21.382 | 0.940 | tNET | RR | 1 | R51C51[3][A] | u_score_store_sd/controller/page_reader/stream_count_15_s3/I1
21.879 | 0.498 | tINS | RR | 16 | R51C51[3][A] | u_score_store_sd/controller/page_reader/stream_count_15_s3/F
22.687 | 0.807 | tNET | RR | 1 | R52C57[1][B] | u_score_store_sd/controller/page_reader/stream_count_11_s1/CE

Data Required Path:

AT | DELAY | TYPE | RF | FANOUT | LOC | NODE
20.000 | 20.000 | | | | | active clock edge time
20.000 | 0.000 | | | | | sys_clk
20.000 | 0.000 | tCL | RR | 1 | IOB117[B] | sys_clk_ibuf/I
20.683 | 0.683 | tINS | RR | 13930 | IOB117[B] | sys_clk_ibuf/O
23.853 | 3.171 | tNET | RR | 1 | R52C57[1][B] | u_score_store_sd/controller/page_reader/stream_count_11_s1/CLK
23.542 | -0.311 | tSu | | 1 | R52C57[1][B] | u_score_store_sd/controller/page_reader/stream_count_11_s1

Path Statistics:

Clock Skew | -0.495
Setup Relationship | 20.000
Logic Level | 20
Arrival Clock Path Delay | cell: 0.683, 15.696%; route: 3.666, 84.304%
Arrival Data Path Delay | cell: 8.044, 43.862%; route: 9.913, 54.052%; tC2Q: 0.382, 2.086%
Required Clock Path Delay | cell: 0.683, 17.713%; route: 3.171, 82.287%

### Path15

Path Summary:

Slack | 0.855
Data Arrival Time | 22.687
Data Required Time | 23.542
From | u_score_store_sd/controller/page_reader/indexer/bitmap_offset_0_s1
To | u_score_store_sd/controller/page_reader/stream_count_12_s1
Launch Clk | sys_clk:[R]
Latch Clk | sys_clk:[R]

Data Arrival Path:

AT | DELAY | TYPE | RF | FANOUT | LOC | NODE
0.000 | 0.000 | | | | | active clock edge time
0.000 | 0.000 | | | | | sys_clk
0.000 | 0.000 | tCL | RR | 1 | IOB117[B] | sys_clk_ibuf/I
0.683 | 0.683 | tINS | RR | 13930 | IOB117[B] | sys_clk_ibuf/O
4.348 | 3.666 | tNET | RR | 1 | R35C55[0][A] | u_score_store_sd/controller/page_reader/indexer/bitmap_offset_0_s1/CLK
4.731 | 0.382 | tC2Q | RR | 4 | R35C55[0][A] | u_score_store_sd/controller/page_reader/indexer/bitmap_offset_0_s1/Q
8.989 | 4.259 | tNET | RR | 2 | R51C54[0][A] | u_score_store_sd/controller/page_reader/n552_s64/CIN
9.039 | 0.050 | tINS | RR | 1 | R51C54[0][A] | u_score_store_sd/controller/page_reader/n552_s64/COUT
9.039 | 0.000 | tNET | RR | 2 | R51C54[0][B] | u_score_store_sd/controller/page_reader/n552_s65/CIN
9.089 | 0.050 | tINS | RR | 1 | R51C54[0][B] | u_score_store_sd/controller/page_reader/n552_s65/COUT
9.089 | 0.000 | tNET | RR | 2 | R51C54[1][A] | u_score_store_sd/controller/page_reader/n552_s66/CIN
9.139 | 0.050 | tINS | RR | 1 | R51C54[1][A] | u_score_store_sd/controller/page_reader/n552_s66/COUT
9.139 | 0.000 | tNET | RR | 2 | R51C54[1][B] | u_score_store_sd/controller/page_reader/n552_s67/CIN
9.189 | 0.050 | tINS | RR | 1 | R51C54[1][B] | u_score_store_sd/controller/page_reader/n552_s67/COUT
9.189 | 0.000 | tNET | RR | 2 | R51C54[2][A] | u_score_store_sd/controller/page_reader/n552_s68/CIN
9.239 | 0.050 | tINS | RR | 1 | R51C54[2][A] | u_score_store_sd/controller/page_reader/n552_s68/COUT
9.239 | 0.000 | tNET | RR | 2 | R51C54[2][B] | u_score_store_sd/controller/page_reader/n552_s69/CIN
9.289 | 0.050 | tINS | RR | 1 | R51C54[2][B] | u_score_store_sd/controller/page_reader/n552_s69/COUT
9.289 | 0.000 | tNET | RR | 2 | R51C55[0][A] | u_score_store_sd/controller/page_reader/n552_s70/CIN
9.339 | 0.050 | tINS | RR | 1 | R51C55[0][A] | u_score_store_sd/controller/page_reader/n552_s70/COUT
9.339 | 0.000 | tNET | RR | 2 | R51C55[0][B] | u_score_store_sd/controller/page_reader/n552_s71/CIN
9.389 | 0.050 | tINS | RR | 1 | R51C55[0][B] | u_score_store_sd/controller/page_reader/n552_s71/COUT
9.826 | 0.436 | tNET | RR | 1 | R49C55[2][A] | u_score_store_sd/controller/page_reader/n1468_s121/I1
10.287 | 0.461 | tINS | RR | 1 | R49C55[2][A] | u_score_store_sd/controller/page_reader/n1468_s121/F
10.444 | 0.157 | tNET | RR | 1 | R48C55[3][B] | u_score_store_sd/controller/page_reader/n1468_s119/I1
10.942 | 0.498 | tINS | RR | 1 | R48C55[3][B] | u_score_store_sd/controller/page_reader/n1468_s119/F
10.944 | 0.003 | tNET | RR | 1 | R48C55[1][B] | u_score_store_sd/controller/page_reader/n1468_s115/I0
11.471 | 0.526 | tINS | RR | 1 | R48C55[1][B] | u_score_store_sd/controller/page_reader/n1468_s115/F
11.774 | 0.304 | tNET | RR | 1 | R46C55[3][A] | u_score_store_sd/controller/page_reader/n1468_s104/I1
12.296 | 0.521 | tINS | RR | 6 | R46C55[3][A] | u_score_store_sd/controller/page_reader/n1468_s104/F
12.952 | 0.656 | tNET | RR | 1 | R50C55[0][B] | u_score_store_sd/controller/page_reader/n1468_s95/I1
13.478 | 0.526 | tINS | RR | 1 | R50C55[0][B] | u_score_store_sd/controller/page_reader/n1468_s95/F
13.481 | 0.003 | tNET | RR | 1 | R50C55[2][A] | u_score_store_sd/controller/page_reader/n1468_s85/I2
13.997 | 0.516 | tINS | RR | 3 | R50C55[2][A] | u_score_store_sd/controller/page_reader/n1468_s85/F
14.484 | 0.487 | tNET | RR | 1 | R49C54[1][B] | u_score_store_sd/controller/page_reader/n1468_s81/I0
15.001 | 0.516 | tINS | RR | 1 | R49C54[1][B] | u_score_store_sd/controller/page_reader/n1468_s81/F
15.158 | 0.157 | tNET | RR | 1 | R50C54[1][A] | u_score_store_sd/controller/page_reader/n1468_s79/I0
15.674 | 0.516 | tINS | RR | 1 | R50C54[1][A] | u_score_store_sd/controller/page_reader/n1468_s79/F
15.677 | 0.003 | tNET | RR | 1 | R50C54[1][B] | u_score_store_sd/controller/page_reader/n1468_s74/I1
15.939 | 0.262 | tINS | RR | 2 | R50C54[1][B] | u_score_store_sd/controller/page_reader/n1468_s74/F
16.099 | 0.160 | tNET | RR | 1 | R49C54[2][B] | u_score_store_sd/controller/page_reader/n1468_s72/I2
16.626 | 0.526 | tINS | RR | 1 | R49C54[2][B] | u_score_store_sd/controller/page_reader/n1468_s72/F
16.628 | 0.003 | tNET | RR | 1 | R49C54[3][A] | u_score_store_sd/controller/page_reader/n1468_s64/I2
17.126 | 0.498 | tINS | RR | 2 | R49C54[3][A] | u_score_store_sd/controller/page_reader/n1468_s64/F
17.666 | 0.540 | tNET | RR | 1 | R52C54[1][A] | u_score_store_sd/controller/page_reader/n1468_s51/I1
17.928 | 0.262 | tINS | RR | 3 | R52C54[1][A] | u_score_store_sd/controller/page_reader/n1468_s51/F
18.416 | 0.487 | tNET | RR | 1 | R50C53[3][B] | u_score_store_sd/controller/page_reader/n1468_s42/I0
18.913 | 0.498 | tINS | RR | 1 | R50C53[3][B] | u_score_store_sd/controller/page_reader/n1468_s42/F
19.071 | 0.157 | tNET | RR | 1 | R50C52[3][B] | u_score_store_sd/controller/page_reader/n1468_s36/I0
19.592 | 0.521 | tINS | RR | 3 | R50C52[3][B] | u_score_store_sd/controller/page_reader/n1468_s36/F
19.944 | 0.352 | tNET | RR | 1 | R48C52[3][B] | u_score_store_sd/controller/page_reader/n1468_s33/I0
20.442 | 0.498 | tINS | RR | 23 | R48C52[3][B] | u_score_store_sd/controller/page_reader/n1468_s33/F
21.382 | 0.940 | tNET | RR | 1 | R51C51[3][A] | u_score_store_sd/controller/page_reader/stream_count_15_s3/I1
21.879 | 0.498 | tINS | RR | 16 | R51C51[3][A] | u_score_store_sd/controller/page_reader/stream_count_15_s3/F
22.687 | 0.807 | tNET | RR | 1 | R52C57[2][A] | u_score_store_sd/controller/page_reader/stream_count_12_s1/CE

Data Required Path:

AT | DELAY | TYPE | RF | FANOUT | LOC | NODE
20.000 | 20.000 | | | | | active clock edge time
20.000 | 0.000 | | | | | sys_clk
20.000 | 0.000 | tCL | RR | 1 | IOB117[B] | sys_clk_ibuf/I
20.683 | 0.683 | tINS | RR | 13930 | IOB117[B] | sys_clk_ibuf/O
23.853 | 3.171 | tNET | RR | 1 | R52C57[2][A] | u_score_store_sd/controller/page_reader/stream_count_12_s1/CLK
23.542 | -0.311 | tSu | | 1 | R52C57[2][A] | u_score_store_sd/controller/page_reader/stream_count_12_s1

Path Statistics:

Clock Skew | -0.495
Setup Relationship | 20.000
Logic Level | 20
Arrival Clock Path Delay | cell: 0.683, 15.696%; route: 3.666, 84.304%
Arrival Data Path Delay | cell: 8.044, 43.862%; route: 9.913, 54.052%; tC2Q: 0.382, 2.086%
Required Clock Path Delay | cell: 0.683, 17.713%; route: 3.171, 82.287%

### Path16

Path Summary:

Slack | 0.864
Data Arrival Time | 22.687
Data Required Time | 23.551
From | u_score_store_sd/controller/page_reader/indexer/bitmap_offset_0_s1
To | u_score_store_sd/controller/page_reader/stream_count_0_s1
Launch Clk | sys_clk:[R]
Latch Clk | sys_clk:[R]

Data Arrival Path:

AT | DELAY | TYPE | RF | FANOUT | LOC | NODE
0.000 | 0.000 | | | | | active clock edge time
0.000 | 0.000 | | | | | sys_clk
0.000 | 0.000 | tCL | RR | 1 | IOB117[B] | sys_clk_ibuf/I
0.683 | 0.683 | tINS | RR | 13930 | IOB117[B] | sys_clk_ibuf/O
4.348 | 3.666 | tNET | RR | 1 | R35C55[0][A] | u_score_store_sd/controller/page_reader/indexer/bitmap_offset_0_s1/CLK
4.731 | 0.382 | tC2Q | RR | 4 | R35C55[0][A] | u_score_store_sd/controller/page_reader/indexer/bitmap_offset_0_s1/Q
8.989 | 4.259 | tNET | RR | 2 | R51C54[0][A] | u_score_store_sd/controller/page_reader/n552_s64/CIN
9.039 | 0.050 | tINS | RR | 1 | R51C54[0][A] | u_score_store_sd/controller/page_reader/n552_s64/COUT
9.039 | 0.000 | tNET | RR | 2 | R51C54[0][B] | u_score_store_sd/controller/page_reader/n552_s65/CIN
9.089 | 0.050 | tINS | RR | 1 | R51C54[0][B] | u_score_store_sd/controller/page_reader/n552_s65/COUT
9.089 | 0.000 | tNET | RR | 2 | R51C54[1][A] | u_score_store_sd/controller/page_reader/n552_s66/CIN
9.139 | 0.050 | tINS | RR | 1 | R51C54[1][A] | u_score_store_sd/controller/page_reader/n552_s66/COUT
9.139 | 0.000 | tNET | RR | 2 | R51C54[1][B] | u_score_store_sd/controller/page_reader/n552_s67/CIN
9.189 | 0.050 | tINS | RR | 1 | R51C54[1][B] | u_score_store_sd/controller/page_reader/n552_s67/COUT
9.189 | 0.000 | tNET | RR | 2 | R51C54[2][A] | u_score_store_sd/controller/page_reader/n552_s68/CIN
9.239 | 0.050 | tINS | RR | 1 | R51C54[2][A] | u_score_store_sd/controller/page_reader/n552_s68/COUT
9.239 | 0.000 | tNET | RR | 2 | R51C54[2][B] | u_score_store_sd/controller/page_reader/n552_s69/CIN
9.289 | 0.050 | tINS | RR | 1 | R51C54[2][B] | u_score_store_sd/controller/page_reader/n552_s69/COUT
9.289 | 0.000 | tNET | RR | 2 | R51C55[0][A] | u_score_store_sd/controller/page_reader/n552_s70/CIN
9.339 | 0.050 | tINS | RR | 1 | R51C55[0][A] | u_score_store_sd/controller/page_reader/n552_s70/COUT
9.339 | 0.000 | tNET | RR | 2 | R51C55[0][B] | u_score_store_sd/controller/page_reader/n552_s71/CIN
9.389 | 0.050 | tINS | RR | 1 | R51C55[0][B] | u_score_store_sd/controller/page_reader/n552_s71/COUT
9.826 | 0.436 | tNET | RR | 1 | R49C55[2][A] | u_score_store_sd/controller/page_reader/n1468_s121/I1
10.287 | 0.461 | tINS | RR | 1 | R49C55[2][A] | u_score_store_sd/controller/page_reader/n1468_s121/F
10.444 | 0.157 | tNET | RR | 1 | R48C55[3][B] | u_score_store_sd/controller/page_reader/n1468_s119/I1
10.942 | 0.498 | tINS | RR | 1 | R48C55[3][B] | u_score_store_sd/controller/page_reader/n1468_s119/F
10.944 | 0.003 | tNET | RR | 1 | R48C55[1][B] | u_score_store_sd/controller/page_reader/n1468_s115/I0
11.471 | 0.526 | tINS | RR | 1 | R48C55[1][B] | u_score_store_sd/controller/page_reader/n1468_s115/F
11.774 | 0.304 | tNET | RR | 1 | R46C55[3][A] | u_score_store_sd/controller/page_reader/n1468_s104/I1
12.296 | 0.521 | tINS | RR | 6 | R46C55[3][A] | u_score_store_sd/controller/page_reader/n1468_s104/F
12.952 | 0.656 | tNET | RR | 1 | R50C55[0][B] | u_score_store_sd/controller/page_reader/n1468_s95/I1
13.478 | 0.526 | tINS | RR | 1 | R50C55[0][B] | u_score_store_sd/controller/page_reader/n1468_s95/F
13.481 | 0.003 | tNET | RR | 1 | R50C55[2][A] | u_score_store_sd/controller/page_reader/n1468_s85/I2
13.997 | 0.516 | tINS | RR | 3 | R50C55[2][A] | u_score_store_sd/controller/page_reader/n1468_s85/F
14.484 | 0.487 | tNET | RR | 1 | R49C54[1][B] | u_score_store_sd/controller/page_reader/n1468_s81/I0
15.001 | 0.516 | tINS | RR | 1 | R49C54[1][B] | u_score_store_sd/controller/page_reader/n1468_s81/F
15.158 | 0.157 | tNET | RR | 1 | R50C54[1][A] | u_score_store_sd/controller/page_reader/n1468_s79/I0
15.674 | 0.516 | tINS | RR | 1 | R50C54[1][A] | u_score_store_sd/controller/page_reader/n1468_s79/F
15.677 | 0.003 | tNET | RR | 1 | R50C54[1][B] | u_score_store_sd/controller/page_reader/n1468_s74/I1
15.939 | 0.262 | tINS | RR | 2 | R50C54[1][B] | u_score_store_sd/controller/page_reader/n1468_s74/F
16.099 | 0.160 | tNET | RR | 1 | R49C54[2][B] | u_score_store_sd/controller/page_reader/n1468_s72/I2
16.626 | 0.526 | tINS | RR | 1 | R49C54[2][B] | u_score_store_sd/controller/page_reader/n1468_s72/F
16.628 | 0.003 | tNET | RR | 1 | R49C54[3][A] | u_score_store_sd/controller/page_reader/n1468_s64/I2
17.126 | 0.498 | tINS | RR | 2 | R49C54[3][A] | u_score_store_sd/controller/page_reader/n1468_s64/F
17.666 | 0.540 | tNET | RR | 1 | R52C54[1][A] | u_score_store_sd/controller/page_reader/n1468_s51/I1
17.928 | 0.262 | tINS | RR | 3 | R52C54[1][A] | u_score_store_sd/controller/page_reader/n1468_s51/F
18.416 | 0.487 | tNET | RR | 1 | R50C53[3][B] | u_score_store_sd/controller/page_reader/n1468_s42/I0
18.913 | 0.498 | tINS | RR | 1 | R50C53[3][B] | u_score_store_sd/controller/page_reader/n1468_s42/F
19.071 | 0.157 | tNET | RR | 1 | R50C52[3][B] | u_score_store_sd/controller/page_reader/n1468_s36/I0
19.592 | 0.521 | tINS | RR | 3 | R50C52[3][B] | u_score_store_sd/controller/page_reader/n1468_s36/F
19.944 | 0.352 | tNET | RR | 1 | R48C52[3][B] | u_score_store_sd/controller/page_reader/n1468_s33/I0
20.442 | 0.498 | tINS | RR | 23 | R48C52[3][B] | u_score_store_sd/controller/page_reader/n1468_s33/F
21.382 | 0.940 | tNET | RR | 1 | R51C51[3][A] | u_score_store_sd/controller/page_reader/stream_count_15_s3/I1
21.879 | 0.498 | tINS | RR | 16 | R51C51[3][A] | u_score_store_sd/controller/page_reader/stream_count_15_s3/F
22.687 | 0.807 | tNET | RR | 1 | R52C56[1][A] | u_score_store_sd/controller/page_reader/stream_count_0_s1/CE

Data Required Path:

AT | DELAY | TYPE | RF | FANOUT | LOC | NODE
20.000 | 20.000 | | | | | active clock edge time
20.000 | 0.000 | | | | | sys_clk
20.000 | 0.000 | tCL | RR | 1 | IOB117[B] | sys_clk_ibuf/I
20.683 | 0.683 | tINS | RR | 13930 | IOB117[B] | sys_clk_ibuf/O
23.862 | 3.180 | tNET | RR | 1 | R52C56[1][A] | u_score_store_sd/controller/page_reader/stream_count_0_s1/CLK
23.551 | -0.311 | tSu | | 1 | R52C56[1][A] | u_score_store_sd/controller/page_reader/stream_count_0_s1

Path Statistics:

Clock Skew | -0.486
Setup Relationship | 20.000
Logic Level | 20
Arrival Clock Path Delay | cell: 0.683, 15.696%; route: 3.666, 84.304%
Arrival Data Path Delay | cell: 8.044, 43.862%; route: 9.913, 54.052%; tC2Q: 0.382, 2.086%
Required Clock Path Delay | cell: 0.683, 17.670%; route: 3.180, 82.330%

### Path17

Path Summary:

Slack | 0.864
Data Arrival Time | 22.687
Data Required Time | 23.551
From | u_score_store_sd/controller/page_reader/indexer/bitmap_offset_0_s1
To | u_score_store_sd/controller/page_reader/stream_count_15_s1
Launch Clk | sys_clk:[R]
Latch Clk | sys_clk:[R]

Data Arrival Path:

AT | DELAY | TYPE | RF | FANOUT | LOC | NODE
0.000 | 0.000 | | | | | active clock edge time
0.000 | 0.000 | | | | | sys_clk
0.000 | 0.000 | tCL | RR | 1 | IOB117[B] | sys_clk_ibuf/I
0.683 | 0.683 | tINS | RR | 13930 | IOB117[B] | sys_clk_ibuf/O
4.348 | 3.666 | tNET | RR | 1 | R35C55[0][A] | u_score_store_sd/controller/page_reader/indexer/bitmap_offset_0_s1/CLK
4.731 | 0.382 | tC2Q | RR | 4 | R35C55[0][A] | u_score_store_sd/controller/page_reader/indexer/bitmap_offset_0_s1/Q
8.989 | 4.259 | tNET | RR | 2 | R51C54[0][A] | u_score_store_sd/controller/page_reader/n552_s64/CIN
9.039 | 0.050 | tINS | RR | 1 | R51C54[0][A] | u_score_store_sd/controller/page_reader/n552_s64/COUT
9.039 | 0.000 | tNET | RR | 2 | R51C54[0][B] | u_score_store_sd/controller/page_reader/n552_s65/CIN
9.089 | 0.050 | tINS | RR | 1 | R51C54[0][B] | u_score_store_sd/controller/page_reader/n552_s65/COUT
9.089 | 0.000 | tNET | RR | 2 | R51C54[1][A] | u_score_store_sd/controller/page_reader/n552_s66/CIN
9.139 | 0.050 | tINS | RR | 1 | R51C54[1][A] | u_score_store_sd/controller/page_reader/n552_s66/COUT
9.139 | 0.000 | tNET | RR | 2 | R51C54[1][B] | u_score_store_sd/controller/page_reader/n552_s67/CIN
9.189 | 0.050 | tINS | RR | 1 | R51C54[1][B] | u_score_store_sd/controller/page_reader/n552_s67/COUT
9.189 | 0.000 | tNET | RR | 2 | R51C54[2][A] | u_score_store_sd/controller/page_reader/n552_s68/CIN
9.239 | 0.050 | tINS | RR | 1 | R51C54[2][A] | u_score_store_sd/controller/page_reader/n552_s68/COUT
9.239 | 0.000 | tNET | RR | 2 | R51C54[2][B] | u_score_store_sd/controller/page_reader/n552_s69/CIN
9.289 | 0.050 | tINS | RR | 1 | R51C54[2][B] | u_score_store_sd/controller/page_reader/n552_s69/COUT
9.289 | 0.000 | tNET | RR | 2 | R51C55[0][A] | u_score_store_sd/controller/page_reader/n552_s70/CIN
9.339 | 0.050 | tINS | RR | 1 | R51C55[0][A] | u_score_store_sd/controller/page_reader/n552_s70/COUT
9.339 | 0.000 | tNET | RR | 2 | R51C55[0][B] | u_score_store_sd/controller/page_reader/n552_s71/CIN
9.389 | 0.050 | tINS | RR | 1 | R51C55[0][B] | u_score_store_sd/controller/page_reader/n552_s71/COUT
9.826 | 0.436 | tNET | RR | 1 | R49C55[2][A] | u_score_store_sd/controller/page_reader/n1468_s121/I1
10.287 | 0.461 | tINS | RR | 1 | R49C55[2][A] | u_score_store_sd/controller/page_reader/n1468_s121/F
10.444 | 0.157 | tNET | RR | 1 | R48C55[3][B] | u_score_store_sd/controller/page_reader/n1468_s119/I1
10.942 | 0.498 | tINS | RR | 1 | R48C55[3][B] | u_score_store_sd/controller/page_reader/n1468_s119/F
10.944 | 0.003 | tNET | RR | 1 | R48C55[1][B] | u_score_store_sd/controller/page_reader/n1468_s115/I0
11.471 | 0.526 | tINS | RR | 1 | R48C55[1][B] | u_score_store_sd/controller/page_reader/n1468_s115/F
11.774 | 0.304 | tNET | RR | 1 | R46C55[3][A] | u_score_store_sd/controller/page_reader/n1468_s104/I1
12.296 | 0.521 | tINS | RR | 6 | R46C55[3][A] | u_score_store_sd/controller/page_reader/n1468_s104/F
12.952 | 0.656 | tNET | RR | 1 | R50C55[0][B] | u_score_store_sd/controller/page_reader/n1468_s95/I1
13.478 | 0.526 | tINS | RR | 1 | R50C55[0][B] | u_score_store_sd/controller/page_reader/n1468_s95/F
13.481 | 0.003 | tNET | RR | 1 | R50C55[2][A] | u_score_store_sd/controller/page_reader/n1468_s85/I2
13.997 | 0.516 | tINS | RR | 3 | R50C55[2][A] | u_score_store_sd/controller/page_reader/n1468_s85/F
14.484 | 0.487 | tNET | RR | 1 | R49C54[1][B] | u_score_store_sd/controller/page_reader/n1468_s81/I0
15.001 | 0.516 | tINS | RR | 1 | R49C54[1][B] | u_score_store_sd/controller/page_reader/n1468_s81/F
15.158 | 0.157 | tNET | RR | 1 | R50C54[1][A] | u_score_store_sd/controller/page_reader/n1468_s79/I0
15.674 | 0.516 | tINS | RR | 1 | R50C54[1][A] | u_score_store_sd/controller/page_reader/n1468_s79/F
15.677 | 0.003 | tNET | RR | 1 | R50C54[1][B] | u_score_store_sd/controller/page_reader/n1468_s74/I1
15.939 | 0.262 | tINS | RR | 2 | R50C54[1][B] | u_score_store_sd/controller/page_reader/n1468_s74/F
16.099 | 0.160 | tNET | RR | 1 | R49C54[2][B] | u_score_store_sd/controller/page_reader/n1468_s72/I2
16.626 | 0.526 | tINS | RR | 1 | R49C54[2][B] | u_score_store_sd/controller/page_reader/n1468_s72/F
16.628 | 0.003 | tNET | RR | 1 | R49C54[3][A] | u_score_store_sd/controller/page_reader/n1468_s64/I2
17.126 | 0.498 | tINS | RR | 2 | R49C54[3][A] | u_score_store_sd/controller/page_reader/n1468_s64/F
17.666 | 0.540 | tNET | RR | 1 | R52C54[1][A] | u_score_store_sd/controller/page_reader/n1468_s51/I1
17.928 | 0.262 | tINS | RR | 3 | R52C54[1][A] | u_score_store_sd/controller/page_reader/n1468_s51/F
18.416 | 0.487 | tNET | RR | 1 | R50C53[3][B] | u_score_store_sd/controller/page_reader/n1468_s42/I0
18.913 | 0.498 | tINS | RR | 1 | R50C53[3][B] | u_score_store_sd/controller/page_reader/n1468_s42/F
19.071 | 0.157 | tNET | RR | 1 | R50C52[3][B] | u_score_store_sd/controller/page_reader/n1468_s36/I0
19.592 | 0.521 | tINS | RR | 3 | R50C52[3][B] | u_score_store_sd/controller/page_reader/n1468_s36/F
19.944 | 0.352 | tNET | RR | 1 | R48C52[3][B] | u_score_store_sd/controller/page_reader/n1468_s33/I0
20.442 | 0.498 | tINS | RR | 23 | R48C52[3][B] | u_score_store_sd/controller/page_reader/n1468_s33/F
21.382 | 0.940 | tNET | RR | 1 | R51C51[3][A] | u_score_store_sd/controller/page_reader/stream_count_15_s3/I1
21.879 | 0.498 | tINS | RR | 16 | R51C51[3][A] | u_score_store_sd/controller/page_reader/stream_count_15_s3/F
22.687 | 0.807 | tNET | RR | 1 | R52C56[1][B] | u_score_store_sd/controller/page_reader/stream_count_15_s1/CE

Data Required Path:

AT | DELAY | TYPE | RF | FANOUT | LOC | NODE
20.000 | 20.000 | | | | | active clock edge time
20.000 | 0.000 | | | | | sys_clk
20.000 | 0.000 | tCL | RR | 1 | IOB117[B] | sys_clk_ibuf/I
20.683 | 0.683 | tINS | RR | 13930 | IOB117[B] | sys_clk_ibuf/O
23.862 | 3.180 | tNET | RR | 1 | R52C56[1][B] | u_score_store_sd/controller/page_reader/stream_count_15_s1/CLK
23.551 | -0.311 | tSu | | 1 | R52C56[1][B] | u_score_store_sd/controller/page_reader/stream_count_15_s1

Path Statistics:

Clock Skew | -0.486
Setup Relationship | 20.000
Logic Level | 20
Arrival Clock Path Delay | cell: 0.683, 15.696%; route: 3.666, 84.304%
Arrival Data Path Delay | cell: 8.044, 43.862%; route: 9.913, 54.052%; tC2Q: 0.382, 2.086%
Required Clock Path Delay | cell: 0.683, 17.670%; route: 3.180, 82.330%

### Path18

Path Summary:

Slack | 1.076
Data Arrival Time | 22.713
Data Required Time | 23.789
From | u_score_store_sd/controller/page_reader/indexer/bitmap_offset_0_s1
To | u_score_store_sd/controller/page_reader/sector_index_12_s1
Launch Clk | sys_clk:[R]
Latch Clk | sys_clk:[R]

Data Arrival Path:

AT | DELAY | TYPE | RF | FANOUT | LOC | NODE
0.000 | 0.000 | | | | | active clock edge time
0.000 | 0.000 | | | | | sys_clk
0.000 | 0.000 | tCL | RR | 1 | IOB117[B] | sys_clk_ibuf/I
0.683 | 0.683 | tINS | RR | 13930 | IOB117[B] | sys_clk_ibuf/O
4.348 | 3.666 | tNET | RR | 1 | R35C55[0][A] | u_score_store_sd/controller/page_reader/indexer/bitmap_offset_0_s1/CLK
4.731 | 0.382 | tC2Q | RR | 4 | R35C55[0][A] | u_score_store_sd/controller/page_reader/indexer/bitmap_offset_0_s1/Q
8.989 | 4.259 | tNET | RR | 2 | R51C54[0][A] | u_score_store_sd/controller/page_reader/n552_s64/CIN
9.039 | 0.050 | tINS | RR | 1 | R51C54[0][A] | u_score_store_sd/controller/page_reader/n552_s64/COUT
9.039 | 0.000 | tNET | RR | 2 | R51C54[0][B] | u_score_store_sd/controller/page_reader/n552_s65/CIN
9.089 | 0.050 | tINS | RR | 1 | R51C54[0][B] | u_score_store_sd/controller/page_reader/n552_s65/COUT
9.089 | 0.000 | tNET | RR | 2 | R51C54[1][A] | u_score_store_sd/controller/page_reader/n552_s66/CIN
9.139 | 0.050 | tINS | RR | 1 | R51C54[1][A] | u_score_store_sd/controller/page_reader/n552_s66/COUT
9.139 | 0.000 | tNET | RR | 2 | R51C54[1][B] | u_score_store_sd/controller/page_reader/n552_s67/CIN
9.189 | 0.050 | tINS | RR | 1 | R51C54[1][B] | u_score_store_sd/controller/page_reader/n552_s67/COUT
9.189 | 0.000 | tNET | RR | 2 | R51C54[2][A] | u_score_store_sd/controller/page_reader/n552_s68/CIN
9.239 | 0.050 | tINS | RR | 1 | R51C54[2][A] | u_score_store_sd/controller/page_reader/n552_s68/COUT
9.239 | 0.000 | tNET | RR | 2 | R51C54[2][B] | u_score_store_sd/controller/page_reader/n552_s69/CIN
9.289 | 0.050 | tINS | RR | 1 | R51C54[2][B] | u_score_store_sd/controller/page_reader/n552_s69/COUT
9.289 | 0.000 | tNET | RR | 2 | R51C55[0][A] | u_score_store_sd/controller/page_reader/n552_s70/CIN
9.339 | 0.050 | tINS | RR | 1 | R51C55[0][A] | u_score_store_sd/controller/page_reader/n552_s70/COUT
9.339 | 0.000 | tNET | RR | 2 | R51C55[0][B] | u_score_store_sd/controller/page_reader/n552_s71/CIN
9.389 | 0.050 | tINS | RR | 1 | R51C55[0][B] | u_score_store_sd/controller/page_reader/n552_s71/COUT
9.826 | 0.436 | tNET | RR | 1 | R49C55[2][A] | u_score_store_sd/controller/page_reader/n1468_s121/I1
10.287 | 0.461 | tINS | RR | 1 | R49C55[2][A] | u_score_store_sd/controller/page_reader/n1468_s121/F
10.444 | 0.157 | tNET | RR | 1 | R48C55[3][B] | u_score_store_sd/controller/page_reader/n1468_s119/I1
10.942 | 0.498 | tINS | RR | 1 | R48C55[3][B] | u_score_store_sd/controller/page_reader/n1468_s119/F
10.944 | 0.003 | tNET | RR | 1 | R48C55[1][B] | u_score_store_sd/controller/page_reader/n1468_s115/I0
11.471 | 0.526 | tINS | RR | 1 | R48C55[1][B] | u_score_store_sd/controller/page_reader/n1468_s115/F
11.774 | 0.304 | tNET | RR | 1 | R46C55[3][A] | u_score_store_sd/controller/page_reader/n1468_s104/I1
12.296 | 0.521 | tINS | RR | 6 | R46C55[3][A] | u_score_store_sd/controller/page_reader/n1468_s104/F
12.952 | 0.656 | tNET | RR | 1 | R50C55[0][B] | u_score_store_sd/controller/page_reader/n1468_s95/I1
13.478 | 0.526 | tINS | RR | 1 | R50C55[0][B] | u_score_store_sd/controller/page_reader/n1468_s95/F
13.481 | 0.003 | tNET | RR | 1 | R50C55[2][A] | u_score_store_sd/controller/page_reader/n1468_s85/I2
13.997 | 0.516 | tINS | RR | 3 | R50C55[2][A] | u_score_store_sd/controller/page_reader/n1468_s85/F
14.484 | 0.487 | tNET | RR | 1 | R49C54[1][B] | u_score_store_sd/controller/page_reader/n1468_s81/I0
15.001 | 0.516 | tINS | RR | 1 | R49C54[1][B] | u_score_store_sd/controller/page_reader/n1468_s81/F
15.158 | 0.157 | tNET | RR | 1 | R50C54[1][A] | u_score_store_sd/controller/page_reader/n1468_s79/I0
15.674 | 0.516 | tINS | RR | 1 | R50C54[1][A] | u_score_store_sd/controller/page_reader/n1468_s79/F
15.677 | 0.003 | tNET | RR | 1 | R50C54[1][B] | u_score_store_sd/controller/page_reader/n1468_s74/I1
15.939 | 0.262 | tINS | RR | 2 | R50C54[1][B] | u_score_store_sd/controller/page_reader/n1468_s74/F
16.099 | 0.160 | tNET | RR | 1 | R49C54[2][B] | u_score_store_sd/controller/page_reader/n1468_s72/I2
16.626 | 0.526 | tINS | RR | 1 | R49C54[2][B] | u_score_store_sd/controller/page_reader/n1468_s72/F
16.628 | 0.003 | tNET | RR | 1 | R49C54[3][A] | u_score_store_sd/controller/page_reader/n1468_s64/I2
17.126 | 0.498 | tINS | RR | 2 | R49C54[3][A] | u_score_store_sd/controller/page_reader/n1468_s64/F
17.666 | 0.540 | tNET | RR | 1 | R52C54[1][A] | u_score_store_sd/controller/page_reader/n1468_s51/I1
17.928 | 0.262 | tINS | RR | 3 | R52C54[1][A] | u_score_store_sd/controller/page_reader/n1468_s51/F
18.416 | 0.487 | tNET | RR | 1 | R50C53[3][B] | u_score_store_sd/controller/page_reader/n1468_s42/I0
18.913 | 0.498 | tINS | RR | 1 | R50C53[3][B] | u_score_store_sd/controller/page_reader/n1468_s42/F
19.071 | 0.157 | tNET | RR | 1 | R50C52[3][B] | u_score_store_sd/controller/page_reader/n1468_s36/I0
19.592 | 0.521 | tINS | RR | 3 | R50C52[3][B] | u_score_store_sd/controller/page_reader/n1468_s36/F
19.944 | 0.352 | tNET | RR | 1 | R48C52[2][B] | u_score_store_sd/controller/page_reader/n1482_s38/I0
20.471 | 0.526 | tINS | RR | 11 | R48C52[2][B] | u_score_store_sd/controller/page_reader/n1482_s38/F
21.523 | 1.053 | tNET | RR | 1 | R50C56[1][B] | u_score_store_sd/controller/page_reader/n1482_s33/I1
22.039 | 0.516 | tINS | RR | 1 | R50C56[1][B] | u_score_store_sd/controller/page_reader/n1482_s33/F
22.197 | 0.157 | tNET | RR | 1 | R50C57[0][A] | u_score_store_sd/controller/page_reader/n1482_s31/I1
22.713 | 0.516 | tINS | RR | 1 | R50C57[0][A] | u_score_store_sd/controller/page_reader/n1482_s31/F
22.713 | 0.000 | tNET | RR | 1 | R50C57[0][A] | u_score_store_sd/controller/page_reader/sector_index_12_s1/D

Data Required Path:

AT | DELAY | TYPE | RF | FANOUT | LOC | NODE
20.000 | 20.000 | | | | | active clock edge time
20.000 | 0.000 | | | | | sys_clk
20.000 | 0.000 | tCL | RR | 1 | IOB117[B] | sys_clk_ibuf/I
20.683 | 0.683 | tINS | RR | 13930 | IOB117[B] | sys_clk_ibuf/O
23.853 | 3.171 | tNET | RR | 1 | R50C57[0][A] | u_score_store_sd/controller/page_reader/sector_index_12_s1/CLK
23.789 | -0.064 | tSu | | 1 | R50C57[0][A] | u_score_store_sd/controller/page_reader/sector_index_12_s1

Path Statistics:

Clock Skew | -0.495
Setup Relationship | 20.000
Logic Level | 21
Arrival Clock Path Delay | cell: 0.683, 15.696%; route: 3.666, 84.304%
Arrival Data Path Delay | cell: 8.607, 46.869%; route: 9.375, 51.048%; tC2Q: 0.382, 2.083%
Required Clock Path Delay | cell: 0.683, 17.713%; route: 3.171, 82.287%

### Path19

Path Summary:

Slack | 1.134
Data Arrival Time | 22.408
Data Required Time | 23.542
From | u_score_store_sd/controller/page_reader/indexer/bitmap_offset_0_s1
To | u_score_store_sd/controller/page_reader/byte_index_7_s1
Launch Clk | sys_clk:[R]
Latch Clk | sys_clk:[R]

Data Arrival Path:

AT | DELAY | TYPE | RF | FANOUT | LOC | NODE
0.000 | 0.000 | | | | | active clock edge time
0.000 | 0.000 | | | | | sys_clk
0.000 | 0.000 | tCL | RR | 1 | IOB117[B] | sys_clk_ibuf/I
0.683 | 0.683 | tINS | RR | 13930 | IOB117[B] | sys_clk_ibuf/O
4.348 | 3.666 | tNET | RR | 1 | R35C55[0][A] | u_score_store_sd/controller/page_reader/indexer/bitmap_offset_0_s1/CLK
4.731 | 0.382 | tC2Q | RR | 4 | R35C55[0][A] | u_score_store_sd/controller/page_reader/indexer/bitmap_offset_0_s1/Q
8.989 | 4.259 | tNET | RR | 2 | R51C54[0][A] | u_score_store_sd/controller/page_reader/n552_s64/CIN
9.039 | 0.050 | tINS | RR | 1 | R51C54[0][A] | u_score_store_sd/controller/page_reader/n552_s64/COUT
9.039 | 0.000 | tNET | RR | 2 | R51C54[0][B] | u_score_store_sd/controller/page_reader/n552_s65/CIN
9.089 | 0.050 | tINS | RR | 1 | R51C54[0][B] | u_score_store_sd/controller/page_reader/n552_s65/COUT
9.089 | 0.000 | tNET | RR | 2 | R51C54[1][A] | u_score_store_sd/controller/page_reader/n552_s66/CIN
9.139 | 0.050 | tINS | RR | 1 | R51C54[1][A] | u_score_store_sd/controller/page_reader/n552_s66/COUT
9.139 | 0.000 | tNET | RR | 2 | R51C54[1][B] | u_score_store_sd/controller/page_reader/n552_s67/CIN
9.189 | 0.050 | tINS | RR | 1 | R51C54[1][B] | u_score_store_sd/controller/page_reader/n552_s67/COUT
9.189 | 0.000 | tNET | RR | 2 | R51C54[2][A] | u_score_store_sd/controller/page_reader/n552_s68/CIN
9.239 | 0.050 | tINS | RR | 1 | R51C54[2][A] | u_score_store_sd/controller/page_reader/n552_s68/COUT
9.239 | 0.000 | tNET | RR | 2 | R51C54[2][B] | u_score_store_sd/controller/page_reader/n552_s69/CIN
9.289 | 0.050 | tINS | RR | 1 | R51C54[2][B] | u_score_store_sd/controller/page_reader/n552_s69/COUT
9.289 | 0.000 | tNET | RR | 2 | R51C55[0][A] | u_score_store_sd/controller/page_reader/n552_s70/CIN
9.339 | 0.050 | tINS | RR | 1 | R51C55[0][A] | u_score_store_sd/controller/page_reader/n552_s70/COUT
9.339 | 0.000 | tNET | RR | 2 | R51C55[0][B] | u_score_store_sd/controller/page_reader/n552_s71/CIN
9.389 | 0.050 | tINS | RR | 1 | R51C55[0][B] | u_score_store_sd/controller/page_reader/n552_s71/COUT
9.826 | 0.436 | tNET | RR | 1 | R49C55[2][A] | u_score_store_sd/controller/page_reader/n1468_s121/I1
10.287 | 0.461 | tINS | RR | 1 | R49C55[2][A] | u_score_store_sd/controller/page_reader/n1468_s121/F
10.444 | 0.157 | tNET | RR | 1 | R48C55[3][B] | u_score_store_sd/controller/page_reader/n1468_s119/I1
10.942 | 0.498 | tINS | RR | 1 | R48C55[3][B] | u_score_store_sd/controller/page_reader/n1468_s119/F
10.944 | 0.003 | tNET | RR | 1 | R48C55[1][B] | u_score_store_sd/controller/page_reader/n1468_s115/I0
11.471 | 0.526 | tINS | RR | 1 | R48C55[1][B] | u_score_store_sd/controller/page_reader/n1468_s115/F
11.774 | 0.304 | tNET | RR | 1 | R46C55[3][A] | u_score_store_sd/controller/page_reader/n1468_s104/I1
12.296 | 0.521 | tINS | RR | 6 | R46C55[3][A] | u_score_store_sd/controller/page_reader/n1468_s104/F
12.952 | 0.656 | tNET | RR | 1 | R50C55[0][B] | u_score_store_sd/controller/page_reader/n1468_s95/I1
13.478 | 0.526 | tINS | RR | 1 | R50C55[0][B] | u_score_store_sd/controller/page_reader/n1468_s95/F
13.481 | 0.003 | tNET | RR | 1 | R50C55[2][A] | u_score_store_sd/controller/page_reader/n1468_s85/I2
13.997 | 0.516 | tINS | RR | 3 | R50C55[2][A] | u_score_store_sd/controller/page_reader/n1468_s85/F
14.484 | 0.487 | tNET | RR | 1 | R49C54[1][B] | u_score_store_sd/controller/page_reader/n1468_s81/I0
15.001 | 0.516 | tINS | RR | 1 | R49C54[1][B] | u_score_store_sd/controller/page_reader/n1468_s81/F
15.158 | 0.157 | tNET | RR | 1 | R50C54[1][A] | u_score_store_sd/controller/page_reader/n1468_s79/I0
15.674 | 0.516 | tINS | RR | 1 | R50C54[1][A] | u_score_store_sd/controller/page_reader/n1468_s79/F
15.677 | 0.003 | tNET | RR | 1 | R50C54[1][B] | u_score_store_sd/controller/page_reader/n1468_s74/I1
15.939 | 0.262 | tINS | RR | 2 | R50C54[1][B] | u_score_store_sd/controller/page_reader/n1468_s74/F
16.099 | 0.160 | tNET | RR | 1 | R49C54[2][B] | u_score_store_sd/controller/page_reader/n1468_s72/I2
16.626 | 0.526 | tINS | RR | 1 | R49C54[2][B] | u_score_store_sd/controller/page_reader/n1468_s72/F
16.628 | 0.003 | tNET | RR | 1 | R49C54[3][A] | u_score_store_sd/controller/page_reader/n1468_s64/I2
17.126 | 0.498 | tINS | RR | 2 | R49C54[3][A] | u_score_store_sd/controller/page_reader/n1468_s64/F
17.666 | 0.540 | tNET | RR | 1 | R52C54[1][A] | u_score_store_sd/controller/page_reader/n1468_s51/I1
17.928 | 0.262 | tINS | RR | 3 | R52C54[1][A] | u_score_store_sd/controller/page_reader/n1468_s51/F
18.416 | 0.487 | tNET | RR | 1 | R50C53[3][B] | u_score_store_sd/controller/page_reader/n1468_s42/I0
18.913 | 0.498 | tINS | RR | 1 | R50C53[3][B] | u_score_store_sd/controller/page_reader/n1468_s42/F
19.071 | 0.157 | tNET | RR | 1 | R50C52[3][B] | u_score_store_sd/controller/page_reader/n1468_s36/I0
19.592 | 0.521 | tINS | RR | 3 | R50C52[3][B] | u_score_store_sd/controller/page_reader/n1468_s36/F
19.944 | 0.352 | tNET | RR | 1 | R48C52[3][B] | u_score_store_sd/controller/page_reader/n1468_s33/I0
20.442 | 0.498 | tINS | RR | 23 | R48C52[3][B] | u_score_store_sd/controller/page_reader/n1468_s33/F
20.644 | 0.203 | tNET | RR | 1 | R48C51[3][B] | u_score_store_sd/controller/page_reader/n1495_s32/I1
21.142 | 0.498 | tINS | RR | 4 | R48C51[3][B] | u_score_store_sd/controller/page_reader/n1495_s32/F
21.337 | 0.195 | tNET | RR | 1 | R50C51[1][A] | u_score_store_sd/controller/page_reader/byte_index_8_s4/I0
21.863 | 0.526 | tINS | RR | 9 | R50C51[1][A] | u_score_store_sd/controller/page_reader/byte_index_8_s4/F
22.408 | 0.545 | tNET | RR | 1 | R48C49[1][A] | u_score_store_sd/controller/page_reader/byte_index_7_s1/CE

Data Required Path:

AT | DELAY | TYPE | RF | FANOUT | LOC | NODE
20.000 | 20.000 | | | | | active clock edge time
20.000 | 0.000 | | | | | sys_clk
20.000 | 0.000 | tCL | RR | 1 | IOB117[B] | sys_clk_ibuf/I
20.683 | 0.683 | tINS | RR | 13930 | IOB117[B] | sys_clk_ibuf/O
23.853 | 3.171 | tNET | RR | 1 | R48C49[1][A] | u_score_store_sd/controller/page_reader/byte_index_7_s1/CLK
23.542 | -0.311 | tSu | | 1 | R48C49[1][A] | u_score_store_sd/controller/page_reader/byte_index_7_s1

Path Statistics:

Clock Skew | -0.495
Setup Relationship | 20.000
Logic Level | 21
Arrival Clock Path Delay | cell: 0.683, 15.696%; route: 3.666, 84.304%
Arrival Data Path Delay | cell: 8.570, 47.453%; route: 9.108, 50.429%; tC2Q: 0.382, 2.118%
Required Clock Path Delay | cell: 0.683, 17.713%; route: 3.171, 82.287%

### Path20

Path Summary:

Slack | 1.134
Data Arrival Time | 22.408
Data Required Time | 23.542
From | u_score_store_sd/controller/page_reader/indexer/bitmap_offset_0_s1
To | u_score_store_sd/controller/page_reader/byte_index_8_s1
Launch Clk | sys_clk:[R]
Latch Clk | sys_clk:[R]

Data Arrival Path:

AT | DELAY | TYPE | RF | FANOUT | LOC | NODE
0.000 | 0.000 | | | | | active clock edge time
0.000 | 0.000 | | | | | sys_clk
0.000 | 0.000 | tCL | RR | 1 | IOB117[B] | sys_clk_ibuf/I
0.683 | 0.683 | tINS | RR | 13930 | IOB117[B] | sys_clk_ibuf/O
4.348 | 3.666 | tNET | RR | 1 | R35C55[0][A] | u_score_store_sd/controller/page_reader/indexer/bitmap_offset_0_s1/CLK
4.731 | 0.382 | tC2Q | RR | 4 | R35C55[0][A] | u_score_store_sd/controller/page_reader/indexer/bitmap_offset_0_s1/Q
8.989 | 4.259 | tNET | RR | 2 | R51C54[0][A] | u_score_store_sd/controller/page_reader/n552_s64/CIN
9.039 | 0.050 | tINS | RR | 1 | R51C54[0][A] | u_score_store_sd/controller/page_reader/n552_s64/COUT
9.039 | 0.000 | tNET | RR | 2 | R51C54[0][B] | u_score_store_sd/controller/page_reader/n552_s65/CIN
9.089 | 0.050 | tINS | RR | 1 | R51C54[0][B] | u_score_store_sd/controller/page_reader/n552_s65/COUT
9.089 | 0.000 | tNET | RR | 2 | R51C54[1][A] | u_score_store_sd/controller/page_reader/n552_s66/CIN
9.139 | 0.050 | tINS | RR | 1 | R51C54[1][A] | u_score_store_sd/controller/page_reader/n552_s66/COUT
9.139 | 0.000 | tNET | RR | 2 | R51C54[1][B] | u_score_store_sd/controller/page_reader/n552_s67/CIN
9.189 | 0.050 | tINS | RR | 1 | R51C54[1][B] | u_score_store_sd/controller/page_reader/n552_s67/COUT
9.189 | 0.000 | tNET | RR | 2 | R51C54[2][A] | u_score_store_sd/controller/page_reader/n552_s68/CIN
9.239 | 0.050 | tINS | RR | 1 | R51C54[2][A] | u_score_store_sd/controller/page_reader/n552_s68/COUT
9.239 | 0.000 | tNET | RR | 2 | R51C54[2][B] | u_score_store_sd/controller/page_reader/n552_s69/CIN
9.289 | 0.050 | tINS | RR | 1 | R51C54[2][B] | u_score_store_sd/controller/page_reader/n552_s69/COUT
9.289 | 0.000 | tNET | RR | 2 | R51C55[0][A] | u_score_store_sd/controller/page_reader/n552_s70/CIN
9.339 | 0.050 | tINS | RR | 1 | R51C55[0][A] | u_score_store_sd/controller/page_reader/n552_s70/COUT
9.339 | 0.000 | tNET | RR | 2 | R51C55[0][B] | u_score_store_sd/controller/page_reader/n552_s71/CIN
9.389 | 0.050 | tINS | RR | 1 | R51C55[0][B] | u_score_store_sd/controller/page_reader/n552_s71/COUT
9.826 | 0.436 | tNET | RR | 1 | R49C55[2][A] | u_score_store_sd/controller/page_reader/n1468_s121/I1
10.287 | 0.461 | tINS | RR | 1 | R49C55[2][A] | u_score_store_sd/controller/page_reader/n1468_s121/F
10.444 | 0.157 | tNET | RR | 1 | R48C55[3][B] | u_score_store_sd/controller/page_reader/n1468_s119/I1
10.942 | 0.498 | tINS | RR | 1 | R48C55[3][B] | u_score_store_sd/controller/page_reader/n1468_s119/F
10.944 | 0.003 | tNET | RR | 1 | R48C55[1][B] | u_score_store_sd/controller/page_reader/n1468_s115/I0
11.471 | 0.526 | tINS | RR | 1 | R48C55[1][B] | u_score_store_sd/controller/page_reader/n1468_s115/F
11.774 | 0.304 | tNET | RR | 1 | R46C55[3][A] | u_score_store_sd/controller/page_reader/n1468_s104/I1
12.296 | 0.521 | tINS | RR | 6 | R46C55[3][A] | u_score_store_sd/controller/page_reader/n1468_s104/F
12.952 | 0.656 | tNET | RR | 1 | R50C55[0][B] | u_score_store_sd/controller/page_reader/n1468_s95/I1
13.478 | 0.526 | tINS | RR | 1 | R50C55[0][B] | u_score_store_sd/controller/page_reader/n1468_s95/F
13.481 | 0.003 | tNET | RR | 1 | R50C55[2][A] | u_score_store_sd/controller/page_reader/n1468_s85/I2
13.997 | 0.516 | tINS | RR | 3 | R50C55[2][A] | u_score_store_sd/controller/page_reader/n1468_s85/F
14.484 | 0.487 | tNET | RR | 1 | R49C54[1][B] | u_score_store_sd/controller/page_reader/n1468_s81/I0
15.001 | 0.516 | tINS | RR | 1 | R49C54[1][B] | u_score_store_sd/controller/page_reader/n1468_s81/F
15.158 | 0.157 | tNET | RR | 1 | R50C54[1][A] | u_score_store_sd/controller/page_reader/n1468_s79/I0
15.674 | 0.516 | tINS | RR | 1 | R50C54[1][A] | u_score_store_sd/controller/page_reader/n1468_s79/F
15.677 | 0.003 | tNET | RR | 1 | R50C54[1][B] | u_score_store_sd/controller/page_reader/n1468_s74/I1
15.939 | 0.262 | tINS | RR | 2 | R50C54[1][B] | u_score_store_sd/controller/page_reader/n1468_s74/F
16.099 | 0.160 | tNET | RR | 1 | R49C54[2][B] | u_score_store_sd/controller/page_reader/n1468_s72/I2
16.626 | 0.526 | tINS | RR | 1 | R49C54[2][B] | u_score_store_sd/controller/page_reader/n1468_s72/F
16.628 | 0.003 | tNET | RR | 1 | R49C54[3][A] | u_score_store_sd/controller/page_reader/n1468_s64/I2
17.126 | 0.498 | tINS | RR | 2 | R49C54[3][A] | u_score_store_sd/controller/page_reader/n1468_s64/F
17.666 | 0.540 | tNET | RR | 1 | R52C54[1][A] | u_score_store_sd/controller/page_reader/n1468_s51/I1
17.928 | 0.262 | tINS | RR | 3 | R52C54[1][A] | u_score_store_sd/controller/page_reader/n1468_s51/F
18.416 | 0.487 | tNET | RR | 1 | R50C53[3][B] | u_score_store_sd/controller/page_reader/n1468_s42/I0
18.913 | 0.498 | tINS | RR | 1 | R50C53[3][B] | u_score_store_sd/controller/page_reader/n1468_s42/F
19.071 | 0.157 | tNET | RR | 1 | R50C52[3][B] | u_score_store_sd/controller/page_reader/n1468_s36/I0
19.592 | 0.521 | tINS | RR | 3 | R50C52[3][B] | u_score_store_sd/controller/page_reader/n1468_s36/F
19.944 | 0.352 | tNET | RR | 1 | R48C52[3][B] | u_score_store_sd/controller/page_reader/n1468_s33/I0
20.442 | 0.498 | tINS | RR | 23 | R48C52[3][B] | u_score_store_sd/controller/page_reader/n1468_s33/F
20.644 | 0.203 | tNET | RR | 1 | R48C51[3][B] | u_score_store_sd/controller/page_reader/n1495_s32/I1
21.142 | 0.498 | tINS | RR | 4 | R48C51[3][B] | u_score_store_sd/controller/page_reader/n1495_s32/F
21.337 | 0.195 | tNET | RR | 1 | R50C51[1][A] | u_score_store_sd/controller/page_reader/byte_index_8_s4/I0
21.863 | 0.526 | tINS | RR | 9 | R50C51[1][A] | u_score_store_sd/controller/page_reader/byte_index_8_s4/F
22.408 | 0.545 | tNET | RR | 1 | R48C49[1][B] | u_score_store_sd/controller/page_reader/byte_index_8_s1/CE

Data Required Path:

AT | DELAY | TYPE | RF | FANOUT | LOC | NODE
20.000 | 20.000 | | | | | active clock edge time
20.000 | 0.000 | | | | | sys_clk
20.000 | 0.000 | tCL | RR | 1 | IOB117[B] | sys_clk_ibuf/I
20.683 | 0.683 | tINS | RR | 13930 | IOB117[B] | sys_clk_ibuf/O
23.853 | 3.171 | tNET | RR | 1 | R48C49[1][B] | u_score_store_sd/controller/page_reader/byte_index_8_s1/CLK
23.542 | -0.311 | tSu | | 1 | R48C49[1][B] | u_score_store_sd/controller/page_reader/byte_index_8_s1

Path Statistics:

Clock Skew | -0.495
Setup Relationship | 20.000
Logic Level | 21
Arrival Clock Path Delay | cell: 0.683, 15.696%; route: 3.666, 84.304%
Arrival Data Path Delay | cell: 8.570, 47.453%; route: 9.108, 50.429%; tC2Q: 0.382, 2.118%
Required Clock Path Delay | cell: 0.683, 17.713%; route: 3.171, 82.287%

### Path21

Path Summary:

Slack | 1.144
Data Arrival Time | 22.388
Data Required Time | 23.532
From | u_score_store_sd/controller/page_reader/indexer/bitmap_offset_0_s1
To | u_score_store_sd/controller/page_reader/byte_index_6_s1
Launch Clk | sys_clk:[R]
Latch Clk | sys_clk:[R]

Data Arrival Path:

AT | DELAY | TYPE | RF | FANOUT | LOC | NODE
0.000 | 0.000 | | | | | active clock edge time
0.000 | 0.000 | | | | | sys_clk
0.000 | 0.000 | tCL | RR | 1 | IOB117[B] | sys_clk_ibuf/I
0.683 | 0.683 | tINS | RR | 13930 | IOB117[B] | sys_clk_ibuf/O
4.348 | 3.666 | tNET | RR | 1 | R35C55[0][A] | u_score_store_sd/controller/page_reader/indexer/bitmap_offset_0_s1/CLK
4.731 | 0.382 | tC2Q | RR | 4 | R35C55[0][A] | u_score_store_sd/controller/page_reader/indexer/bitmap_offset_0_s1/Q
8.989 | 4.259 | tNET | RR | 2 | R51C54[0][A] | u_score_store_sd/controller/page_reader/n552_s64/CIN
9.039 | 0.050 | tINS | RR | 1 | R51C54[0][A] | u_score_store_sd/controller/page_reader/n552_s64/COUT
9.039 | 0.000 | tNET | RR | 2 | R51C54[0][B] | u_score_store_sd/controller/page_reader/n552_s65/CIN
9.089 | 0.050 | tINS | RR | 1 | R51C54[0][B] | u_score_store_sd/controller/page_reader/n552_s65/COUT
9.089 | 0.000 | tNET | RR | 2 | R51C54[1][A] | u_score_store_sd/controller/page_reader/n552_s66/CIN
9.139 | 0.050 | tINS | RR | 1 | R51C54[1][A] | u_score_store_sd/controller/page_reader/n552_s66/COUT
9.139 | 0.000 | tNET | RR | 2 | R51C54[1][B] | u_score_store_sd/controller/page_reader/n552_s67/CIN
9.189 | 0.050 | tINS | RR | 1 | R51C54[1][B] | u_score_store_sd/controller/page_reader/n552_s67/COUT
9.189 | 0.000 | tNET | RR | 2 | R51C54[2][A] | u_score_store_sd/controller/page_reader/n552_s68/CIN
9.239 | 0.050 | tINS | RR | 1 | R51C54[2][A] | u_score_store_sd/controller/page_reader/n552_s68/COUT
9.239 | 0.000 | tNET | RR | 2 | R51C54[2][B] | u_score_store_sd/controller/page_reader/n552_s69/CIN
9.289 | 0.050 | tINS | RR | 1 | R51C54[2][B] | u_score_store_sd/controller/page_reader/n552_s69/COUT
9.289 | 0.000 | tNET | RR | 2 | R51C55[0][A] | u_score_store_sd/controller/page_reader/n552_s70/CIN
9.339 | 0.050 | tINS | RR | 1 | R51C55[0][A] | u_score_store_sd/controller/page_reader/n552_s70/COUT
9.339 | 0.000 | tNET | RR | 2 | R51C55[0][B] | u_score_store_sd/controller/page_reader/n552_s71/CIN
9.389 | 0.050 | tINS | RR | 1 | R51C55[0][B] | u_score_store_sd/controller/page_reader/n552_s71/COUT
9.826 | 0.436 | tNET | RR | 1 | R49C55[2][A] | u_score_store_sd/controller/page_reader/n1468_s121/I1
10.287 | 0.461 | tINS | RR | 1 | R49C55[2][A] | u_score_store_sd/controller/page_reader/n1468_s121/F
10.444 | 0.157 | tNET | RR | 1 | R48C55[3][B] | u_score_store_sd/controller/page_reader/n1468_s119/I1
10.942 | 0.498 | tINS | RR | 1 | R48C55[3][B] | u_score_store_sd/controller/page_reader/n1468_s119/F
10.944 | 0.003 | tNET | RR | 1 | R48C55[1][B] | u_score_store_sd/controller/page_reader/n1468_s115/I0
11.471 | 0.526 | tINS | RR | 1 | R48C55[1][B] | u_score_store_sd/controller/page_reader/n1468_s115/F
11.774 | 0.304 | tNET | RR | 1 | R46C55[3][A] | u_score_store_sd/controller/page_reader/n1468_s104/I1
12.296 | 0.521 | tINS | RR | 6 | R46C55[3][A] | u_score_store_sd/controller/page_reader/n1468_s104/F
12.952 | 0.656 | tNET | RR | 1 | R50C55[0][B] | u_score_store_sd/controller/page_reader/n1468_s95/I1
13.478 | 0.526 | tINS | RR | 1 | R50C55[0][B] | u_score_store_sd/controller/page_reader/n1468_s95/F
13.481 | 0.003 | tNET | RR | 1 | R50C55[2][A] | u_score_store_sd/controller/page_reader/n1468_s85/I2
13.997 | 0.516 | tINS | RR | 3 | R50C55[2][A] | u_score_store_sd/controller/page_reader/n1468_s85/F
14.484 | 0.487 | tNET | RR | 1 | R49C54[1][B] | u_score_store_sd/controller/page_reader/n1468_s81/I0
15.001 | 0.516 | tINS | RR | 1 | R49C54[1][B] | u_score_store_sd/controller/page_reader/n1468_s81/F
15.158 | 0.157 | tNET | RR | 1 | R50C54[1][A] | u_score_store_sd/controller/page_reader/n1468_s79/I0
15.674 | 0.516 | tINS | RR | 1 | R50C54[1][A] | u_score_store_sd/controller/page_reader/n1468_s79/F
15.677 | 0.003 | tNET | RR | 1 | R50C54[1][B] | u_score_store_sd/controller/page_reader/n1468_s74/I1
15.939 | 0.262 | tINS | RR | 2 | R50C54[1][B] | u_score_store_sd/controller/page_reader/n1468_s74/F
16.099 | 0.160 | tNET | RR | 1 | R49C54[2][B] | u_score_store_sd/controller/page_reader/n1468_s72/I2
16.626 | 0.526 | tINS | RR | 1 | R49C54[2][B] | u_score_store_sd/controller/page_reader/n1468_s72/F
16.628 | 0.003 | tNET | RR | 1 | R49C54[3][A] | u_score_store_sd/controller/page_reader/n1468_s64/I2
17.126 | 0.498 | tINS | RR | 2 | R49C54[3][A] | u_score_store_sd/controller/page_reader/n1468_s64/F
17.666 | 0.540 | tNET | RR | 1 | R52C54[1][A] | u_score_store_sd/controller/page_reader/n1468_s51/I1
17.928 | 0.262 | tINS | RR | 3 | R52C54[1][A] | u_score_store_sd/controller/page_reader/n1468_s51/F
18.416 | 0.487 | tNET | RR | 1 | R50C53[3][B] | u_score_store_sd/controller/page_reader/n1468_s42/I0
18.913 | 0.498 | tINS | RR | 1 | R50C53[3][B] | u_score_store_sd/controller/page_reader/n1468_s42/F
19.071 | 0.157 | tNET | RR | 1 | R50C52[3][B] | u_score_store_sd/controller/page_reader/n1468_s36/I0
19.592 | 0.521 | tINS | RR | 3 | R50C52[3][B] | u_score_store_sd/controller/page_reader/n1468_s36/F
19.944 | 0.352 | tNET | RR | 1 | R48C52[3][B] | u_score_store_sd/controller/page_reader/n1468_s33/I0
20.442 | 0.498 | tINS | RR | 23 | R48C52[3][B] | u_score_store_sd/controller/page_reader/n1468_s33/F
20.644 | 0.203 | tNET | RR | 1 | R48C51[3][B] | u_score_store_sd/controller/page_reader/n1495_s32/I1
21.142 | 0.498 | tINS | RR | 4 | R48C51[3][B] | u_score_store_sd/controller/page_reader/n1495_s32/F
21.337 | 0.195 | tNET | RR | 1 | R50C51[1][A] | u_score_store_sd/controller/page_reader/byte_index_8_s4/I0
21.863 | 0.526 | tINS | RR | 9 | R50C51[1][A] | u_score_store_sd/controller/page_reader/byte_index_8_s4/F
22.388 | 0.525 | tNET | RR | 1 | R48C50[2][A] | u_score_store_sd/controller/page_reader/byte_index_6_s1/CE

Data Required Path:

AT | DELAY | TYPE | RF | FANOUT | LOC | NODE
20.000 | 20.000 | | | | | active clock edge time
20.000 | 0.000 | | | | | sys_clk
20.000 | 0.000 | tCL | RR | 1 | IOB117[B] | sys_clk_ibuf/I
20.683 | 0.683 | tINS | RR | 13930 | IOB117[B] | sys_clk_ibuf/O
23.844 | 3.161 | tNET | RR | 1 | R48C50[2][A] | u_score_store_sd/controller/page_reader/byte_index_6_s1/CLK
23.532 | -0.311 | tSu | | 1 | R48C50[2][A] | u_score_store_sd/controller/page_reader/byte_index_6_s1

Path Statistics:

Clock Skew | -0.504
Setup Relationship | 20.000
Logic Level | 21
Arrival Clock Path Delay | cell: 0.683, 15.696%; route: 3.666, 84.304%
Arrival Data Path Delay | cell: 8.570, 47.506%; route: 9.088, 50.374%; tC2Q: 0.382, 2.120%
Required Clock Path Delay | cell: 0.683, 17.756%; route: 3.161, 82.244%

### Path22

Path Summary:

Slack | 1.174
Data Arrival Time | 22.358
Data Required Time | 23.532
From | u_score_store_sd/controller/page_reader/indexer/bitmap_offset_0_s1
To | u_score_store_sd/controller/page_reader/sector_index_3_s1
Launch Clk | sys_clk:[R]
Latch Clk | sys_clk:[R]

Data Arrival Path:

AT | DELAY | TYPE | RF | FANOUT | LOC | NODE
0.000 | 0.000 | | | | | active clock edge time
0.000 | 0.000 | | | | | sys_clk
0.000 | 0.000 | tCL | RR | 1 | IOB117[B] | sys_clk_ibuf/I
0.683 | 0.683 | tINS | RR | 13930 | IOB117[B] | sys_clk_ibuf/O
4.348 | 3.666 | tNET | RR | 1 | R35C55[0][A] | u_score_store_sd/controller/page_reader/indexer/bitmap_offset_0_s1/CLK
4.731 | 0.382 | tC2Q | RR | 4 | R35C55[0][A] | u_score_store_sd/controller/page_reader/indexer/bitmap_offset_0_s1/Q
8.989 | 4.259 | tNET | RR | 2 | R51C54[0][A] | u_score_store_sd/controller/page_reader/n552_s64/CIN
9.039 | 0.050 | tINS | RR | 1 | R51C54[0][A] | u_score_store_sd/controller/page_reader/n552_s64/COUT
9.039 | 0.000 | tNET | RR | 2 | R51C54[0][B] | u_score_store_sd/controller/page_reader/n552_s65/CIN
9.089 | 0.050 | tINS | RR | 1 | R51C54[0][B] | u_score_store_sd/controller/page_reader/n552_s65/COUT
9.089 | 0.000 | tNET | RR | 2 | R51C54[1][A] | u_score_store_sd/controller/page_reader/n552_s66/CIN
9.139 | 0.050 | tINS | RR | 1 | R51C54[1][A] | u_score_store_sd/controller/page_reader/n552_s66/COUT
9.139 | 0.000 | tNET | RR | 2 | R51C54[1][B] | u_score_store_sd/controller/page_reader/n552_s67/CIN
9.189 | 0.050 | tINS | RR | 1 | R51C54[1][B] | u_score_store_sd/controller/page_reader/n552_s67/COUT
9.189 | 0.000 | tNET | RR | 2 | R51C54[2][A] | u_score_store_sd/controller/page_reader/n552_s68/CIN
9.239 | 0.050 | tINS | RR | 1 | R51C54[2][A] | u_score_store_sd/controller/page_reader/n552_s68/COUT
9.239 | 0.000 | tNET | RR | 2 | R51C54[2][B] | u_score_store_sd/controller/page_reader/n552_s69/CIN
9.289 | 0.050 | tINS | RR | 1 | R51C54[2][B] | u_score_store_sd/controller/page_reader/n552_s69/COUT
9.289 | 0.000 | tNET | RR | 2 | R51C55[0][A] | u_score_store_sd/controller/page_reader/n552_s70/CIN
9.339 | 0.050 | tINS | RR | 1 | R51C55[0][A] | u_score_store_sd/controller/page_reader/n552_s70/COUT
9.339 | 0.000 | tNET | RR | 2 | R51C55[0][B] | u_score_store_sd/controller/page_reader/n552_s71/CIN
9.389 | 0.050 | tINS | RR | 1 | R51C55[0][B] | u_score_store_sd/controller/page_reader/n552_s71/COUT
9.826 | 0.436 | tNET | RR | 1 | R49C55[2][A] | u_score_store_sd/controller/page_reader/n1468_s121/I1
10.287 | 0.461 | tINS | RR | 1 | R49C55[2][A] | u_score_store_sd/controller/page_reader/n1468_s121/F
10.444 | 0.157 | tNET | RR | 1 | R48C55[3][B] | u_score_store_sd/controller/page_reader/n1468_s119/I1
10.942 | 0.498 | tINS | RR | 1 | R48C55[3][B] | u_score_store_sd/controller/page_reader/n1468_s119/F
10.944 | 0.003 | tNET | RR | 1 | R48C55[1][B] | u_score_store_sd/controller/page_reader/n1468_s115/I0
11.471 | 0.526 | tINS | RR | 1 | R48C55[1][B] | u_score_store_sd/controller/page_reader/n1468_s115/F
11.774 | 0.304 | tNET | RR | 1 | R46C55[3][A] | u_score_store_sd/controller/page_reader/n1468_s104/I1
12.296 | 0.521 | tINS | RR | 6 | R46C55[3][A] | u_score_store_sd/controller/page_reader/n1468_s104/F
12.952 | 0.656 | tNET | RR | 1 | R50C55[0][B] | u_score_store_sd/controller/page_reader/n1468_s95/I1
13.478 | 0.526 | tINS | RR | 1 | R50C55[0][B] | u_score_store_sd/controller/page_reader/n1468_s95/F
13.481 | 0.003 | tNET | RR | 1 | R50C55[2][A] | u_score_store_sd/controller/page_reader/n1468_s85/I2
13.997 | 0.516 | tINS | RR | 3 | R50C55[2][A] | u_score_store_sd/controller/page_reader/n1468_s85/F
14.484 | 0.487 | tNET | RR | 1 | R49C54[1][B] | u_score_store_sd/controller/page_reader/n1468_s81/I0
15.001 | 0.516 | tINS | RR | 1 | R49C54[1][B] | u_score_store_sd/controller/page_reader/n1468_s81/F
15.158 | 0.157 | tNET | RR | 1 | R50C54[1][A] | u_score_store_sd/controller/page_reader/n1468_s79/I0
15.674 | 0.516 | tINS | RR | 1 | R50C54[1][A] | u_score_store_sd/controller/page_reader/n1468_s79/F
15.677 | 0.003 | tNET | RR | 1 | R50C54[1][B] | u_score_store_sd/controller/page_reader/n1468_s74/I1
15.939 | 0.262 | tINS | RR | 2 | R50C54[1][B] | u_score_store_sd/controller/page_reader/n1468_s74/F
16.099 | 0.160 | tNET | RR | 1 | R49C54[2][B] | u_score_store_sd/controller/page_reader/n1468_s72/I2
16.626 | 0.526 | tINS | RR | 1 | R49C54[2][B] | u_score_store_sd/controller/page_reader/n1468_s72/F
16.628 | 0.003 | tNET | RR | 1 | R49C54[3][A] | u_score_store_sd/controller/page_reader/n1468_s64/I2
17.126 | 0.498 | tINS | RR | 2 | R49C54[3][A] | u_score_store_sd/controller/page_reader/n1468_s64/F
17.666 | 0.540 | tNET | RR | 1 | R52C54[1][A] | u_score_store_sd/controller/page_reader/n1468_s51/I1
17.928 | 0.262 | tINS | RR | 3 | R52C54[1][A] | u_score_store_sd/controller/page_reader/n1468_s51/F
18.416 | 0.487 | tNET | RR | 1 | R50C53[3][B] | u_score_store_sd/controller/page_reader/n1468_s42/I0
18.913 | 0.498 | tINS | RR | 1 | R50C53[3][B] | u_score_store_sd/controller/page_reader/n1468_s42/F
19.071 | 0.157 | tNET | RR | 1 | R50C52[3][B] | u_score_store_sd/controller/page_reader/n1468_s36/I0
19.592 | 0.521 | tINS | RR | 3 | R50C52[3][B] | u_score_store_sd/controller/page_reader/n1468_s36/F
19.944 | 0.352 | tNET | RR | 1 | R48C52[3][B] | u_score_store_sd/controller/page_reader/n1468_s33/I0
20.442 | 0.498 | tINS | RR | 23 | R48C52[3][B] | u_score_store_sd/controller/page_reader/n1468_s33/F
20.807 | 0.365 | tNET | RR | 1 | R49C51[3][B] | u_score_store_sd/controller/page_reader/sector_index_12_s4/I0
21.304 | 0.498 | tINS | RR | 13 | R49C51[3][B] | u_score_store_sd/controller/page_reader/sector_index_12_s4/F
22.358 | 1.054 | tNET | RR | 1 | R48C58[1][A] | u_score_store_sd/controller/page_reader/sector_index_3_s1/CE

Data Required Path:

AT | DELAY | TYPE | RF | FANOUT | LOC | NODE
20.000 | 20.000 | | | | | active clock edge time
20.000 | 0.000 | | | | | sys_clk
20.000 | 0.000 | tCL | RR | 1 | IOB117[B] | sys_clk_ibuf/I
20.683 | 0.683 | tINS | RR | 13930 | IOB117[B] | sys_clk_ibuf/O
23.844 | 3.161 | tNET | RR | 1 | R48C58[1][A] | u_score_store_sd/controller/page_reader/sector_index_3_s1/CLK
23.532 | -0.311 | tSu | | 1 | R48C58[1][A] | u_score_store_sd/controller/page_reader/sector_index_3_s1

Path Statistics:

Clock Skew | -0.504
Setup Relationship | 20.000
Logic Level | 20
Arrival Clock Path Delay | cell: 0.683, 15.696%; route: 3.666, 84.304%
Arrival Data Path Delay | cell: 8.044, 44.663%; route: 9.584, 53.213%; tC2Q: 0.382, 2.124%
Required Clock Path Delay | cell: 0.683, 17.756%; route: 3.161, 82.244%

### Path23

Path Summary:

Slack | 1.174
Data Arrival Time | 22.358
Data Required Time | 23.532
From | u_score_store_sd/controller/page_reader/indexer/bitmap_offset_0_s1
To | u_score_store_sd/controller/page_reader/sector_index_4_s1
Launch Clk | sys_clk:[R]
Latch Clk | sys_clk:[R]

Data Arrival Path:

AT | DELAY | TYPE | RF | FANOUT | LOC | NODE
0.000 | 0.000 | | | | | active clock edge time
0.000 | 0.000 | | | | | sys_clk
0.000 | 0.000 | tCL | RR | 1 | IOB117[B] | sys_clk_ibuf/I
0.683 | 0.683 | tINS | RR | 13930 | IOB117[B] | sys_clk_ibuf/O
4.348 | 3.666 | tNET | RR | 1 | R35C55[0][A] | u_score_store_sd/controller/page_reader/indexer/bitmap_offset_0_s1/CLK
4.731 | 0.382 | tC2Q | RR | 4 | R35C55[0][A] | u_score_store_sd/controller/page_reader/indexer/bitmap_offset_0_s1/Q
8.989 | 4.259 | tNET | RR | 2 | R51C54[0][A] | u_score_store_sd/controller/page_reader/n552_s64/CIN
9.039 | 0.050 | tINS | RR | 1 | R51C54[0][A] | u_score_store_sd/controller/page_reader/n552_s64/COUT
9.039 | 0.000 | tNET | RR | 2 | R51C54[0][B] | u_score_store_sd/controller/page_reader/n552_s65/CIN
9.089 | 0.050 | tINS | RR | 1 | R51C54[0][B] | u_score_store_sd/controller/page_reader/n552_s65/COUT
9.089 | 0.000 | tNET | RR | 2 | R51C54[1][A] | u_score_store_sd/controller/page_reader/n552_s66/CIN
9.139 | 0.050 | tINS | RR | 1 | R51C54[1][A] | u_score_store_sd/controller/page_reader/n552_s66/COUT
9.139 | 0.000 | tNET | RR | 2 | R51C54[1][B] | u_score_store_sd/controller/page_reader/n552_s67/CIN
9.189 | 0.050 | tINS | RR | 1 | R51C54[1][B] | u_score_store_sd/controller/page_reader/n552_s67/COUT
9.189 | 0.000 | tNET | RR | 2 | R51C54[2][A] | u_score_store_sd/controller/page_reader/n552_s68/CIN
9.239 | 0.050 | tINS | RR | 1 | R51C54[2][A] | u_score_store_sd/controller/page_reader/n552_s68/COUT
9.239 | 0.000 | tNET | RR | 2 | R51C54[2][B] | u_score_store_sd/controller/page_reader/n552_s69/CIN
9.289 | 0.050 | tINS | RR | 1 | R51C54[2][B] | u_score_store_sd/controller/page_reader/n552_s69/COUT
9.289 | 0.000 | tNET | RR | 2 | R51C55[0][A] | u_score_store_sd/controller/page_reader/n552_s70/CIN
9.339 | 0.050 | tINS | RR | 1 | R51C55[0][A] | u_score_store_sd/controller/page_reader/n552_s70/COUT
9.339 | 0.000 | tNET | RR | 2 | R51C55[0][B] | u_score_store_sd/controller/page_reader/n552_s71/CIN
9.389 | 0.050 | tINS | RR | 1 | R51C55[0][B] | u_score_store_sd/controller/page_reader/n552_s71/COUT
9.826 | 0.436 | tNET | RR | 1 | R49C55[2][A] | u_score_store_sd/controller/page_reader/n1468_s121/I1
10.287 | 0.461 | tINS | RR | 1 | R49C55[2][A] | u_score_store_sd/controller/page_reader/n1468_s121/F
10.444 | 0.157 | tNET | RR | 1 | R48C55[3][B] | u_score_store_sd/controller/page_reader/n1468_s119/I1
10.942 | 0.498 | tINS | RR | 1 | R48C55[3][B] | u_score_store_sd/controller/page_reader/n1468_s119/F
10.944 | 0.003 | tNET | RR | 1 | R48C55[1][B] | u_score_store_sd/controller/page_reader/n1468_s115/I0
11.471 | 0.526 | tINS | RR | 1 | R48C55[1][B] | u_score_store_sd/controller/page_reader/n1468_s115/F
11.774 | 0.304 | tNET | RR | 1 | R46C55[3][A] | u_score_store_sd/controller/page_reader/n1468_s104/I1
12.296 | 0.521 | tINS | RR | 6 | R46C55[3][A] | u_score_store_sd/controller/page_reader/n1468_s104/F
12.952 | 0.656 | tNET | RR | 1 | R50C55[0][B] | u_score_store_sd/controller/page_reader/n1468_s95/I1
13.478 | 0.526 | tINS | RR | 1 | R50C55[0][B] | u_score_store_sd/controller/page_reader/n1468_s95/F
13.481 | 0.003 | tNET | RR | 1 | R50C55[2][A] | u_score_store_sd/controller/page_reader/n1468_s85/I2
13.997 | 0.516 | tINS | RR | 3 | R50C55[2][A] | u_score_store_sd/controller/page_reader/n1468_s85/F
14.484 | 0.487 | tNET | RR | 1 | R49C54[1][B] | u_score_store_sd/controller/page_reader/n1468_s81/I0
15.001 | 0.516 | tINS | RR | 1 | R49C54[1][B] | u_score_store_sd/controller/page_reader/n1468_s81/F
15.158 | 0.157 | tNET | RR | 1 | R50C54[1][A] | u_score_store_sd/controller/page_reader/n1468_s79/I0
15.674 | 0.516 | tINS | RR | 1 | R50C54[1][A] | u_score_store_sd/controller/page_reader/n1468_s79/F
15.677 | 0.003 | tNET | RR | 1 | R50C54[1][B] | u_score_store_sd/controller/page_reader/n1468_s74/I1
15.939 | 0.262 | tINS | RR | 2 | R50C54[1][B] | u_score_store_sd/controller/page_reader/n1468_s74/F
16.099 | 0.160 | tNET | RR | 1 | R49C54[2][B] | u_score_store_sd/controller/page_reader/n1468_s72/I2
16.626 | 0.526 | tINS | RR | 1 | R49C54[2][B] | u_score_store_sd/controller/page_reader/n1468_s72/F
16.628 | 0.003 | tNET | RR | 1 | R49C54[3][A] | u_score_store_sd/controller/page_reader/n1468_s64/I2
17.126 | 0.498 | tINS | RR | 2 | R49C54[3][A] | u_score_store_sd/controller/page_reader/n1468_s64/F
17.666 | 0.540 | tNET | RR | 1 | R52C54[1][A] | u_score_store_sd/controller/page_reader/n1468_s51/I1
17.928 | 0.262 | tINS | RR | 3 | R52C54[1][A] | u_score_store_sd/controller/page_reader/n1468_s51/F
18.416 | 0.487 | tNET | RR | 1 | R50C53[3][B] | u_score_store_sd/controller/page_reader/n1468_s42/I0
18.913 | 0.498 | tINS | RR | 1 | R50C53[3][B] | u_score_store_sd/controller/page_reader/n1468_s42/F
19.071 | 0.157 | tNET | RR | 1 | R50C52[3][B] | u_score_store_sd/controller/page_reader/n1468_s36/I0
19.592 | 0.521 | tINS | RR | 3 | R50C52[3][B] | u_score_store_sd/controller/page_reader/n1468_s36/F
19.944 | 0.352 | tNET | RR | 1 | R48C52[3][B] | u_score_store_sd/controller/page_reader/n1468_s33/I0
20.442 | 0.498 | tINS | RR | 23 | R48C52[3][B] | u_score_store_sd/controller/page_reader/n1468_s33/F
20.807 | 0.365 | tNET | RR | 1 | R49C51[3][B] | u_score_store_sd/controller/page_reader/sector_index_12_s4/I0
21.304 | 0.498 | tINS | RR | 13 | R49C51[3][B] | u_score_store_sd/controller/page_reader/sector_index_12_s4/F
22.358 | 1.054 | tNET | RR | 1 | R49C58[0][B] | u_score_store_sd/controller/page_reader/sector_index_4_s1/CE

Data Required Path:

AT | DELAY | TYPE | RF | FANOUT | LOC | NODE
20.000 | 20.000 | | | | | active clock edge time
20.000 | 0.000 | | | | | sys_clk
20.000 | 0.000 | tCL | RR | 1 | IOB117[B] | sys_clk_ibuf/I
20.683 | 0.683 | tINS | RR | 13930 | IOB117[B] | sys_clk_ibuf/O
23.844 | 3.161 | tNET | RR | 1 | R49C58[0][B] | u_score_store_sd/controller/page_reader/sector_index_4_s1/CLK
23.532 | -0.311 | tSu | | 1 | R49C58[0][B] | u_score_store_sd/controller/page_reader/sector_index_4_s1

Path Statistics:

Clock Skew | -0.504
Setup Relationship | 20.000
Logic Level | 20
Arrival Clock Path Delay | cell: 0.683, 15.696%; route: 3.666, 84.304%
Arrival Data Path Delay | cell: 8.044, 44.663%; route: 9.584, 53.213%; tC2Q: 0.382, 2.124%
Required Clock Path Delay | cell: 0.683, 17.756%; route: 3.161, 82.244%

### Path24

Path Summary:

Slack | 1.174
Data Arrival Time | 22.358
Data Required Time | 23.532
From | u_score_store_sd/controller/page_reader/indexer/bitmap_offset_0_s1
To | u_score_store_sd/controller/page_reader/sector_index_5_s1
Launch Clk | sys_clk:[R]
Latch Clk | sys_clk:[R]

Data Arrival Path:

AT | DELAY | TYPE | RF | FANOUT | LOC | NODE
0.000 | 0.000 | | | | | active clock edge time
0.000 | 0.000 | | | | | sys_clk
0.000 | 0.000 | tCL | RR | 1 | IOB117[B] | sys_clk_ibuf/I
0.683 | 0.683 | tINS | RR | 13930 | IOB117[B] | sys_clk_ibuf/O
4.348 | 3.666 | tNET | RR | 1 | R35C55[0][A] | u_score_store_sd/controller/page_reader/indexer/bitmap_offset_0_s1/CLK
4.731 | 0.382 | tC2Q | RR | 4 | R35C55[0][A] | u_score_store_sd/controller/page_reader/indexer/bitmap_offset_0_s1/Q
8.989 | 4.259 | tNET | RR | 2 | R51C54[0][A] | u_score_store_sd/controller/page_reader/n552_s64/CIN
9.039 | 0.050 | tINS | RR | 1 | R51C54[0][A] | u_score_store_sd/controller/page_reader/n552_s64/COUT
9.039 | 0.000 | tNET | RR | 2 | R51C54[0][B] | u_score_store_sd/controller/page_reader/n552_s65/CIN
9.089 | 0.050 | tINS | RR | 1 | R51C54[0][B] | u_score_store_sd/controller/page_reader/n552_s65/COUT
9.089 | 0.000 | tNET | RR | 2 | R51C54[1][A] | u_score_store_sd/controller/page_reader/n552_s66/CIN
9.139 | 0.050 | tINS | RR | 1 | R51C54[1][A] | u_score_store_sd/controller/page_reader/n552_s66/COUT
9.139 | 0.000 | tNET | RR | 2 | R51C54[1][B] | u_score_store_sd/controller/page_reader/n552_s67/CIN
9.189 | 0.050 | tINS | RR | 1 | R51C54[1][B] | u_score_store_sd/controller/page_reader/n552_s67/COUT
9.189 | 0.000 | tNET | RR | 2 | R51C54[2][A] | u_score_store_sd/controller/page_reader/n552_s68/CIN
9.239 | 0.050 | tINS | RR | 1 | R51C54[2][A] | u_score_store_sd/controller/page_reader/n552_s68/COUT
9.239 | 0.000 | tNET | RR | 2 | R51C54[2][B] | u_score_store_sd/controller/page_reader/n552_s69/CIN
9.289 | 0.050 | tINS | RR | 1 | R51C54[2][B] | u_score_store_sd/controller/page_reader/n552_s69/COUT
9.289 | 0.000 | tNET | RR | 2 | R51C55[0][A] | u_score_store_sd/controller/page_reader/n552_s70/CIN
9.339 | 0.050 | tINS | RR | 1 | R51C55[0][A] | u_score_store_sd/controller/page_reader/n552_s70/COUT
9.339 | 0.000 | tNET | RR | 2 | R51C55[0][B] | u_score_store_sd/controller/page_reader/n552_s71/CIN
9.389 | 0.050 | tINS | RR | 1 | R51C55[0][B] | u_score_store_sd/controller/page_reader/n552_s71/COUT
9.826 | 0.436 | tNET | RR | 1 | R49C55[2][A] | u_score_store_sd/controller/page_reader/n1468_s121/I1
10.287 | 0.461 | tINS | RR | 1 | R49C55[2][A] | u_score_store_sd/controller/page_reader/n1468_s121/F
10.444 | 0.157 | tNET | RR | 1 | R48C55[3][B] | u_score_store_sd/controller/page_reader/n1468_s119/I1
10.942 | 0.498 | tINS | RR | 1 | R48C55[3][B] | u_score_store_sd/controller/page_reader/n1468_s119/F
10.944 | 0.003 | tNET | RR | 1 | R48C55[1][B] | u_score_store_sd/controller/page_reader/n1468_s115/I0
11.471 | 0.526 | tINS | RR | 1 | R48C55[1][B] | u_score_store_sd/controller/page_reader/n1468_s115/F
11.774 | 0.304 | tNET | RR | 1 | R46C55[3][A] | u_score_store_sd/controller/page_reader/n1468_s104/I1
12.296 | 0.521 | tINS | RR | 6 | R46C55[3][A] | u_score_store_sd/controller/page_reader/n1468_s104/F
12.952 | 0.656 | tNET | RR | 1 | R50C55[0][B] | u_score_store_sd/controller/page_reader/n1468_s95/I1
13.478 | 0.526 | tINS | RR | 1 | R50C55[0][B] | u_score_store_sd/controller/page_reader/n1468_s95/F
13.481 | 0.003 | tNET | RR | 1 | R50C55[2][A] | u_score_store_sd/controller/page_reader/n1468_s85/I2
13.997 | 0.516 | tINS | RR | 3 | R50C55[2][A] | u_score_store_sd/controller/page_reader/n1468_s85/F
14.484 | 0.487 | tNET | RR | 1 | R49C54[1][B] | u_score_store_sd/controller/page_reader/n1468_s81/I0
15.001 | 0.516 | tINS | RR | 1 | R49C54[1][B] | u_score_store_sd/controller/page_reader/n1468_s81/F
15.158 | 0.157 | tNET | RR | 1 | R50C54[1][A] | u_score_store_sd/controller/page_reader/n1468_s79/I0
15.674 | 0.516 | tINS | RR | 1 | R50C54[1][A] | u_score_store_sd/controller/page_reader/n1468_s79/F
15.677 | 0.003 | tNET | RR | 1 | R50C54[1][B] | u_score_store_sd/controller/page_reader/n1468_s74/I1
15.939 | 0.262 | tINS | RR | 2 | R50C54[1][B] | u_score_store_sd/controller/page_reader/n1468_s74/F
16.099 | 0.160 | tNET | RR | 1 | R49C54[2][B] | u_score_store_sd/controller/page_reader/n1468_s72/I2
16.626 | 0.526 | tINS | RR | 1 | R49C54[2][B] | u_score_store_sd/controller/page_reader/n1468_s72/F
16.628 | 0.003 | tNET | RR | 1 | R49C54[3][A] | u_score_store_sd/controller/page_reader/n1468_s64/I2
17.126 | 0.498 | tINS | RR | 2 | R49C54[3][A] | u_score_store_sd/controller/page_reader/n1468_s64/F
17.666 | 0.540 | tNET | RR | 1 | R52C54[1][A] | u_score_store_sd/controller/page_reader/n1468_s51/I1
17.928 | 0.262 | tINS | RR | 3 | R52C54[1][A] | u_score_store_sd/controller/page_reader/n1468_s51/F
18.416 | 0.487 | tNET | RR | 1 | R50C53[3][B] | u_score_store_sd/controller/page_reader/n1468_s42/I0
18.913 | 0.498 | tINS | RR | 1 | R50C53[3][B] | u_score_store_sd/controller/page_reader/n1468_s42/F
19.071 | 0.157 | tNET | RR | 1 | R50C52[3][B] | u_score_store_sd/controller/page_reader/n1468_s36/I0
19.592 | 0.521 | tINS | RR | 3 | R50C52[3][B] | u_score_store_sd/controller/page_reader/n1468_s36/F
19.944 | 0.352 | tNET | RR | 1 | R48C52[3][B] | u_score_store_sd/controller/page_reader/n1468_s33/I0
20.442 | 0.498 | tINS | RR | 23 | R48C52[3][B] | u_score_store_sd/controller/page_reader/n1468_s33/F
20.807 | 0.365 | tNET | RR | 1 | R49C51[3][B] | u_score_store_sd/controller/page_reader/sector_index_12_s4/I0
21.304 | 0.498 | tINS | RR | 13 | R49C51[3][B] | u_score_store_sd/controller/page_reader/sector_index_12_s4/F
22.358 | 1.054 | tNET | RR | 1 | R49C58[0][A] | u_score_store_sd/controller/page_reader/sector_index_5_s1/CE

Data Required Path:

AT | DELAY | TYPE | RF | FANOUT | LOC | NODE
20.000 | 20.000 | | | | | active clock edge time
20.000 | 0.000 | | | | | sys_clk
20.000 | 0.000 | tCL | RR | 1 | IOB117[B] | sys_clk_ibuf/I
20.683 | 0.683 | tINS | RR | 13930 | IOB117[B] | sys_clk_ibuf/O
23.844 | 3.161 | tNET | RR | 1 | R49C58[0][A] | u_score_store_sd/controller/page_reader/sector_index_5_s1/CLK
23.532 | -0.311 | tSu | | 1 | R49C58[0][A] | u_score_store_sd/controller/page_reader/sector_index_5_s1

Path Statistics:

Clock Skew | -0.504
Setup Relationship | 20.000
Logic Level | 20
Arrival Clock Path Delay | cell: 0.683, 15.696%; route: 3.666, 84.304%
Arrival Data Path Delay | cell: 8.044, 44.663%; route: 9.584, 53.213%; tC2Q: 0.382, 2.124%
Required Clock Path Delay | cell: 0.683, 17.756%; route: 3.161, 82.244%

### Path25

Path Summary:

Slack | 1.199
Data Arrival Time | 22.333
Data Required Time | 23.532
From | u_score_store_sd/controller/page_reader/indexer/bitmap_offset_0_s1
To | u_score_store_sd/controller/page_reader/streaming_s1
Launch Clk | sys_clk:[R]
Latch Clk | sys_clk:[R]

Data Arrival Path:

AT | DELAY | TYPE | RF | FANOUT | LOC | NODE
0.000 | 0.000 | | | | | active clock edge time
0.000 | 0.000 | | | | | sys_clk
0.000 | 0.000 | tCL | RR | 1 | IOB117[B] | sys_clk_ibuf/I
0.683 | 0.683 | tINS | RR | 13930 | IOB117[B] | sys_clk_ibuf/O
4.348 | 3.666 | tNET | RR | 1 | R35C55[0][A] | u_score_store_sd/controller/page_reader/indexer/bitmap_offset_0_s1/CLK
4.731 | 0.382 | tC2Q | RR | 4 | R35C55[0][A] | u_score_store_sd/controller/page_reader/indexer/bitmap_offset_0_s1/Q
8.989 | 4.259 | tNET | RR | 2 | R51C54[0][A] | u_score_store_sd/controller/page_reader/n552_s64/CIN
9.039 | 0.050 | tINS | RR | 1 | R51C54[0][A] | u_score_store_sd/controller/page_reader/n552_s64/COUT
9.039 | 0.000 | tNET | RR | 2 | R51C54[0][B] | u_score_store_sd/controller/page_reader/n552_s65/CIN
9.089 | 0.050 | tINS | RR | 1 | R51C54[0][B] | u_score_store_sd/controller/page_reader/n552_s65/COUT
9.089 | 0.000 | tNET | RR | 2 | R51C54[1][A] | u_score_store_sd/controller/page_reader/n552_s66/CIN
9.139 | 0.050 | tINS | RR | 1 | R51C54[1][A] | u_score_store_sd/controller/page_reader/n552_s66/COUT
9.139 | 0.000 | tNET | RR | 2 | R51C54[1][B] | u_score_store_sd/controller/page_reader/n552_s67/CIN
9.189 | 0.050 | tINS | RR | 1 | R51C54[1][B] | u_score_store_sd/controller/page_reader/n552_s67/COUT
9.189 | 0.000 | tNET | RR | 2 | R51C54[2][A] | u_score_store_sd/controller/page_reader/n552_s68/CIN
9.239 | 0.050 | tINS | RR | 1 | R51C54[2][A] | u_score_store_sd/controller/page_reader/n552_s68/COUT
9.239 | 0.000 | tNET | RR | 2 | R51C54[2][B] | u_score_store_sd/controller/page_reader/n552_s69/CIN
9.289 | 0.050 | tINS | RR | 1 | R51C54[2][B] | u_score_store_sd/controller/page_reader/n552_s69/COUT
9.289 | 0.000 | tNET | RR | 2 | R51C55[0][A] | u_score_store_sd/controller/page_reader/n552_s70/CIN
9.339 | 0.050 | tINS | RR | 1 | R51C55[0][A] | u_score_store_sd/controller/page_reader/n552_s70/COUT
9.339 | 0.000 | tNET | RR | 2 | R51C55[0][B] | u_score_store_sd/controller/page_reader/n552_s71/CIN
9.389 | 0.050 | tINS | RR | 1 | R51C55[0][B] | u_score_store_sd/controller/page_reader/n552_s71/COUT
9.826 | 0.436 | tNET | RR | 1 | R49C55[2][A] | u_score_store_sd/controller/page_reader/n1468_s121/I1
10.287 | 0.461 | tINS | RR | 1 | R49C55[2][A] | u_score_store_sd/controller/page_reader/n1468_s121/F
10.444 | 0.157 | tNET | RR | 1 | R48C55[3][B] | u_score_store_sd/controller/page_reader/n1468_s119/I1
10.942 | 0.498 | tINS | RR | 1 | R48C55[3][B] | u_score_store_sd/controller/page_reader/n1468_s119/F
10.944 | 0.003 | tNET | RR | 1 | R48C55[1][B] | u_score_store_sd/controller/page_reader/n1468_s115/I0
11.471 | 0.526 | tINS | RR | 1 | R48C55[1][B] | u_score_store_sd/controller/page_reader/n1468_s115/F
11.774 | 0.304 | tNET | RR | 1 | R46C55[3][A] | u_score_store_sd/controller/page_reader/n1468_s104/I1
12.296 | 0.521 | tINS | RR | 6 | R46C55[3][A] | u_score_store_sd/controller/page_reader/n1468_s104/F
12.952 | 0.656 | tNET | RR | 1 | R50C55[0][B] | u_score_store_sd/controller/page_reader/n1468_s95/I1
13.478 | 0.526 | tINS | RR | 1 | R50C55[0][B] | u_score_store_sd/controller/page_reader/n1468_s95/F
13.481 | 0.003 | tNET | RR | 1 | R50C55[2][A] | u_score_store_sd/controller/page_reader/n1468_s85/I2
13.997 | 0.516 | tINS | RR | 3 | R50C55[2][A] | u_score_store_sd/controller/page_reader/n1468_s85/F
14.484 | 0.487 | tNET | RR | 1 | R49C54[1][B] | u_score_store_sd/controller/page_reader/n1468_s81/I0
15.001 | 0.516 | tINS | RR | 1 | R49C54[1][B] | u_score_store_sd/controller/page_reader/n1468_s81/F
15.158 | 0.157 | tNET | RR | 1 | R50C54[1][A] | u_score_store_sd/controller/page_reader/n1468_s79/I0
15.674 | 0.516 | tINS | RR | 1 | R50C54[1][A] | u_score_store_sd/controller/page_reader/n1468_s79/F
15.677 | 0.003 | tNET | RR | 1 | R50C54[1][B] | u_score_store_sd/controller/page_reader/n1468_s74/I1
15.939 | 0.262 | tINS | RR | 2 | R50C54[1][B] | u_score_store_sd/controller/page_reader/n1468_s74/F
16.099 | 0.160 | tNET | RR | 1 | R49C54[2][B] | u_score_store_sd/controller/page_reader/n1468_s72/I2
16.626 | 0.526 | tINS | RR | 1 | R49C54[2][B] | u_score_store_sd/controller/page_reader/n1468_s72/F
16.628 | 0.003 | tNET | RR | 1 | R49C54[3][A] | u_score_store_sd/controller/page_reader/n1468_s64/I2
17.126 | 0.498 | tINS | RR | 2 | R49C54[3][A] | u_score_store_sd/controller/page_reader/n1468_s64/F
17.666 | 0.540 | tNET | RR | 1 | R52C54[1][A] | u_score_store_sd/controller/page_reader/n1468_s51/I1
17.928 | 0.262 | tINS | RR | 3 | R52C54[1][A] | u_score_store_sd/controller/page_reader/n1468_s51/F
18.416 | 0.487 | tNET | RR | 1 | R50C53[3][B] | u_score_store_sd/controller/page_reader/n1468_s42/I0
18.913 | 0.498 | tINS | RR | 1 | R50C53[3][B] | u_score_store_sd/controller/page_reader/n1468_s42/F
19.071 | 0.157 | tNET | RR | 1 | R50C52[3][B] | u_score_store_sd/controller/page_reader/n1468_s36/I0
19.592 | 0.521 | tINS | RR | 3 | R50C52[3][B] | u_score_store_sd/controller/page_reader/n1468_s36/F
19.944 | 0.352 | tNET | RR | 1 | R48C52[3][B] | u_score_store_sd/controller/page_reader/n1468_s33/I0
20.442 | 0.498 | tINS | RR | 23 | R48C52[3][B] | u_score_store_sd/controller/page_reader/n1468_s33/F
20.612 | 0.170 | tNET | RR | 1 | R49C52[1][A] | u_score_store_sd/controller/page_reader/selected_page_index_5_s3/I0
21.128 | 0.516 | tINS | RR | 7 | R49C52[1][A] | u_score_store_sd/controller/page_reader/selected_page_index_5_s3/F
21.734 | 0.606 | tNET | RR | 1 | R48C50[0][B] | u_score_store_sd/controller/page_reader/streaming_s3/I3
22.196 | 0.461 | tINS | RR | 1 | R48C50[0][B] | u_score_store_sd/controller/page_reader/streaming_s3/F
22.333 | 0.137 | tNET | RR | 1 | R48C50[1][A] | u_score_store_sd/controller/page_reader/streaming_s1/CE

Data Required Path:

AT | DELAY | TYPE | RF | FANOUT | LOC | NODE
20.000 | 20.000 | | | | | active clock edge time
20.000 | 0.000 | | | | | sys_clk
20.000 | 0.000 | tCL | RR | 1 | IOB117[B] | sys_clk_ibuf/I
20.683 | 0.683 | tINS | RR | 13930 | IOB117[B] | sys_clk_ibuf/O
23.844 | 3.161 | tNET | RR | 1 | R48C50[1][A] | u_score_store_sd/controller/page_reader/streaming_s1/CLK
23.532 | -0.311 | tSu | | 1 | R48C50[1][A] | u_score_store_sd/controller/page_reader/streaming_s1

Path Statistics:

Clock Skew | -0.504
Setup Relationship | 20.000
Logic Level | 21
Arrival Clock Path Delay | cell: 0.683, 15.696%; route: 3.666, 84.304%
Arrival Data Path Delay | cell: 8.524, 47.394%; route: 9.079, 50.480%; tC2Q: 0.382, 2.127%
Required Clock Path Delay | cell: 0.683, 17.756%; route: 3.161, 82.244%

### Hold Analysis Report

#### Report Command:report_timing -hold -max_paths 25 -max_common_paths 1

### Path1

Path Summary:

Slack | 0.095
Data Arrival Time | 2.384
Data Required Time | 2.288
From | u_score_page_cache/packed_index_9_s1
To | u_score_page_cache/page_mem_page_mem_2_1_s
Launch Clk | sys_clk:[R]
Latch Clk | sys_clk:[R]

Data Arrival Path:

AT | DELAY | TYPE | RF | FANOUT | LOC | NODE
0.000 | 0.000 | | | | | active clock edge time
0.000 | 0.000 | | | | | sys_clk
0.000 | 0.000 | tCL | RR | 1 | IOB117[B] | sys_clk_ibuf/I
0.675 | 0.675 | tINS | RR | 13930 | IOB117[B] | sys_clk_ibuf/O
2.046 | 1.371 | tNET | RR | 1 | R46C6[2][B] | u_score_page_cache/packed_index_9_s1/CLK
2.191 | 0.144 | tC2Q | RR | 29 | R46C6[2][B] | u_score_page_cache/packed_index_9_s1/Q
2.384 | 0.193 | tNET | RR | 1 | BSRAM_R38[0][B] | u_score_page_cache/page_mem_page_mem_2_1_s/ADA[9]

Data Required Path:

AT | DELAY | TYPE | RF | FANOUT | LOC | NODE
0.000 | 0.000 | | | | | active clock edge time
0.000 | 0.000 | | | | | sys_clk
0.000 | 0.000 | tCL | RR | 1 | IOB117[B] | sys_clk_ibuf/I
0.675 | 0.675 | tINS | RR | 13930 | IOB117[B] | sys_clk_ibuf/O
2.251 | 1.576 | tNET | RR | 1 | BSRAM_R38[0][B] | u_score_page_cache/page_mem_page_mem_2_1_s/CLKA
2.288 | 0.037 | tHld | | 1 | BSRAM_R38[0][B] | u_score_page_cache/page_mem_page_mem_2_1_s

Path Statistics:

Clock Skew | 0.205
Hold Relationship | 0.000
Logic Level | 1
Arrival Clock Path Delay | cell: 0.675, 33.008%; route: 1.371, 66.992%
Arrival Data Path Delay | cell: 0.000, 0.000%; route: 0.193, 57.270%; tC2Q: 0.144, 42.730%
Required Clock Path Delay | cell: 0.675, 30.002%; route: 1.576, 69.998%

### Path2

Path Summary:

Slack | 0.101
Data Arrival Time | 2.389
Data Required Time | 2.288
From | u_score_page_cache/packed_index_1_s1
To | u_score_page_cache/page_mem_page_mem_2_1_s
Launch Clk | sys_clk:[R]
Latch Clk | sys_clk:[R]

Data Arrival Path:

AT | DELAY | TYPE | RF | FANOUT | LOC | NODE
0.000 | 0.000 | | | | | active clock edge time
0.000 | 0.000 | | | | | sys_clk
0.000 | 0.000 | tCL | RR | 1 | IOB117[B] | sys_clk_ibuf/I
0.675 | 0.675 | tINS | RR | 13930 | IOB117[B] | sys_clk_ibuf/O
2.050 | 1.375 | tNET | RR | 1 | R46C7[3][A] | u_score_page_cache/packed_index_1_s1/CLK
2.194 | 0.144 | tC2Q | RR | 29 | R46C7[3][A] | u_score_page_cache/packed_index_1_s1/Q
2.389 | 0.195 | tNET | RR | 1 | BSRAM_R38[0][B] | u_score_page_cache/page_mem_page_mem_2_1_s/ADA[1]

Data Required Path:

AT | DELAY | TYPE | RF | FANOUT | LOC | NODE
0.000 | 0.000 | | | | | active clock edge time
0.000 | 0.000 | | | | | sys_clk
0.000 | 0.000 | tCL | RR | 1 | IOB117[B] | sys_clk_ibuf/I
0.675 | 0.675 | tINS | RR | 13930 | IOB117[B] | sys_clk_ibuf/O
2.251 | 1.576 | tNET | RR | 1 | BSRAM_R38[0][B] | u_score_page_cache/page_mem_page_mem_2_1_s/CLKA
2.288 | 0.037 | tHld | | 1 | BSRAM_R38[0][B] | u_score_page_cache/page_mem_page_mem_2_1_s

Path Statistics:

Clock Skew | 0.201
Hold Relationship | 0.000
Logic Level | 1
Arrival Clock Path Delay | cell: 0.675, 32.943%; route: 1.375, 67.057%
Arrival Data Path Delay | cell: 0.000, 0.000%; route: 0.195, 57.522%; tC2Q: 0.144, 42.478%
Required Clock Path Delay | cell: 0.675, 30.002%; route: 1.576, 69.998%

### Path3

Path Summary:

Slack | 0.101
Data Arrival Time | 2.385
Data Required Time | 2.284
From | u_score_page_cache/packed_index_9_s1
To | u_score_page_cache/page_mem_page_mem_0_1_s
Launch Clk | sys_clk:[R]
Latch Clk | sys_clk:[R]

Data Arrival Path:

AT | DELAY | TYPE | RF | FANOUT | LOC | NODE
0.000 | 0.000 | | | | | active clock edge time
0.000 | 0.000 | | | | | sys_clk
0.000 | 0.000 | tCL | RR | 1 | IOB117[B] | sys_clk_ibuf/I
0.675 | 0.675 | tINS | RR | 13930 | IOB117[B] | sys_clk_ibuf/O
2.046 | 1.371 | tNET | RR | 1 | R46C6[2][B] | u_score_page_cache/packed_index_9_s1/CLK
2.191 | 0.144 | tC2Q | RR | 29 | R46C6[2][B] | u_score_page_cache/packed_index_9_s1/Q
2.385 | 0.195 | tNET | RR | 1 | BSRAM_R38[0][A] | u_score_page_cache/page_mem_page_mem_0_1_s/ADA[9]

Data Required Path:

AT | DELAY | TYPE | RF | FANOUT | LOC | NODE
0.000 | 0.000 | | | | | active clock edge time
0.000 | 0.000 | | | | | sys_clk
0.000 | 0.000 | tCL | RR | 1 | IOB117[B] | sys_clk_ibuf/I
0.675 | 0.675 | tINS | RR | 13930 | IOB117[B] | sys_clk_ibuf/O
2.247 | 1.572 | tNET | RR | 1 | BSRAM_R38[0][A] | u_score_page_cache/page_mem_page_mem_0_1_s/CLKA
2.284 | 0.037 | tHld | | 1 | BSRAM_R38[0][A] | u_score_page_cache/page_mem_page_mem_0_1_s

Path Statistics:

Clock Skew | 0.201
Hold Relationship | 0.000
Logic Level | 1
Arrival Clock Path Delay | cell: 0.675, 33.008%; route: 1.371, 66.992%
Arrival Data Path Delay | cell: 0.000, 0.000%; route: 0.195, 57.522%; tC2Q: 0.144, 42.478%
Required Clock Path Delay | cell: 0.675, 30.056%; route: 1.572, 69.944%

### Path4

Path Summary:

Slack | 0.107
Data Arrival Time | 2.391
Data Required Time | 2.284
From | u_score_page_cache/packed_index_1_s1
To | u_score_page_cache/page_mem_page_mem_0_1_s
Launch Clk | sys_clk:[R]
Latch Clk | sys_clk:[R]

Data Arrival Path:

AT | DELAY | TYPE | RF | FANOUT | LOC | NODE
0.000 | 0.000 | | | | | active clock edge time
0.000 | 0.000 | | | | | sys_clk
0.000 | 0.000 | tCL | RR | 1 | IOB117[B] | sys_clk_ibuf/I
0.675 | 0.675 | tINS | RR | 13930 | IOB117[B] | sys_clk_ibuf/O
2.050 | 1.375 | tNET | RR | 1 | R46C7[3][A] | u_score_page_cache/packed_index_1_s1/CLK
2.194 | 0.144 | tC2Q | RR | 29 | R46C7[3][A] | u_score_page_cache/packed_index_1_s1/Q
2.391 | 0.197 | tNET | RR | 1 | BSRAM_R38[0][A] | u_score_page_cache/page_mem_page_mem_0_1_s/ADA[1]

Data Required Path:

AT | DELAY | TYPE | RF | FANOUT | LOC | NODE
0.000 | 0.000 | | | | | active clock edge time
0.000 | 0.000 | | | | | sys_clk
0.000 | 0.000 | tCL | RR | 1 | IOB117[B] | sys_clk_ibuf/I
0.675 | 0.675 | tINS | RR | 13930 | IOB117[B] | sys_clk_ibuf/O
2.247 | 1.572 | tNET | RR | 1 | BSRAM_R38[0][A] | u_score_page_cache/page_mem_page_mem_0_1_s/CLKA
2.284 | 0.037 | tHld | | 1 | BSRAM_R38[0][A] | u_score_page_cache/page_mem_page_mem_0_1_s

Path Statistics:

Clock Skew | 0.197
Hold Relationship | 0.000
Logic Level | 1
Arrival Clock Path Delay | cell: 0.675, 32.943%; route: 1.375, 67.057%
Arrival Data Path Delay | cell: 0.000, 0.000%; route: 0.197, 57.771%; tC2Q: 0.144, 42.229%
Required Clock Path Delay | cell: 0.675, 30.056%; route: 1.572, 69.944%

### Path5

Path Summary:

Slack | 0.138
Data Arrival Time | 2.423
Data Required Time | 2.284
From | u_score_page_cache/packed_index_13_s1
To | u_score_page_cache/page_mem_page_mem_0_1_s
Launch Clk | sys_clk:[R]
Latch Clk | sys_clk:[R]

Data Arrival Path:

AT | DELAY | TYPE | RF | FANOUT | LOC | NODE
0.000 | 0.000 | | | | | active clock edge time
0.000 | 0.000 | | | | | sys_clk
0.000 | 0.000 | tCL | RR | 1 | IOB117[B] | sys_clk_ibuf/I
0.675 | 0.675 | tINS | RR | 13930 | IOB117[B] | sys_clk_ibuf/O
2.046 | 1.371 | tNET | RR | 1 | R46C6[2][A] | u_score_page_cache/packed_index_13_s1/CLK
2.191 | 0.144 | tC2Q | RR | 27 | R46C6[2][A] | u_score_page_cache/packed_index_13_s1/Q
2.423 | 0.232 | tNET | RR | 1 | BSRAM_R38[0][A] | u_score_page_cache/page_mem_page_mem_0_1_s/ADA[13]

Data Required Path:

AT | DELAY | TYPE | RF | FANOUT | LOC | NODE
0.000 | 0.000 | | | | | active clock edge time
0.000 | 0.000 | | | | | sys_clk
0.000 | 0.000 | tCL | RR | 1 | IOB117[B] | sys_clk_ibuf/I
0.675 | 0.675 | tINS | RR | 13930 | IOB117[B] | sys_clk_ibuf/O
2.247 | 1.572 | tNET | RR | 1 | BSRAM_R38[0][A] | u_score_page_cache/page_mem_page_mem_0_1_s/CLKA
2.284 | 0.037 | tHld | | 1 | BSRAM_R38[0][A] | u_score_page_cache/page_mem_page_mem_0_1_s

Path Statistics:

Clock Skew | 0.201
Hold Relationship | 0.000
Logic Level | 1
Arrival Clock Path Delay | cell: 0.675, 33.008%; route: 1.371, 66.992%
Arrival Data Path Delay | cell: 0.000, 0.000%; route: 0.232, 61.702%; tC2Q: 0.144, 38.298%
Required Clock Path Delay | cell: 0.675, 30.056%; route: 1.572, 69.944%

### Path6

Path Summary:

Slack | 0.147
Data Arrival Time | 2.431
Data Required Time | 2.284
From | u_score_page_cache/packed_index_12_s1
To | u_score_page_cache/page_mem_page_mem_0_1_s
Launch Clk | sys_clk:[R]
Latch Clk | sys_clk:[R]

Data Arrival Path:

AT | DELAY | TYPE | RF | FANOUT | LOC | NODE
0.000 | 0.000 | | | | | active clock edge time
0.000 | 0.000 | | | | | sys_clk
0.000 | 0.000 | tCL | RR | 1 | IOB117[B] | sys_clk_ibuf/I
0.675 | 0.675 | tINS | RR | 13930 | IOB117[B] | sys_clk_ibuf/O
2.050 | 1.375 | tNET | RR | 1 | R42C3[1][B] | u_score_page_cache/packed_index_12_s1/CLK
2.194 | 0.144 | tC2Q | RR | 28 | R42C3[1][B] | u_score_page_cache/packed_index_12_s1/Q
2.431 | 0.237 | tNET | RR | 1 | BSRAM_R38[0][A] | u_score_page_cache/page_mem_page_mem_0_1_s/ADA[12]

Data Required Path:

AT | DELAY | TYPE | RF | FANOUT | LOC | NODE
0.000 | 0.000 | | | | | active clock edge time
0.000 | 0.000 | | | | | sys_clk
0.000 | 0.000 | tCL | RR | 1 | IOB117[B] | sys_clk_ibuf/I
0.675 | 0.675 | tINS | RR | 13930 | IOB117[B] | sys_clk_ibuf/O
2.247 | 1.572 | tNET | RR | 1 | BSRAM_R38[0][A] | u_score_page_cache/page_mem_page_mem_0_1_s/CLKA
2.284 | 0.037 | tHld | | 1 | BSRAM_R38[0][A] | u_score_page_cache/page_mem_page_mem_0_1_s

Path Statistics:

Clock Skew | 0.197
Hold Relationship | 0.000
Logic Level | 1
Arrival Clock Path Delay | cell: 0.675, 32.943%; route: 1.375, 67.057%
Arrival Data Path Delay | cell: 0.000, 0.000%; route: 0.237, 62.205%; tC2Q: 0.144, 37.795%
Required Clock Path Delay | cell: 0.675, 30.056%; route: 1.572, 69.944%

### Path7

Path Summary:

Slack | 0.155
Data Arrival Time | 2.440
Data Required Time | 2.284
From | u_score_page_cache/packed_index_5_s1
To | u_score_page_cache/page_mem_page_mem_0_1_s
Launch Clk | sys_clk:[R]
Latch Clk | sys_clk:[R]

Data Arrival Path:

AT | DELAY | TYPE | RF | FANOUT | LOC | NODE
0.000 | 0.000 | | | | | active clock edge time
0.000 | 0.000 | | | | | sys_clk
0.000 | 0.000 | tCL | RR | 1 | IOB117[B] | sys_clk_ibuf/I
0.675 | 0.675 | tINS | RR | 13930 | IOB117[B] | sys_clk_ibuf/O
2.046 | 1.371 | tNET | RR | 1 | R46C6[3][A] | u_score_page_cache/packed_index_5_s1/CLK
2.191 | 0.144 | tC2Q | RR | 28 | R46C6[3][A] | u_score_page_cache/packed_index_5_s1/Q
2.440 | 0.249 | tNET | RR | 1 | BSRAM_R38[0][A] | u_score_page_cache/page_mem_page_mem_0_1_s/ADA[5]

Data Required Path:

AT | DELAY | TYPE | RF | FANOUT | LOC | NODE
0.000 | 0.000 | | | | | active clock edge time
0.000 | 0.000 | | | | | sys_clk
0.000 | 0.000 | tCL | RR | 1 | IOB117[B] | sys_clk_ibuf/I
0.675 | 0.675 | tINS | RR | 13930 | IOB117[B] | sys_clk_ibuf/O
2.247 | 1.572 | tNET | RR | 1 | BSRAM_R38[0][A] | u_score_page_cache/page_mem_page_mem_0_1_s/CLKA
2.284 | 0.037 | tHld | | 1 | BSRAM_R38[0][A] | u_score_page_cache/page_mem_page_mem_0_1_s

Path Statistics:

Clock Skew | 0.201
Hold Relationship | 0.000
Logic Level | 1
Arrival Clock Path Delay | cell: 0.675, 33.008%; route: 1.371, 66.992%
Arrival Data Path Delay | cell: 0.000, 0.000%; route: 0.249, 63.359%; tC2Q: 0.144, 36.641%
Required Clock Path Delay | cell: 0.675, 30.056%; route: 1.572, 69.944%

### Path8

Path Summary:

Slack | 0.159
Data Arrival Time | 2.444
Data Required Time | 2.284
From | u_score_page_cache/packed_index_3_s1
To | u_score_page_cache/page_mem_page_mem_0_1_s
Launch Clk | sys_clk:[R]
Latch Clk | sys_clk:[R]

Data Arrival Path:

AT | DELAY | TYPE | RF | FANOUT | LOC | NODE
0.000 | 0.000 | | | | | active clock edge time
0.000 | 0.000 | | | | | sys_clk
0.000 | 0.000 | tCL | RR | 1 | IOB117[B] | sys_clk_ibuf/I
0.675 | 0.675 | tINS | RR | 13930 | IOB117[B] | sys_clk_ibuf/O
2.050 | 1.375 | tNET | RR | 1 | R42C3[1][A] | u_score_page_cache/packed_index_3_s1/CLK
2.194 | 0.144 | tC2Q | RR | 27 | R42C3[1][A] | u_score_page_cache/packed_index_3_s1/Q
2.444 | 0.249 | tNET | RR | 1 | BSRAM_R38[0][A] | u_score_page_cache/page_mem_page_mem_0_1_s/ADA[3]

Data Required Path:

AT | DELAY | TYPE | RF | FANOUT | LOC | NODE
0.000 | 0.000 | | | | | active clock edge time
0.000 | 0.000 | | | | | sys_clk
0.000 | 0.000 | tCL | RR | 1 | IOB117[B] | sys_clk_ibuf/I
0.675 | 0.675 | tINS | RR | 13930 | IOB117[B] | sys_clk_ibuf/O
2.247 | 1.572 | tNET | RR | 1 | BSRAM_R38[0][A] | u_score_page_cache/page_mem_page_mem_0_1_s/CLKA
2.284 | 0.037 | tHld | | 1 | BSRAM_R38[0][A] | u_score_page_cache/page_mem_page_mem_0_1_s

Path Statistics:

Clock Skew | 0.197
Hold Relationship | 0.000
Logic Level | 1
Arrival Clock Path Delay | cell: 0.675, 32.943%; route: 1.375, 67.057%
Arrival Data Path Delay | cell: 0.000, 0.000%; route: 0.249, 63.359%; tC2Q: 0.144, 36.641%
Required Clock Path Delay | cell: 0.675, 30.056%; route: 1.572, 69.944%

### Path9

Path Summary:

Slack | 0.169
Data Arrival Time | 2.454
Data Required Time | 2.284
From | u_score_page_cache/packed_index_7_s1
To | u_score_page_cache/page_mem_page_mem_0_1_s
Launch Clk | sys_clk:[R]
Latch Clk | sys_clk:[R]

Data Arrival Path:

AT | DELAY | TYPE | RF | FANOUT | LOC | NODE
0.000 | 0.000 | | | | | active clock edge time
0.000 | 0.000 | | | | | sys_clk
0.000 | 0.000 | tCL | RR | 1 | IOB117[B] | sys_clk_ibuf/I
0.675 | 0.675 | tINS | RR | 13930 | IOB117[B] | sys_clk_ibuf/O
2.050 | 1.375 | tNET | RR | 1 | R46C7[1][A] | u_score_page_cache/packed_index_7_s1/CLK
2.191 | 0.141 | tC2Q | RF | 28 | R46C7[1][A] | u_score_page_cache/packed_index_7_s1/Q
2.454 | 0.262 | tNET | FF | 1 | BSRAM_R38[0][A] | u_score_page_cache/page_mem_page_mem_0_1_s/ADA[7]

Data Required Path:

AT | DELAY | TYPE | RF | FANOUT | LOC | NODE
0.000 | 0.000 | | | | | active clock edge time
0.000 | 0.000 | | | | | sys_clk
0.000 | 0.000 | tCL | RR | 1 | IOB117[B] | sys_clk_ibuf/I
0.675 | 0.675 | tINS | RR | 13930 | IOB117[B] | sys_clk_ibuf/O
2.247 | 1.572 | tNET | RR | 1 | BSRAM_R38[0][A] | u_score_page_cache/page_mem_page_mem_0_1_s/CLKA
2.284 | 0.037 | tHld | | 1 | BSRAM_R38[0][A] | u_score_page_cache/page_mem_page_mem_0_1_s

Path Statistics:

Clock Skew | 0.197
Hold Relationship | 0.000
Logic Level | 1
Arrival Clock Path Delay | cell: 0.675, 32.943%; route: 1.375, 67.057%
Arrival Data Path Delay | cell: 0.000, 0.000%; route: 0.262, 65.012%; tC2Q: 0.141, 34.988%
Required Clock Path Delay | cell: 0.675, 30.056%; route: 1.572, 69.944%

### Path10

Path Summary:

Slack | 0.171
Data Arrival Time | 2.460
Data Required Time | 2.288
From | u_score_page_cache/packed_index_11_s1
To | u_score_page_cache/page_mem_page_mem_2_1_s
Launch Clk | sys_clk:[R]
Latch Clk | sys_clk:[R]

Data Arrival Path:

AT | DELAY | TYPE | RF | FANOUT | LOC | NODE
0.000 | 0.000 | | | | | active clock edge time
0.000 | 0.000 | | | | | sys_clk
0.000 | 0.000 | tCL | RR | 1 | IOB117[B] | sys_clk_ibuf/I
0.675 | 0.675 | tINS | RR | 13930 | IOB117[B] | sys_clk_ibuf/O
2.046 | 1.371 | tNET | RR | 1 | R46C6[1][B] | u_score_page_cache/packed_index_11_s1/CLK
2.191 | 0.144 | tC2Q | RR | 27 | R46C6[1][B] | u_score_page_cache/packed_index_11_s1/Q
2.460 | 0.269 | tNET | RR | 1 | BSRAM_R38[0][B] | u_score_page_cache/page_mem_page_mem_2_1_s/ADA[11]

Data Required Path:

AT | DELAY | TYPE | RF | FANOUT | LOC | NODE
0.000 | 0.000 | | | | | active clock edge time
0.000 | 0.000 | | | | | sys_clk
0.000 | 0.000 | tCL | RR | 1 | IOB117[B] | sys_clk_ibuf/I
0.675 | 0.675 | tINS | RR | 13930 | IOB117[B] | sys_clk_ibuf/O
2.251 | 1.576 | tNET | RR | 1 | BSRAM_R38[0][B] | u_score_page_cache/page_mem_page_mem_2_1_s/CLKA
2.288 | 0.037 | tHld | | 1 | BSRAM_R38[0][B] | u_score_page_cache/page_mem_page_mem_2_1_s

Path Statistics:

Clock Skew | 0.205
Hold Relationship | 0.000
Logic Level | 1
Arrival Clock Path Delay | cell: 0.675, 33.008%; route: 1.371, 66.992%
Arrival Data Path Delay | cell: 0.000, 0.000%; route: 0.269, 65.133%; tC2Q: 0.144, 34.867%
Required Clock Path Delay | cell: 0.675, 30.002%; route: 1.576, 69.998%
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
